MrMil/led-over-rj245/docs/field_docs/README.md

# Field docs

Path: [docs](../README.md) › **field_docs**
Parent: [../README.md](../README.md)

**Covers:** the human documentation — `README.md` and `guide/` — and the wiring diagrams in
`guide/img/`, generated by `tools/wiring_diagrams.py`.
**Code:** `README.md`, `guide/*.md`, `guide/img/*.svg`, `tools/wiring_diagrams.py`

## Design

### Decisions

- **The human guide roots at `README.md` and lives in `guide/`, apart from `docs/`** (owner,
  2026-10-09). The installation is erected and run by a crew the owner is not part of, who are
  not familiar with the design, reading on a phone at Midburn by opening the repo on GitHub.
  `docs/` is for agents and is about *why*; `guide/` is about *what to do*.
- **No backstory in the guide** (owner). It states facts and steps; it does not narrate who it
  is for or why it was written.
- **Build-specific only, written for experienced burners and makers** (owner, 2026-10-09).
  "Connect this to that", pin tables, settings, checks. No generic burn, site or tool advice
  (permission to dig, shade, MOOP, how a phone joins WiFi, what a WLED button does). The
  reader knows those, and including them reads as condescending.
  **Changed 2026-10-09:** the first version explained generic steps at length; the owner
  rejected it.
- **Phone-first formatting** (agent, 2026-10-09). Short sections, tables of at most four
  columns, no wide code blocks; GitHub renders Markdown and SVG in mobile browsers.
- **Troubleshooting is symptom → check, using swap tests** (agent, 2026-10-09). The
  installation is made of twins (statue boxes, cables, channels), so swapping isolates most
  faults with no instruments.
- **The crew never opens a box** (owner, 2026-10-28, told to the crew directly: there is
  exposed 230 V inside). So the guide carries nothing about the mains side of a box, including
  the C14 inlet wiring ([../strips_and_power/power_distribution.md](../strips_and_power/power_distribution.md),
  Gotchas). The troubleshooting steps that need a box open (swapping a 74AHCT125, a receiver
  or the ESP32, re-seating pigtails on screw terminals) stay, behind a warning at the top of
  `guide/troubleshooting.md`: call the owner before opening any box, and if he does not pick
  up, do not open it (owner, 2026-10-28). They are the only field fix for those faults, and
  the call puts the owner in the loop on the mains hazard before anyone reaches in.
- **The guide never mentions the inlet fuses** (owner, 2026-10-29). Every C14 inlet carries
  a spare fuse in its drawer, and the owner does not want the crew in there: a box that stays
  dead after cooling is a call to the owner. `guide/troubleshooting.md` says so; the spares
  bag carries no fuses. **Changed 2026-10-29:** previously the troubleshooting step was to
  check and replace the fuse, and the bag held spares.
- **Nothing is repaired on site, so the field spares are only what plugs in** (owner,
  2026-10-29: "the crew can't solder in the field"; "I have to make new ones and send it to
  them - they don't repair anything"). The bag holds the ESP32, MAX485 modules, 74AHCT125s
  and CAT5e; no strips, bespoke cables, XT60 or JST-SM pairs, solder or ferrules. A dead
  strip or damaged cable is reported to the owner, who makes a new one.
- **The crew pages use crew words, not part names; the owner's pages use part names** (owner,
  2026-10-29: "use it in places that concern the crew in the field ... the wiring guide is for
  me, I know what those things are"). Crew pages: `README.md`, `guide/setup.md`,
  `guide/operating.md`, `guide/troubleshooting.md`, `guide/inventory.md`. Owner's pages:
  `guide/wiring.md`, `guide/parts.md`, `guide/build.md` and the diagrams. On the crew pages:
  "3-pin LED connector" for JST-SM ("they don't know what JST-SM is"), "kettle lead" for a
  C13 cord (the Hebrew "כבל קומקום"; the English colloquial name, strictly for the C15 but
  used for C13 too) and "inlet" for the C14, "CAT5" for CAT5e, no cable specifications ("they don't need to know
  the specifications"), no enclosure names or wattages, no reels ("they don't know about
  reels"). Chip and module names (74AHCT125, MAX485, ESP32) stay, because the
  troubleshooting swap steps name the physical part the crew must pick out of the bag.
- **Secrets are not in the guide** — see [../firmware/README.md](../firmware/README.md).
- **The guide must stay consistent with these docs.** When a decision here changes something
  a builder or operator does, update the matching guide page in the same change.

## Contents

### Pages

- [`wiring_diagrams.md`](wiring_diagrams.md) — why the diagrams are generated SVG and how they are drawn.

### Not yet documented

- **Guide pages** — `guide/setup.md`, `guide/operating.md`, `guide/troubleshooting.md`, `guide/wiring.md`, `guide/parts.md`, `guide/inventory.md`, `guide/build.md` — content follows the design pages in this tree; page-specific decisions are recorded above. `guide/inventory.md` (owner asked, 2026-10-29) counts what exists, box by box and cable by cable with lengths, where `guide/parts.md` is the shopping list by part; the cable-length margins are in [../strips_and_power/trenches.md](../strips_and_power/trenches.md).

## Related

- [../README.md](../README.md) — the design the guide describes.
- [../strips_and_power/README.md](../strips_and_power/README.md) — exit numbering used throughout the guide.
