MrMil/led-over-rj245/docs/firmware/controller_files.md

# Controller files

Path: [docs](../README.md) › [firmware](README.md) › **controller_files**
Parent: [README.md](README.md)
**Code:** `wled/cfg.json`, `wled/ledmap.json` (generated by `tools/wled_image.py`), `wled/presets.json` (the owner's
playlist, [README.md](README.md) *The show*); the flash procedure below
**Covers:** what is on the controller's filesystem besides the firmware, where each file comes from, and how the whole
thing gets onto an ESP32 over USB. Not the firmware build itself ([parallel_i2s_bus.md](parallel_i2s_bus.md)).

## The files

| File | What | Source |
|---|---|---|
| `cfg.json` | The 14 outputs (pin, LED count, GRB, 118 mA per LED, limiter off), the access point, the show as boot preset, no auto-segments | `tools/wled_image.py` from the GPIO table and tower heights in `tools/wiring_diagrams.py` |
| `ledmap.json` | The rolled 2D map: 14 columns × 111 rows, one column per tower, LED 0 at the bottom, short towers bottom-aligned, `-1` above them | `tools/wled_image.py` |
| `presets.json` | The show | the owner, exported from the Animations tab |

`python3 tools/wled_image.py` rewrites the first two; `wled/presets.json` is never generated.

## Decisions

- **The access point is "Layers-WLED", channel 6, always on** (owner, 2026-10-26, the name and password; channel
  and behaviour from [README.md](README.md)). **Changed 2026-10-26:** the SSID was to avoid the word "WLED"
  (agent, 2026-10-09, so the WLED app and passers-by would not spot it); the owner chose a name with it in.
- **The password goes only into the flashed image, from the `WLED_AP_PASS` environment variable** (agent,
  2026-10-26, carrying out the owner's rule that it is never committed, [README.md](README.md)). `wled/cfg.json`
  in the repository has no `psk` key, so a restore from it keeps whatever password the controller has; the image
  built with `--image` has the key. WLED's own backup does not write the password either (`pskl`, its length,
  only), so a backup from the controller can be committed as it is.
- **The config goes in as a LittleFS image over USB, not through the web UI** (agent, 2026-10-24, from the bench
  in [output_driver.md](output_driver.md)): WLED takes only state JSON over serial, not config, and joining the
  controller's AP from the development machine would cut its internet. The image holds all three files, so one
  flash gives a complete controller; *Restore* in the UI stays the field route ([../field_docs/README.md](../field_docs/README.md),
  `guide/build.md`).
- **The current limiter is off (`maxpwr` 0) and the per-LED current is 118 mA** (limiter off: owner, 2026-10-26;
  118 mA: agent, 2026-10-26). No supply
  reaches its ceiling even at full white ([../strips_and_power/led_power_budget.md](../strips_and_power/led_power_budget.md)),
  WLED's limiter is per output and cannot see supply groups ([README.md](README.md), *No current limiting*), and the
  bench ran with it off. 118 mA is 4 × the measured 29.4 mA at full white, because WLED sees one face per output
  and the tower has four; with the limiter off it only makes the Info page's estimate right.
- **Boot preset 18, brightness 255, no auto-segments** (owner: the show resumes by itself after a power cut; one
  segment over everything is what the presets apply to, [effects_in_browser.md](effects_in_browser.md)).
- **The map carries `width` and `height`**, which is what makes WLED treat the strip as a matrix, so the show's
  2D-only effects (the particle ones, Soap, Hiphotic, Octopus) run; without it they fall back to a static colour.

## Flashing a controller

From `../WLED`, with PlatformIO (installed in a throwaway venv; nothing is installed on the machine):

```
python3 -m venv <dir>/pioenv && <dir>/pioenv/bin/pip install platformio
<dir>/pioenv/bin/pio run -e esp32dev_rj245 -t upload --upload-port /dev/cu.usbserial-XXXX
```

Then the files, from this repository:

```
WLED_AP_PASS=<password> python3 tools/wled_image.py --image <dir>/wled_fs.bin
<dir>/pioenv/bin/python ~/.platformio/packages/tool-esptoolpy/esptool.py --port /dev/cu.usbserial-XXXX write_flash 0x310000 <dir>/wled_fs.bin
```

`0x310000` is the filesystem partition of WLED's 4 MB layout (`tools/WLED_ESP32_4MB_1MB_FS.csv` in the fork), the
board's flash size ([../controller/README.md](../controller/README.md)). The image is built with the `mklittlefs`
PlatformIO fetched for the bench. Flash the firmware first: the firmware upload does not touch the filesystem
partition, and the file image does not touch the firmware, so either can be redone alone.

## Related

- [README.md](README.md) — the show, the preset numbering, the AP decisions these files carry out.
- [parallel_i2s_bus.md](parallel_i2s_bus.md) — the firmware the files sit beside.
- [output_driver.md](output_driver.md) — the bench, where the image route came from.
- [custom_effects.md](custom_effects.md) — the effects the presets can name.
