MrMil/led-over-rj245/art/back1-design.png

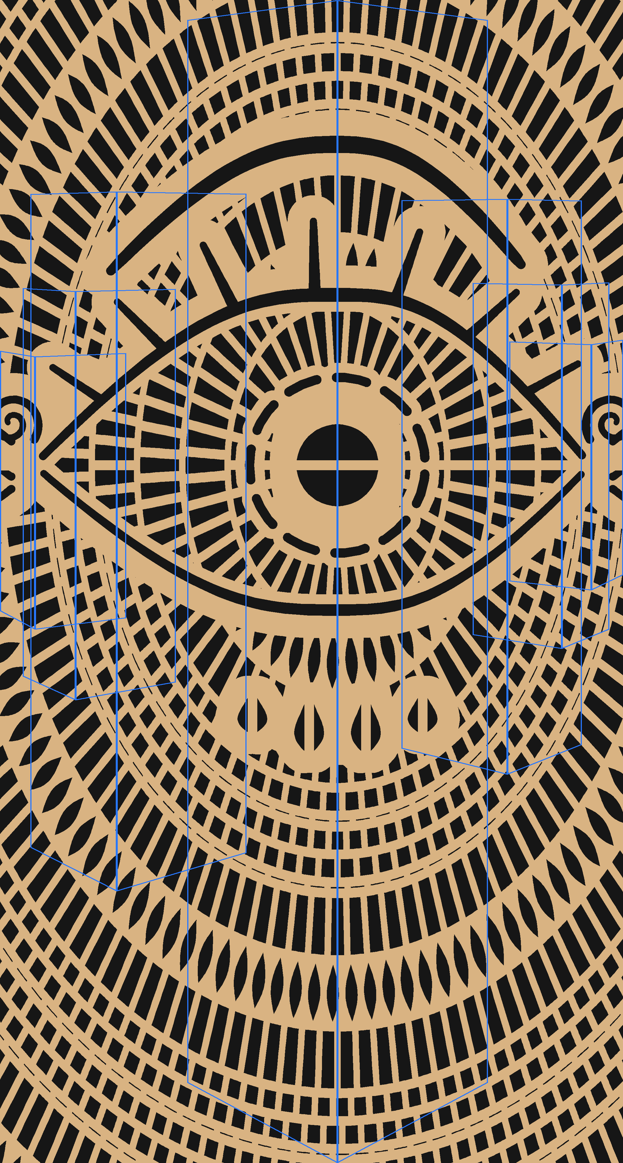
art/back1-design.png
