MrMil/led-over-rj245/art/back1-preview.png

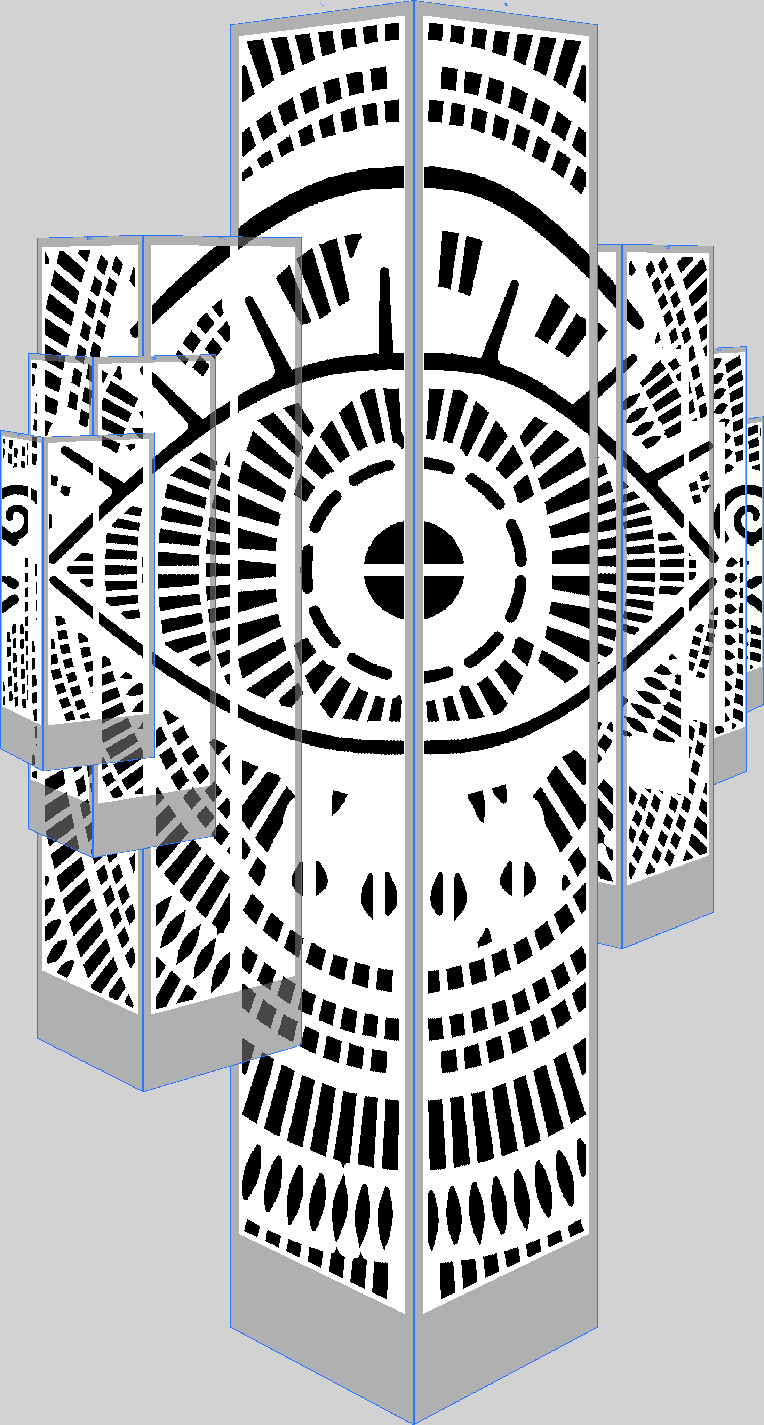
art/back1-preview.png
