MrMil/led-over-rj245/art/back1-towers.png

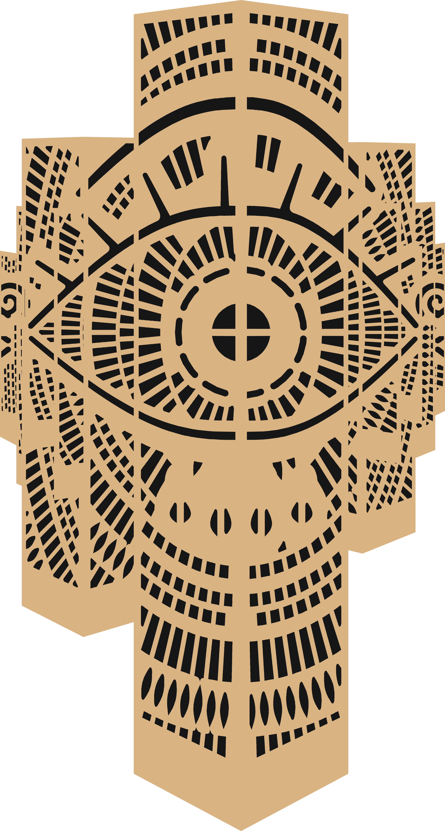
art/back1-towers.png
