MrMil/led-over-rj245/art/back1.png

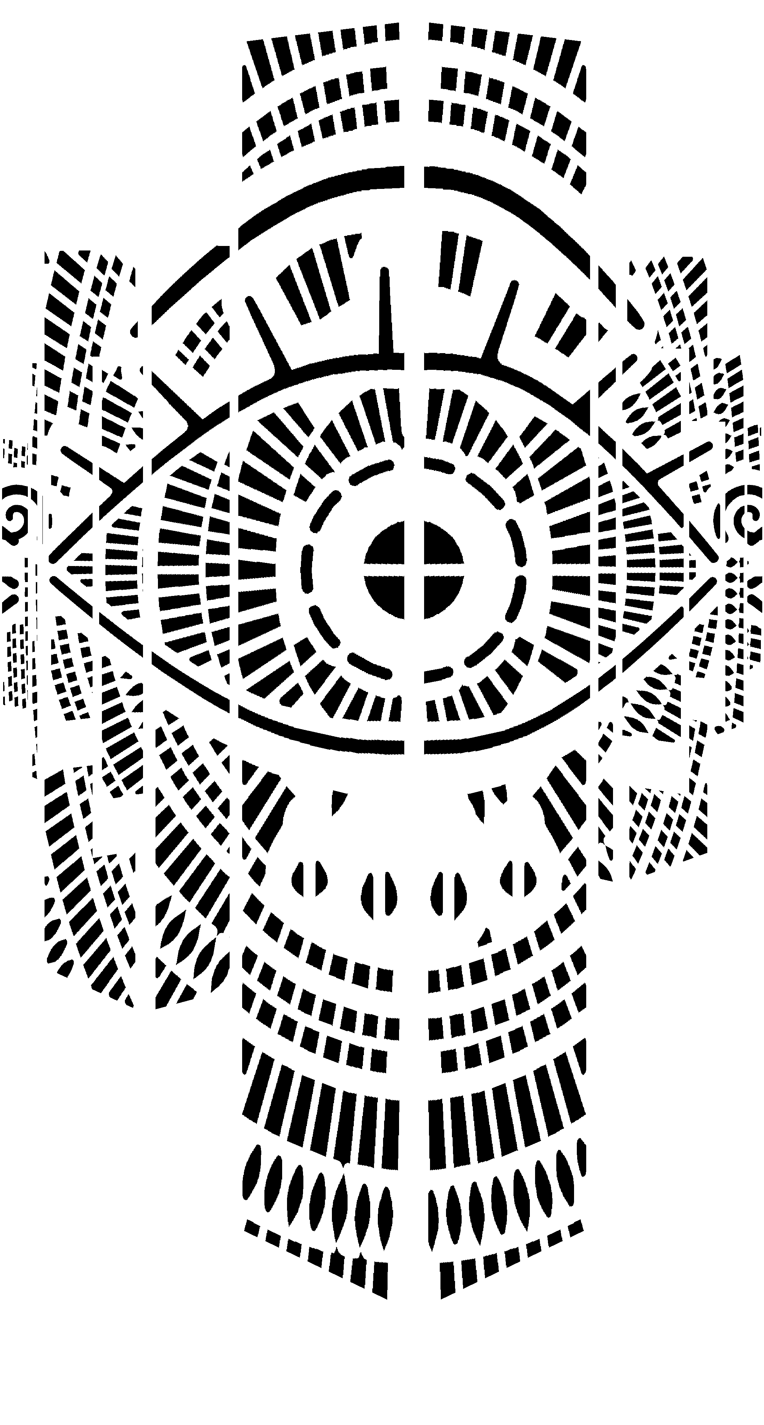
art/back1.png
