MrMil/led-over-rj245/art/back2-design.png

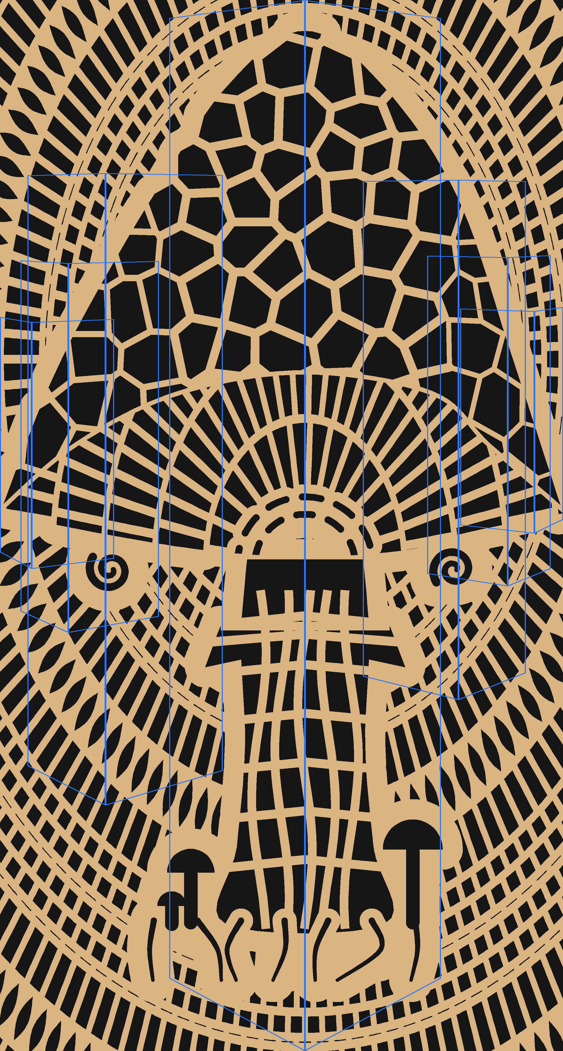
art/back2-design.png
