MrMil/led-over-rj245/art/back2-preview.png

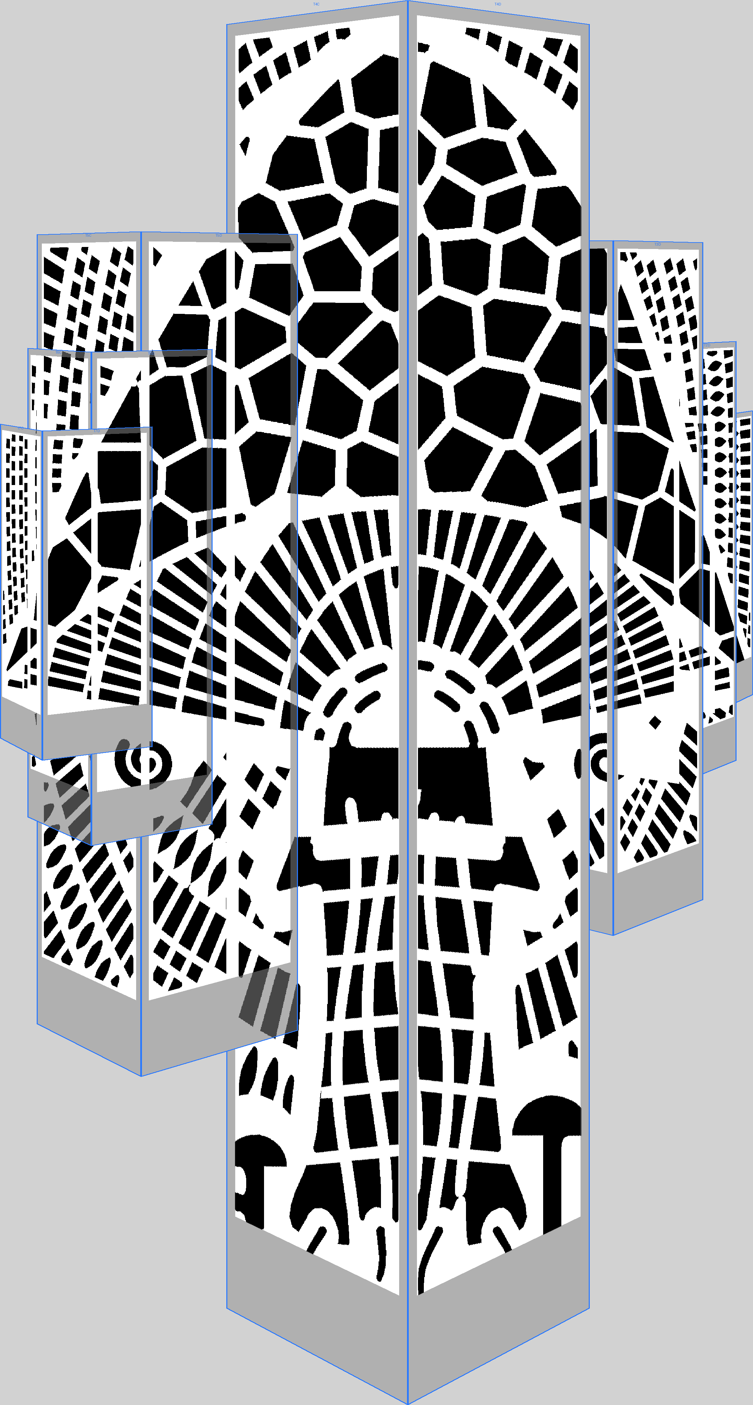
art/back2-preview.png
