MrMil/led-over-rj245/art/back2-towers.png

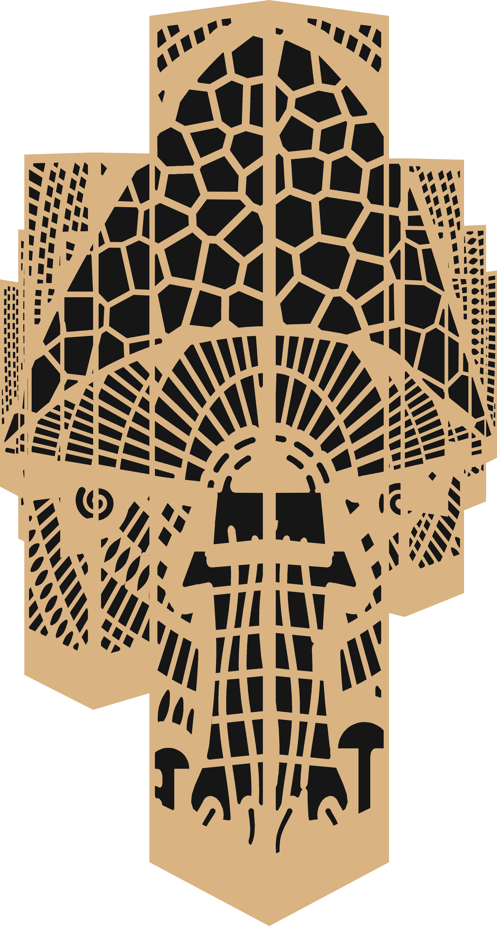
art/back2-towers.png
