MrMil/led-over-rj245/art/back2.png

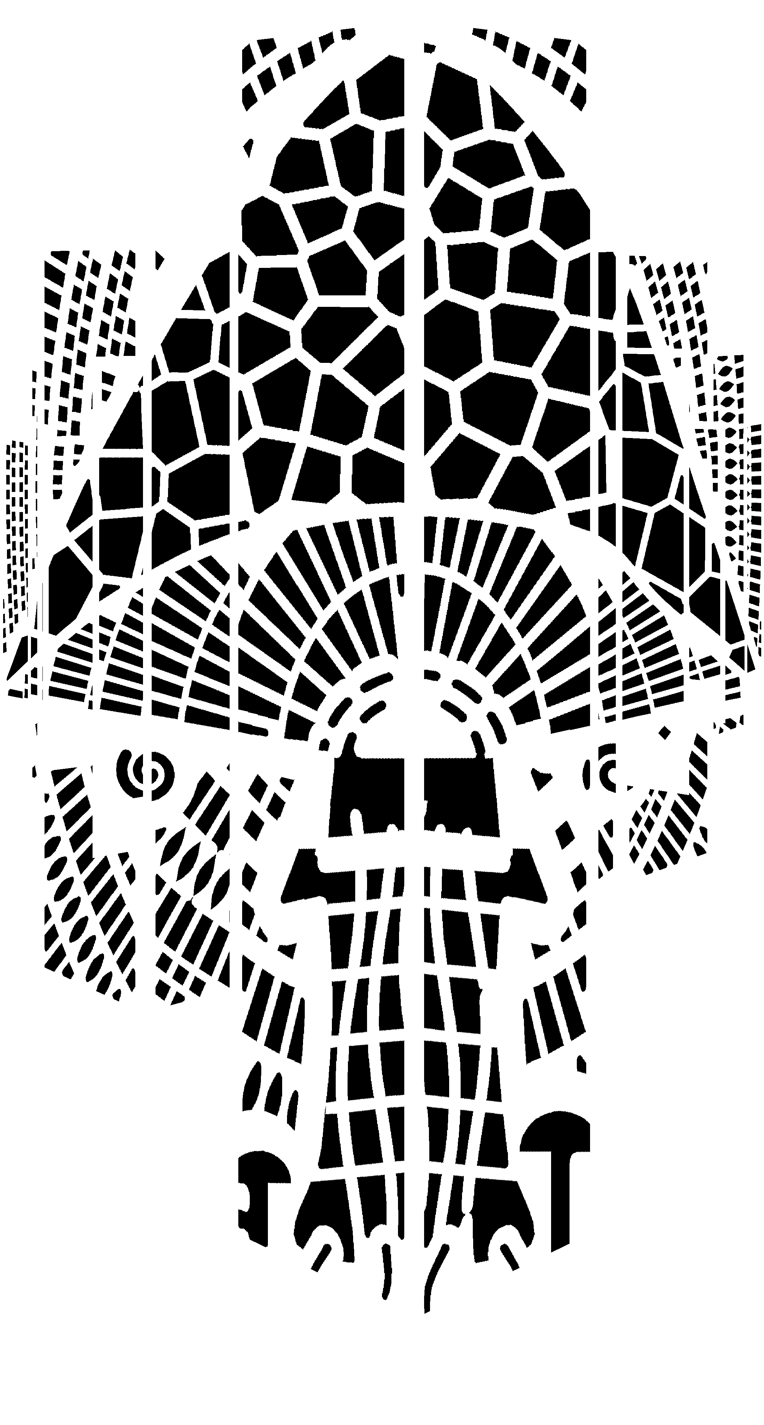
art/back2.png
