MrMil/led-over-rj245/art/bench1-design.png

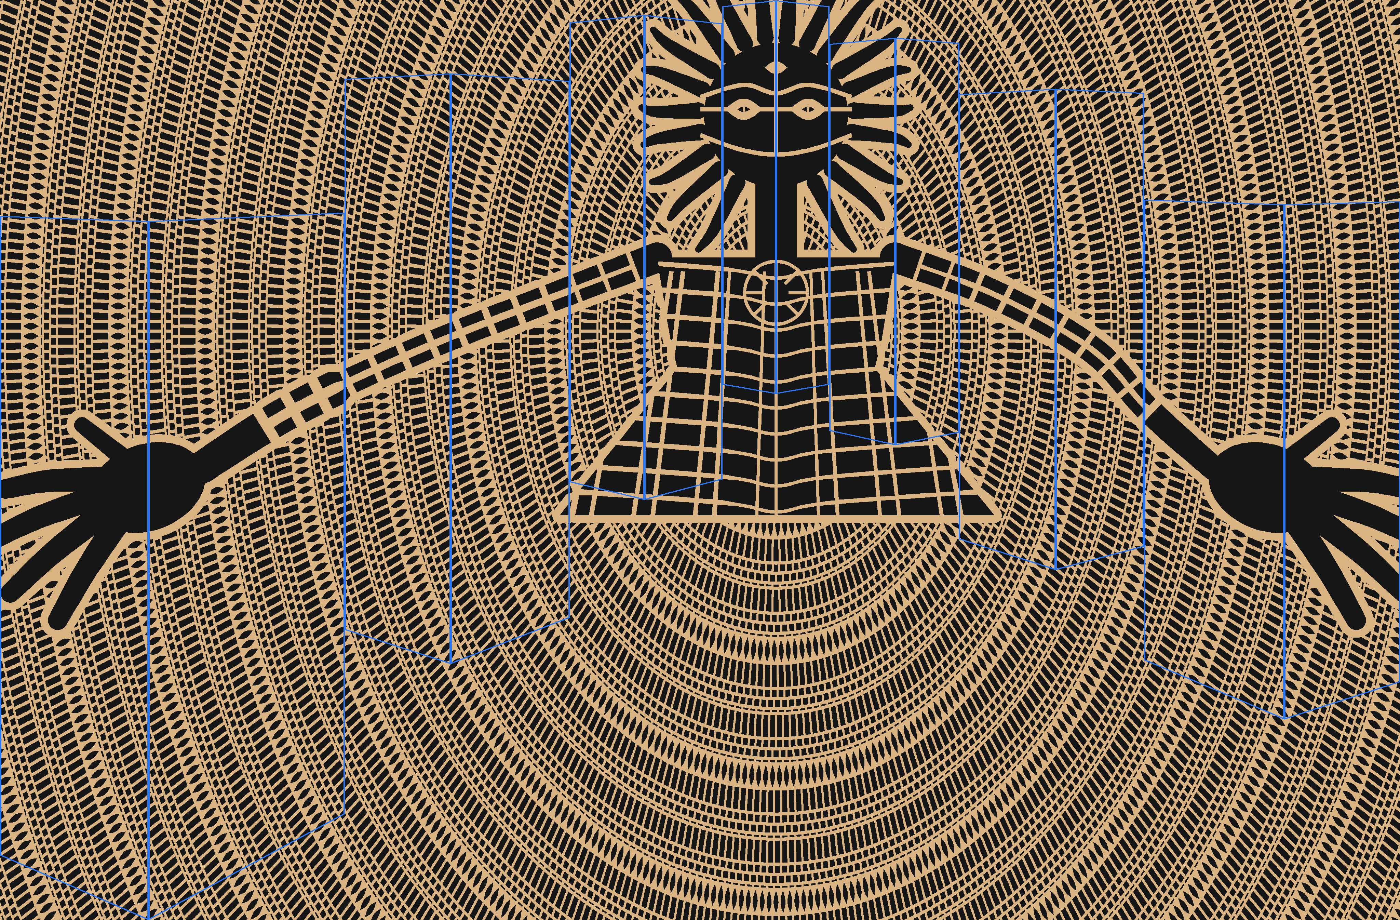
art/bench1-design.png
