MrMil/led-over-rj245/art/bench1-preview.png

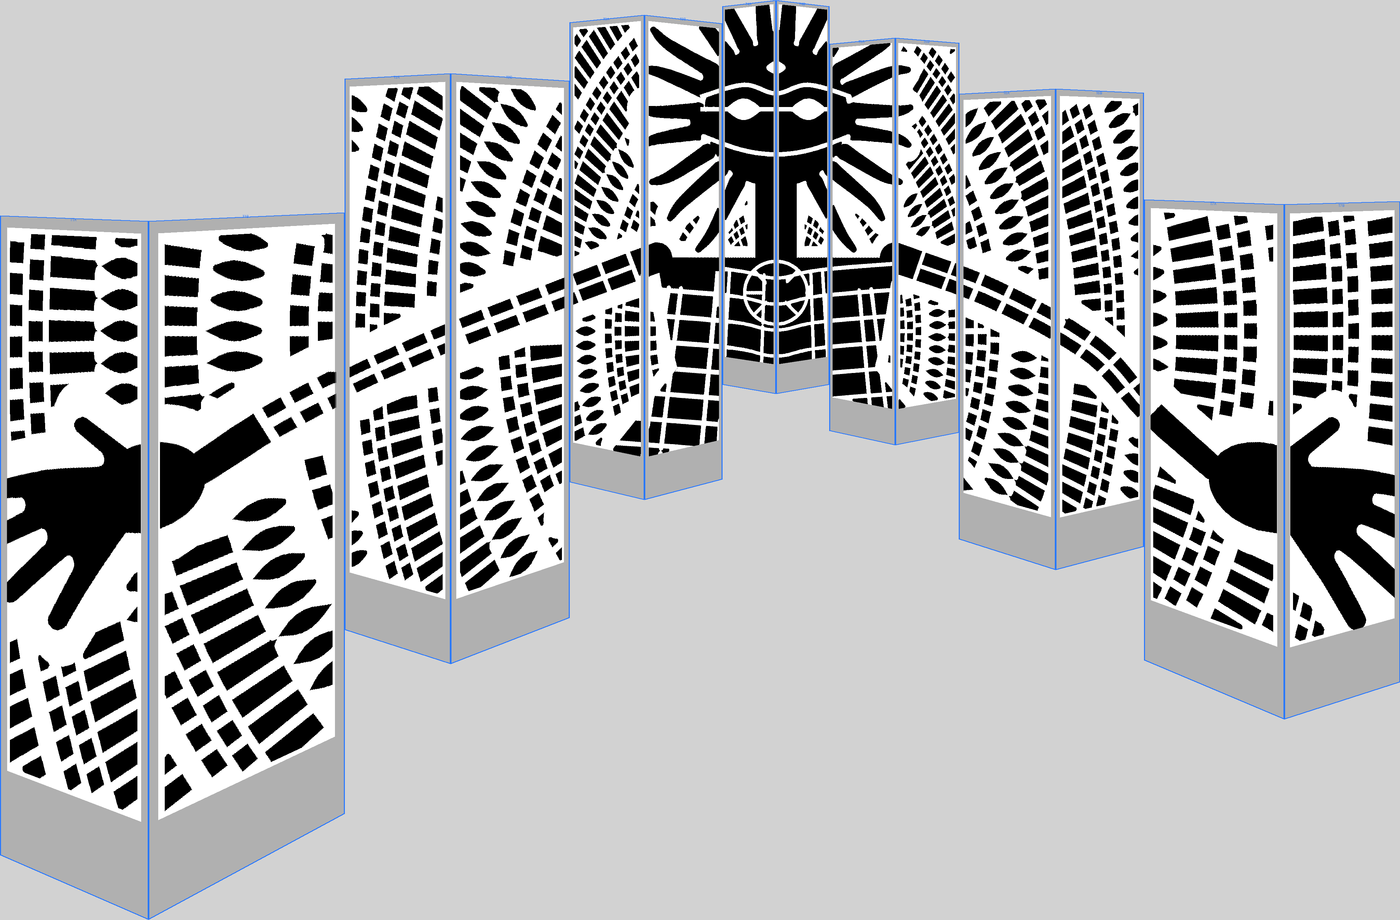
art/bench1-preview.png
