MrMil/led-over-rj245/art/bench1-towers.png

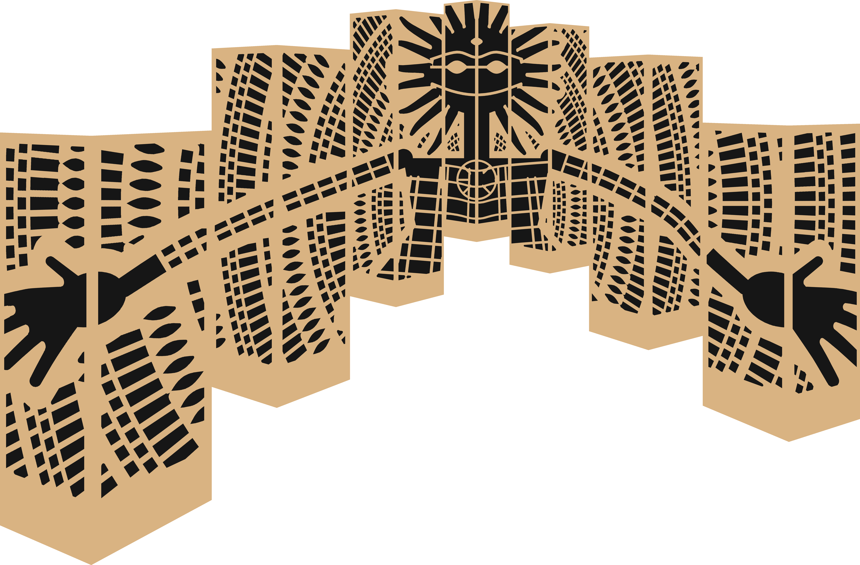
art/bench1-towers.png
