MrMil/led-over-rj245/art/bench1.png

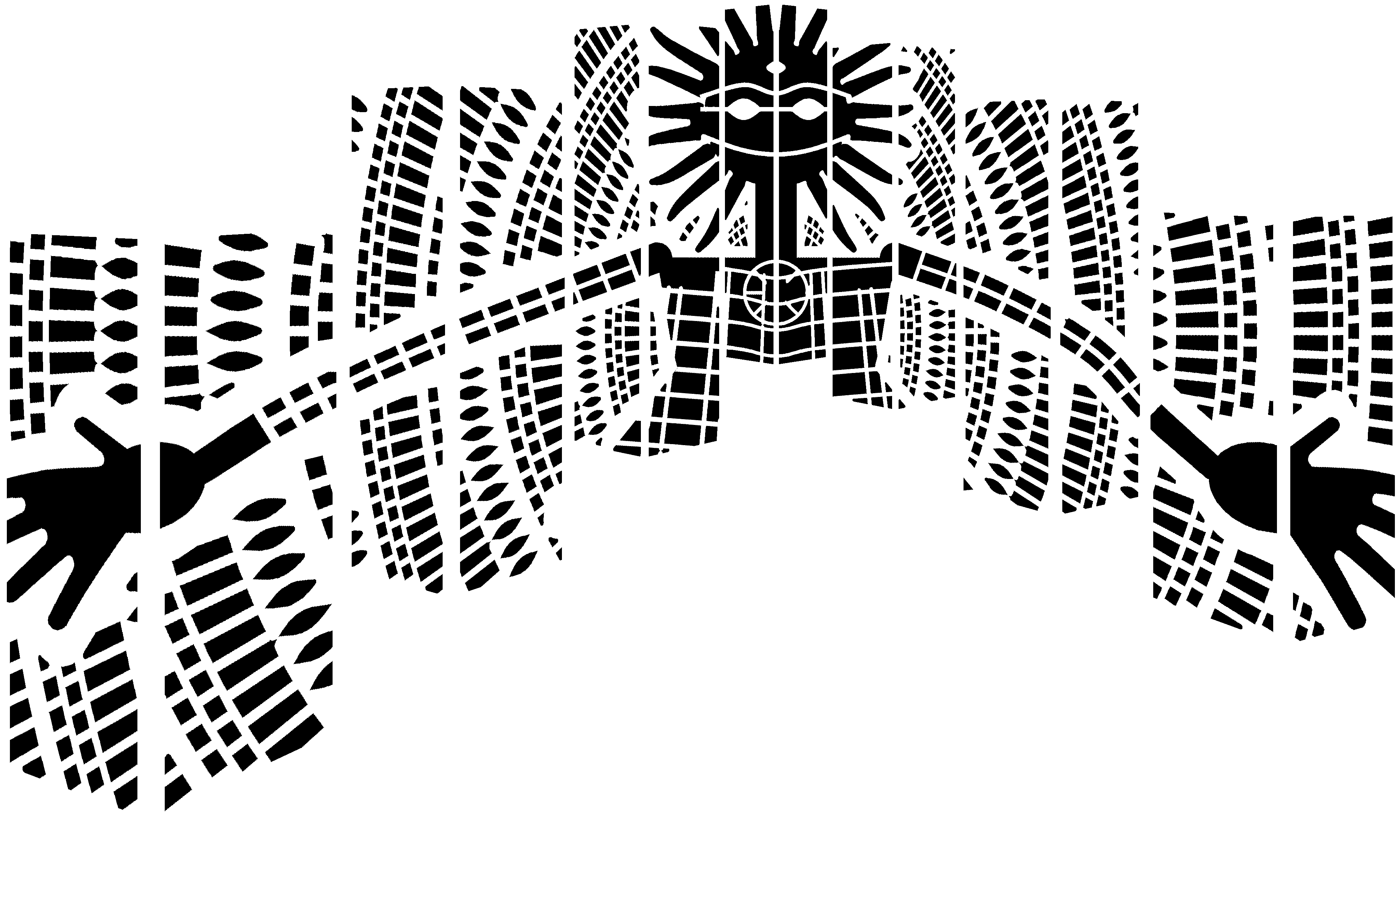
art/bench1.png
