MrMil/led-over-rj245/art/bench2-design.png

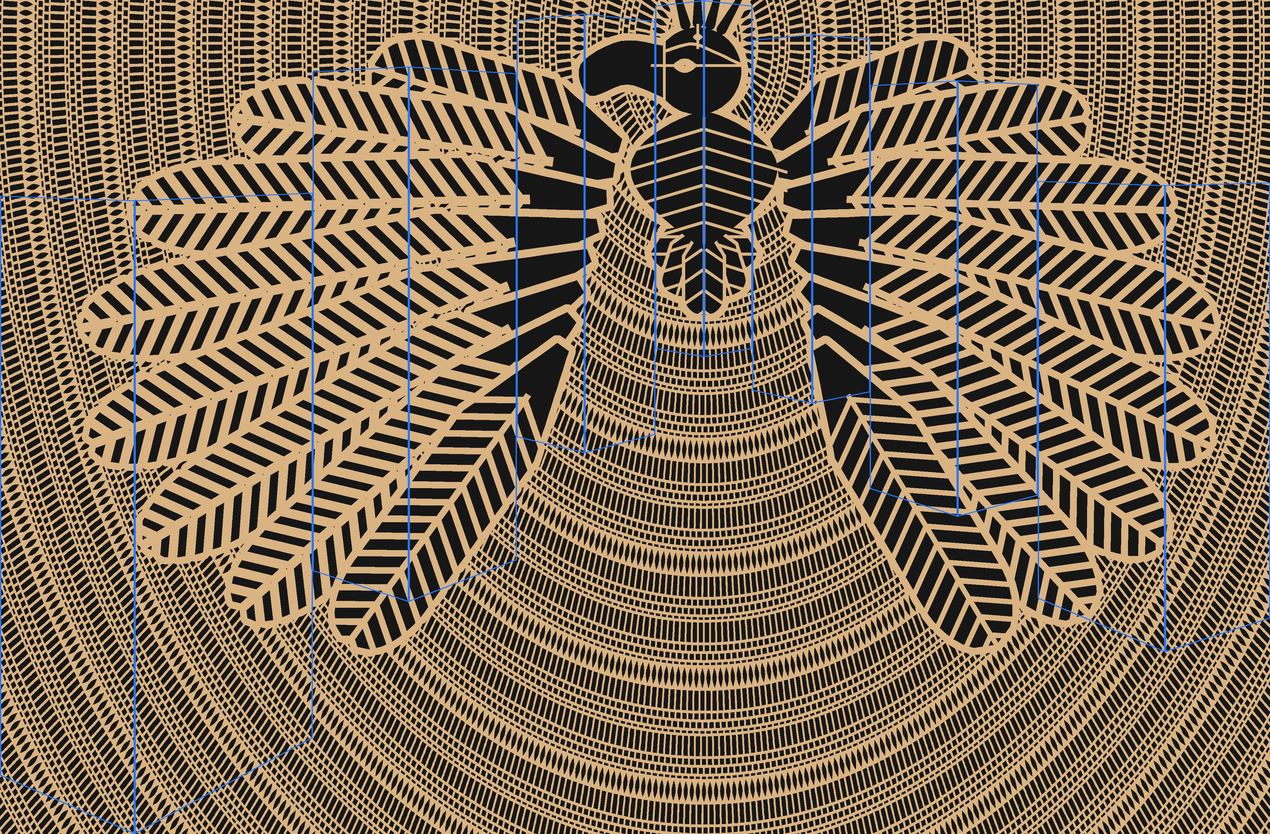
art/bench2-design.png
