MrMil/led-over-rj245/art/bench2-preview.png

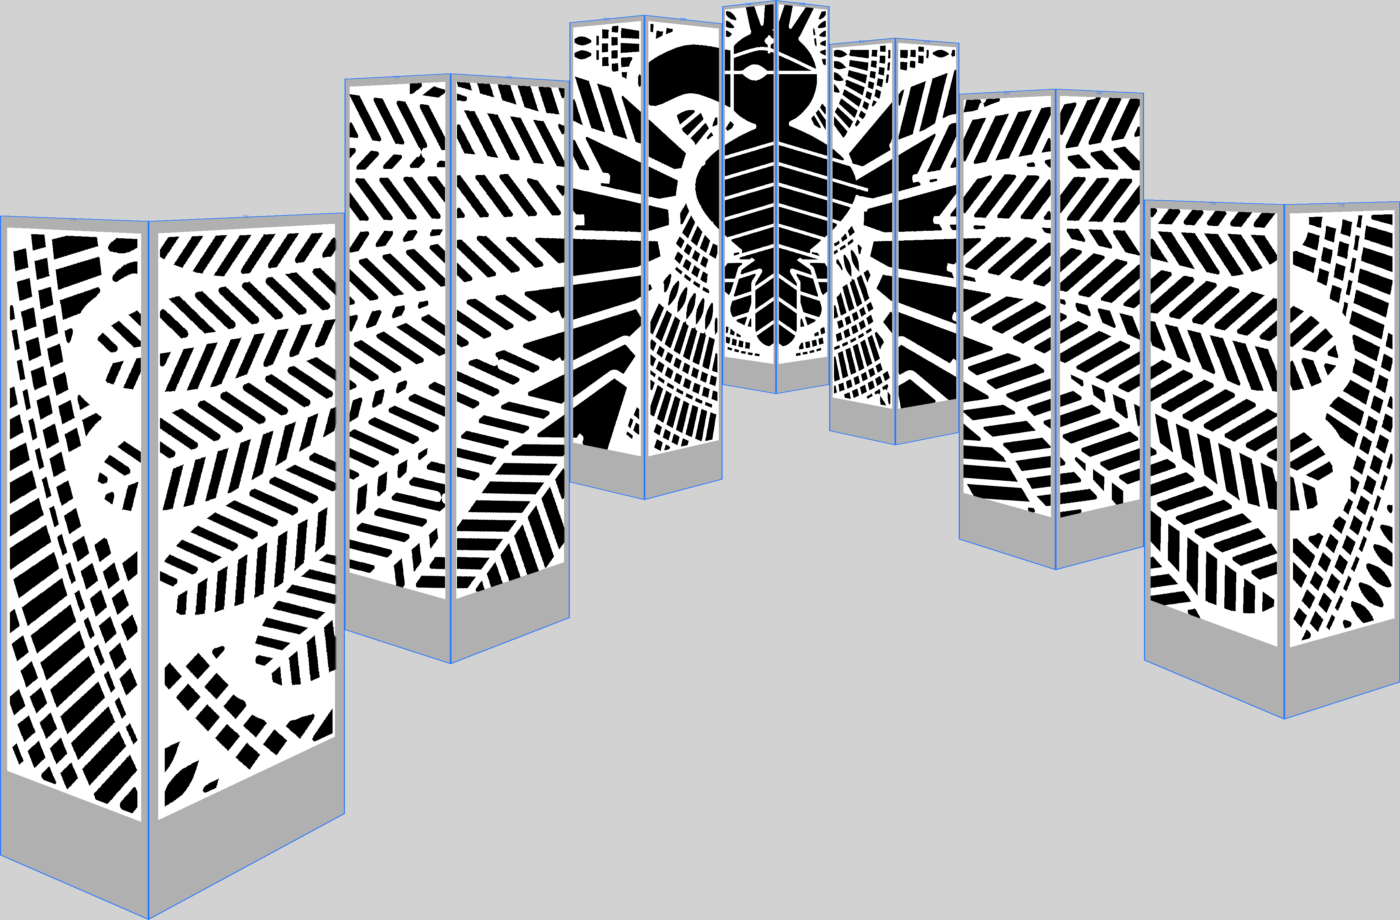
art/bench2-preview.png
