MrMil/led-over-rj245/art/bench2-towers.png

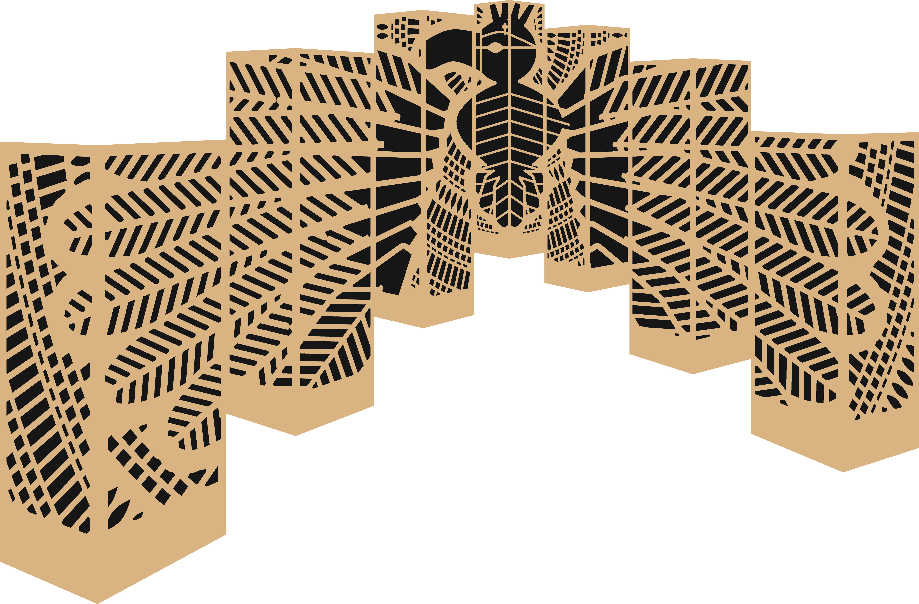
art/bench2-towers.png
