MrMil/led-over-rj245/art/bench2.png

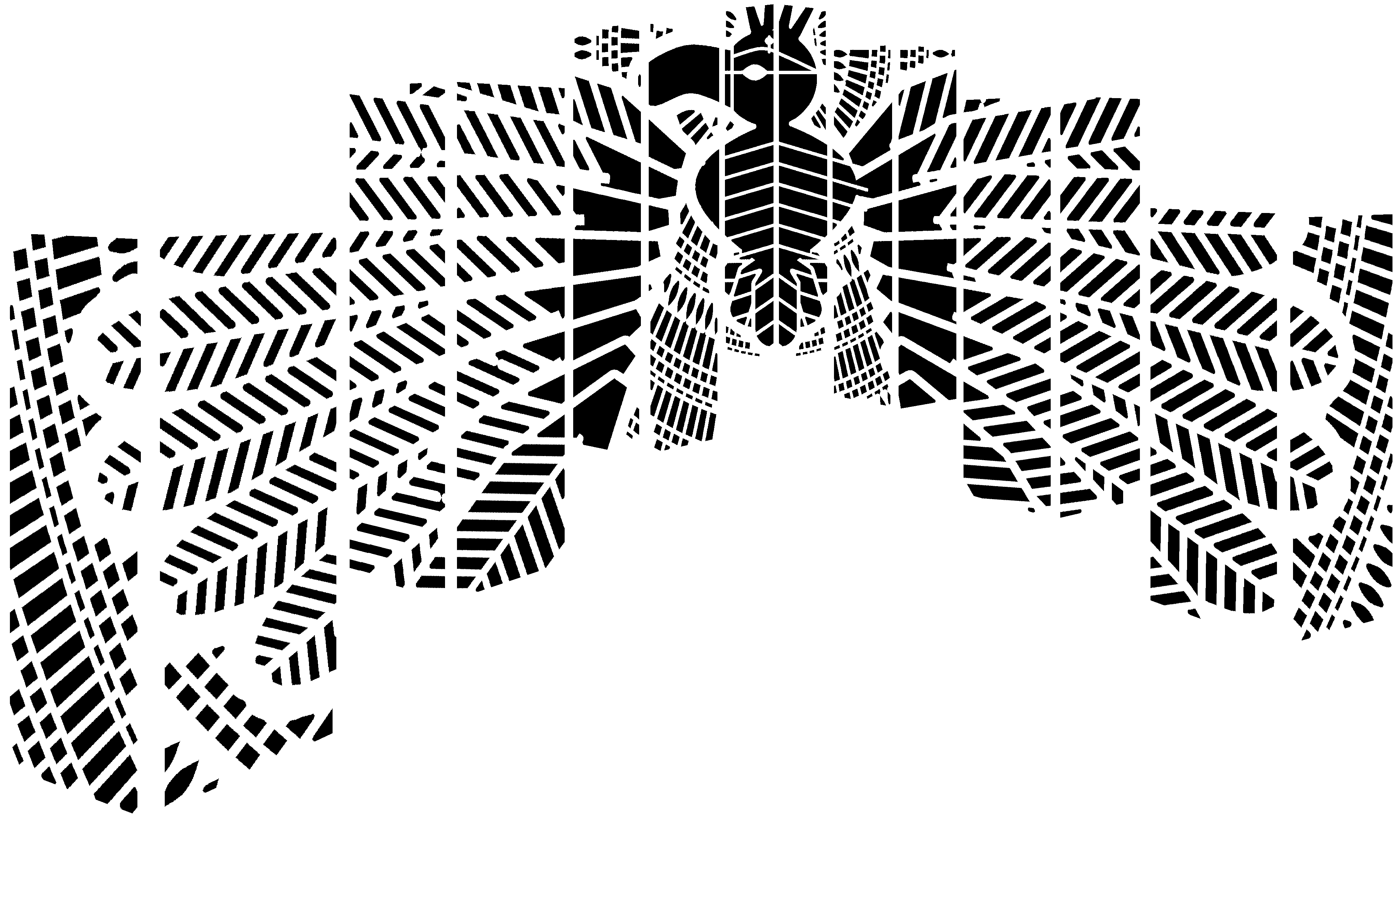
art/bench2.png
