MrMil/led-over-rj245/art/dancing/cut/plates.png

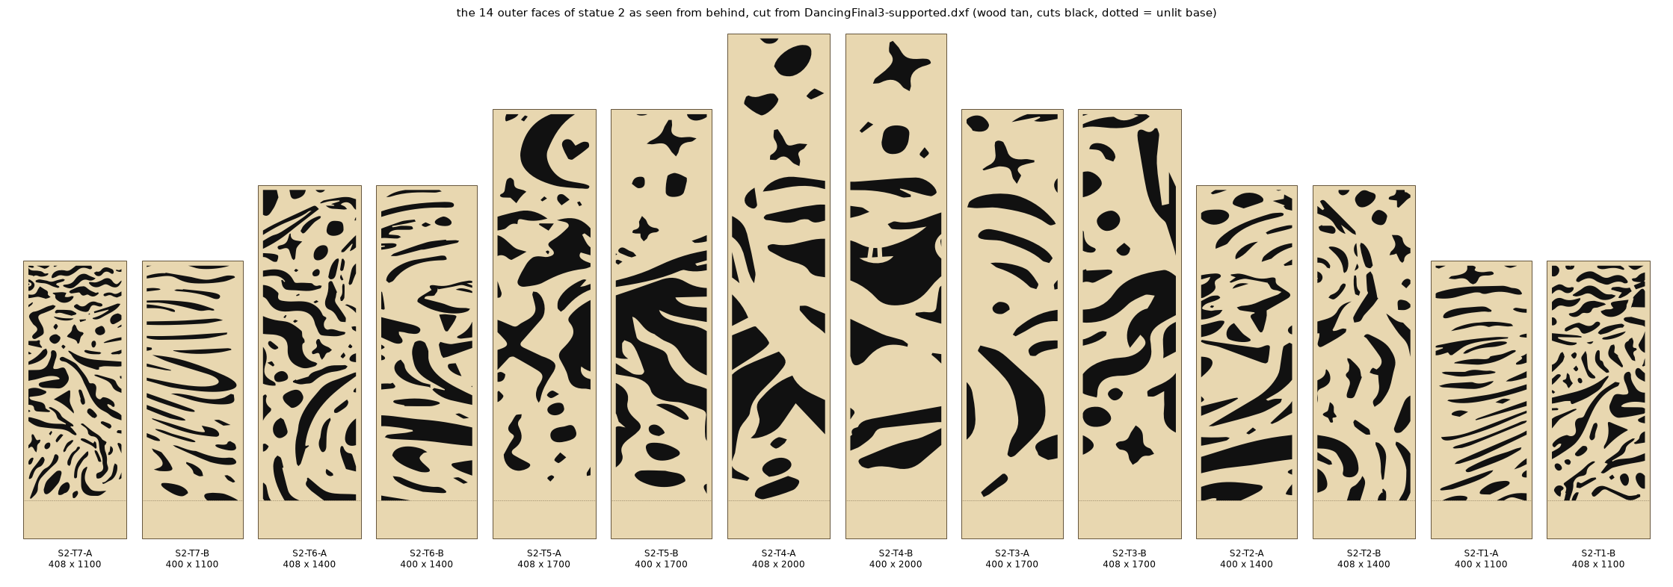
art/dancing/cut/plates.png
