MrMil/led-over-rj245/art/dancing/DancingFinal3-check.png

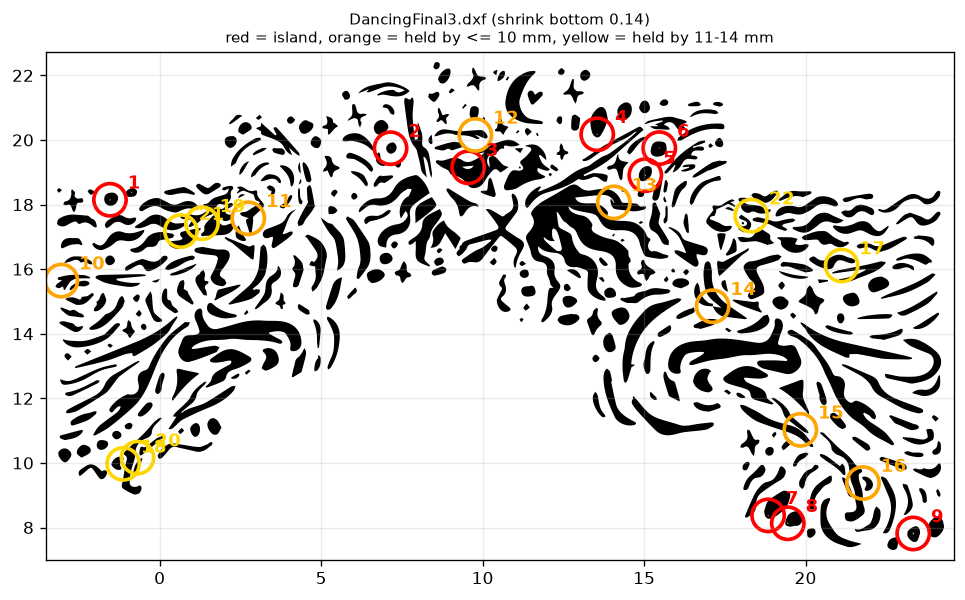
art/dancing/DancingFinal3-check.png
