MrMil/led-over-rj245/art/dancing/DancingFinal3-plates.png

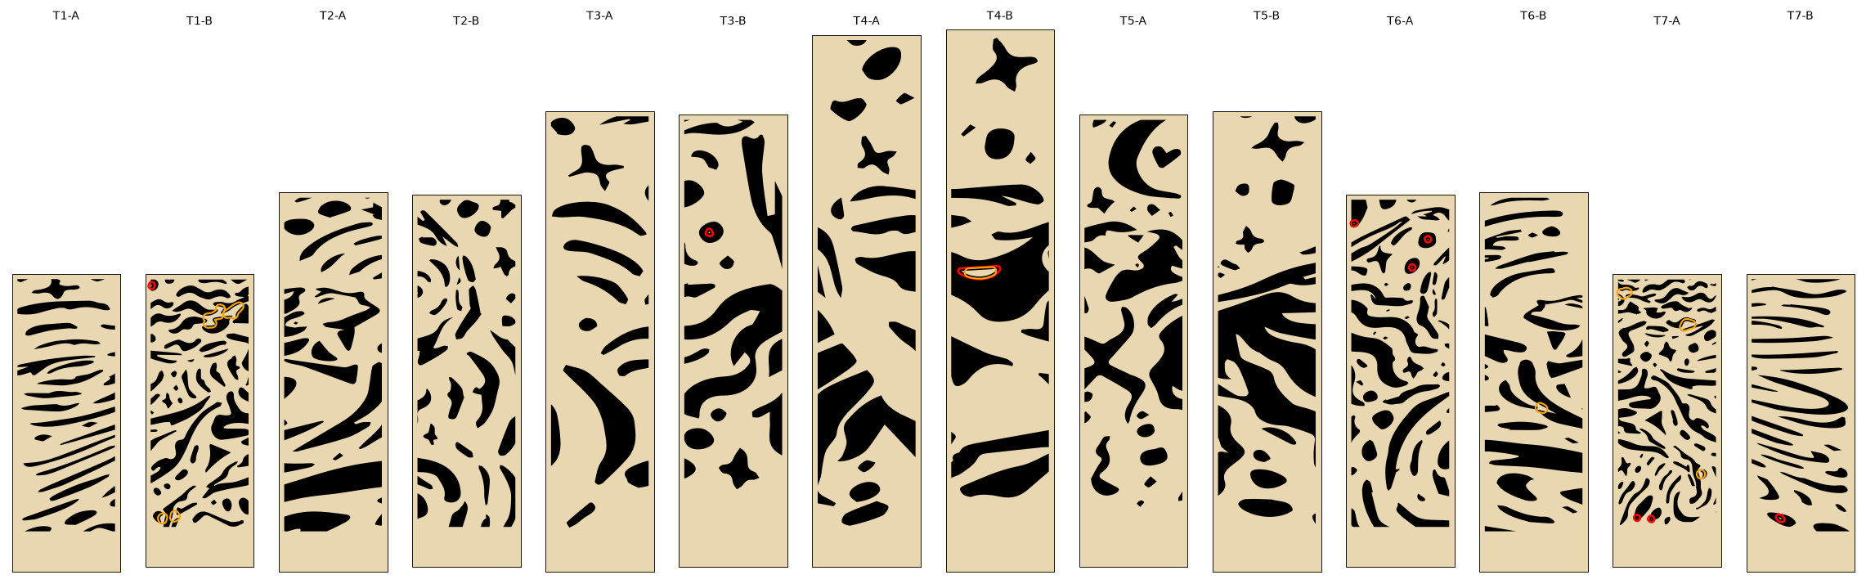
art/dancing/DancingFinal3-plates.png
