MrMil/led-over-rj245/art/dancing/DancingFinal3-supported-check.png

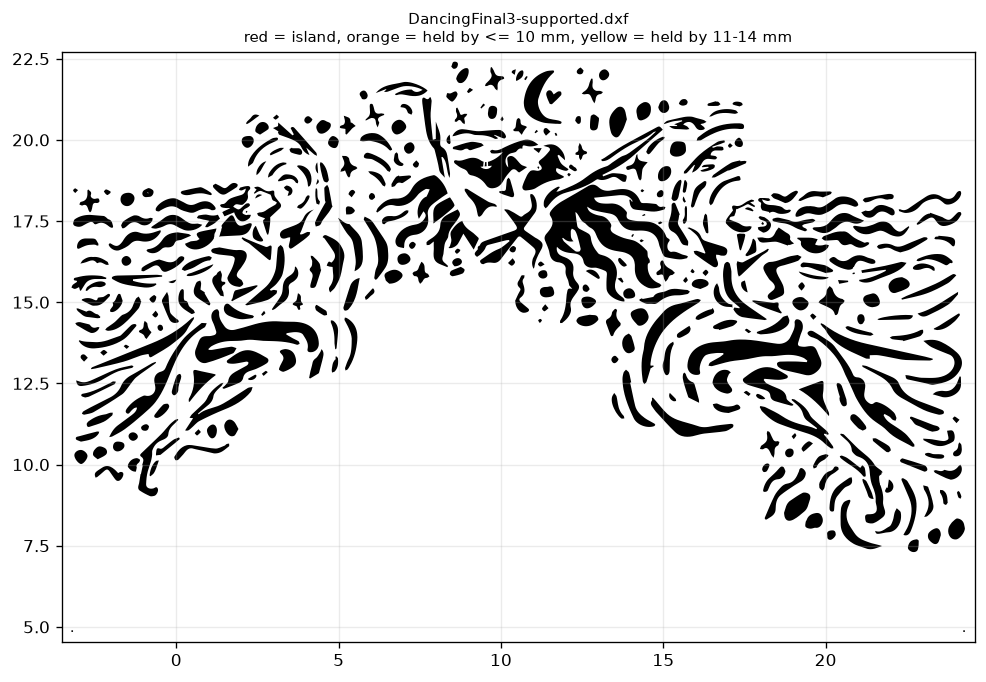
art/dancing/DancingFinal3-supported-check.png
