MrMil/led-over-rj245/art/dancing/DancingFinal3-supported.png

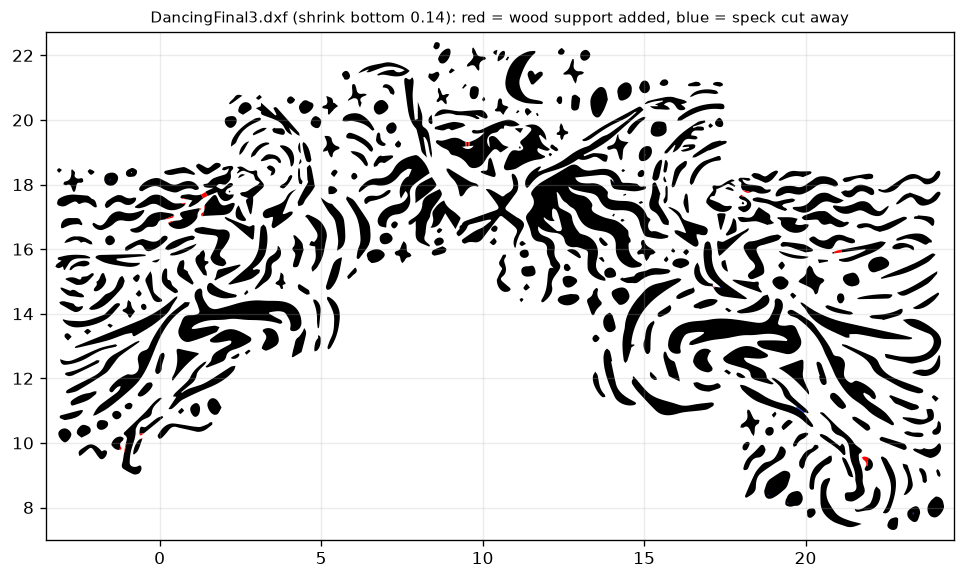
art/dancing/DancingFinal3-supported.png
