MrMil/led-over-rj245/art/dancing/DancingFinal3-supports-sheet.png

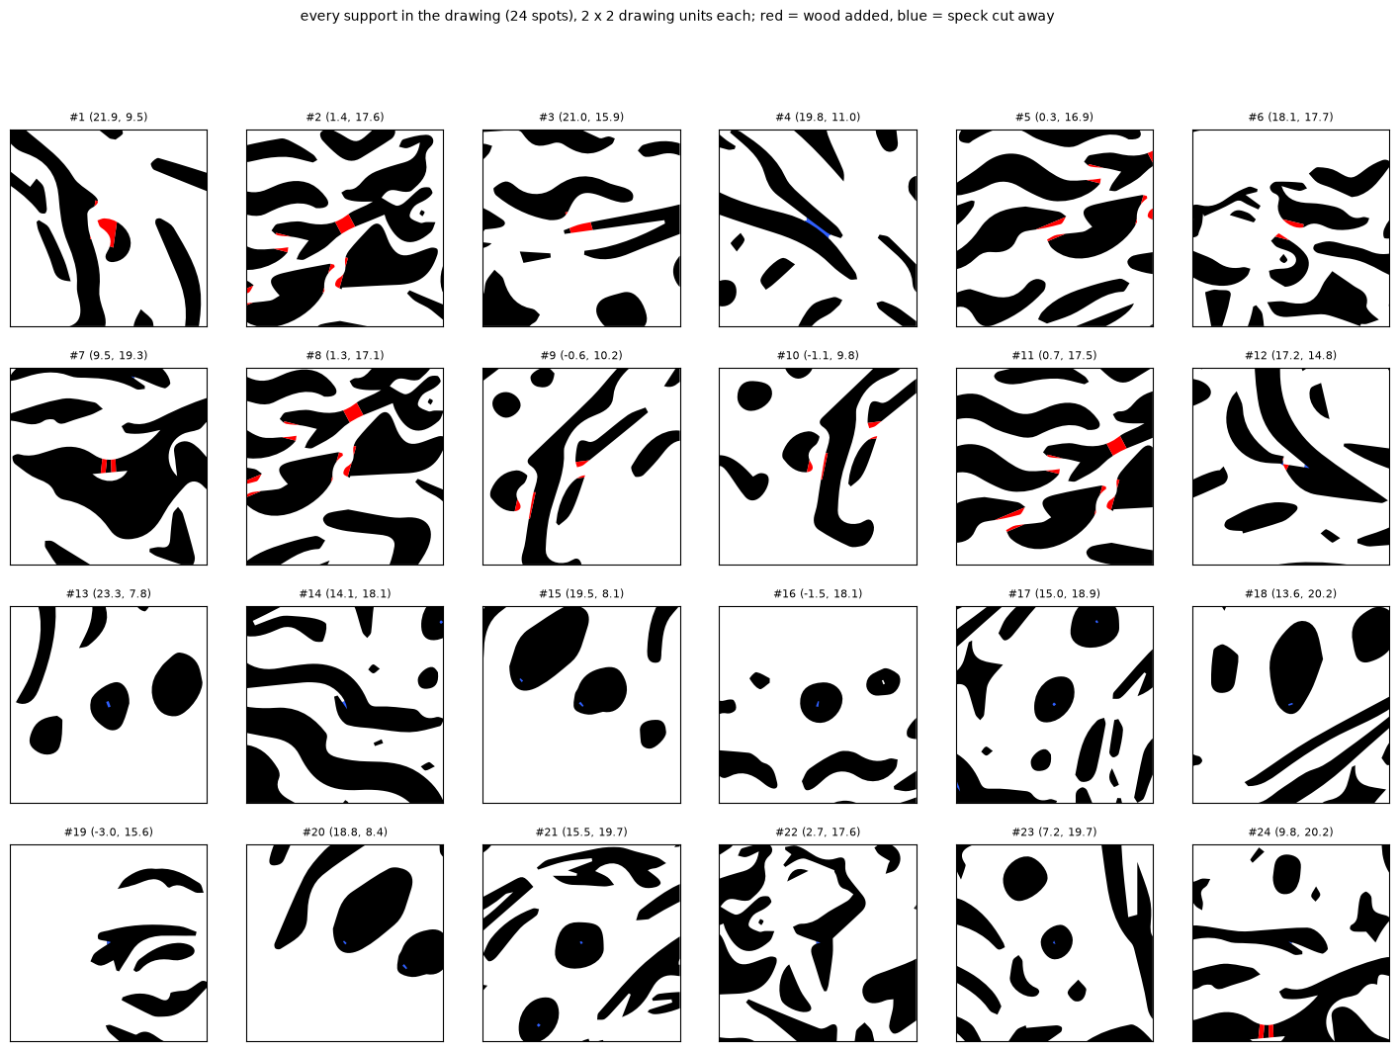
art/dancing/DancingFinal3-supports-sheet.png
