MrMil/led-over-rj245/art/eye/cut/plates.png

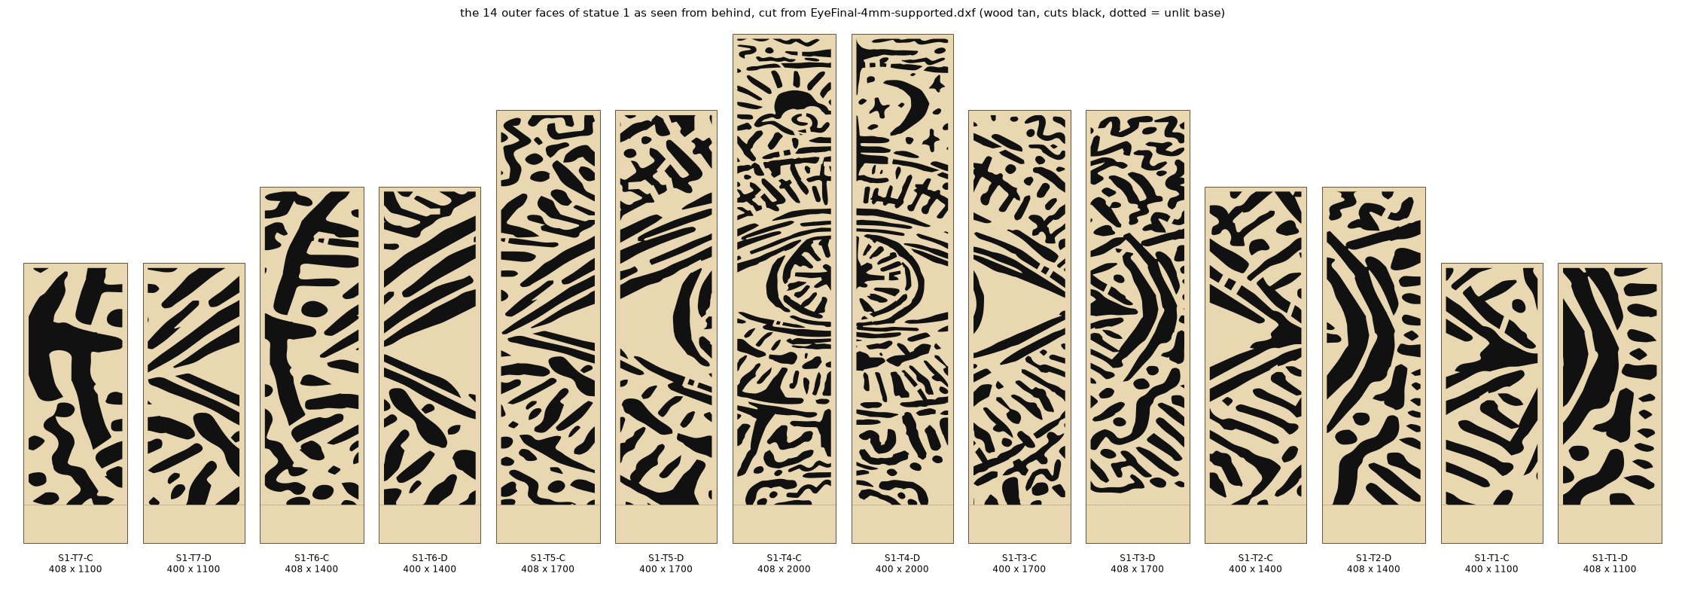
art/eye/cut/plates.png
