MrMil/led-over-rj245/art/eye/EyeFinal-4mm-check.png

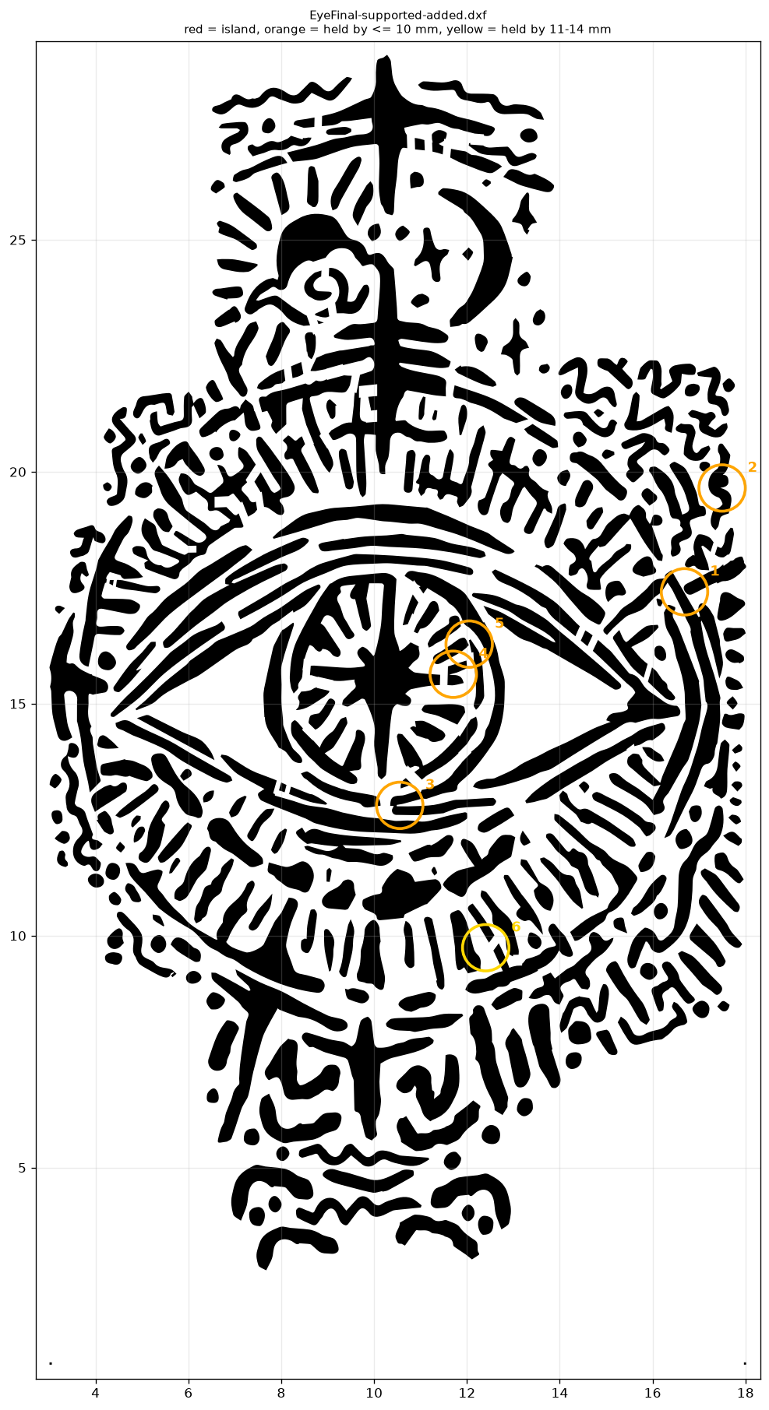
art/eye/EyeFinal-4mm-check.png
