MrMil/led-over-rj245/art/eye/EyeFinal-4mm-plates.png

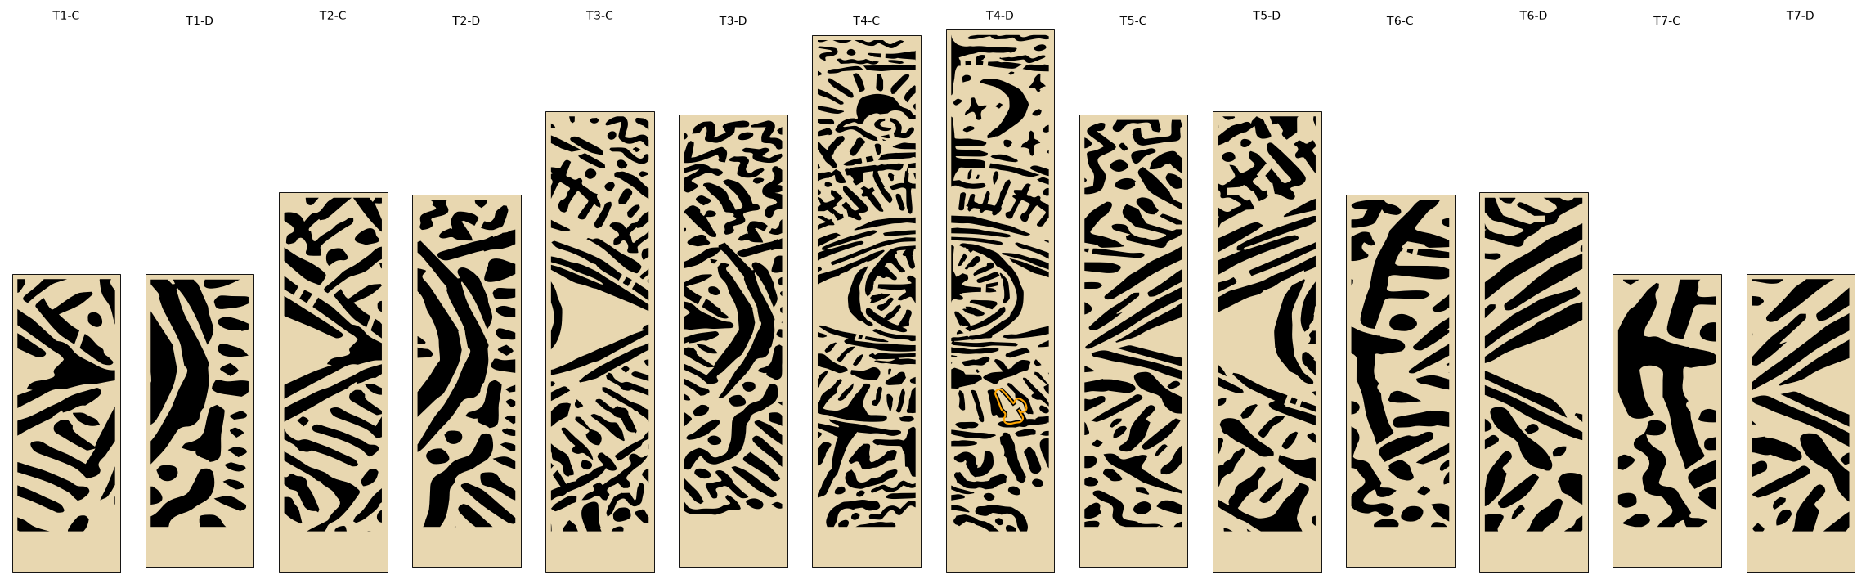
art/eye/EyeFinal-4mm-plates.png
