MrMil/led-over-rj245/art/eye/EyeFinal-4mm-supported.png

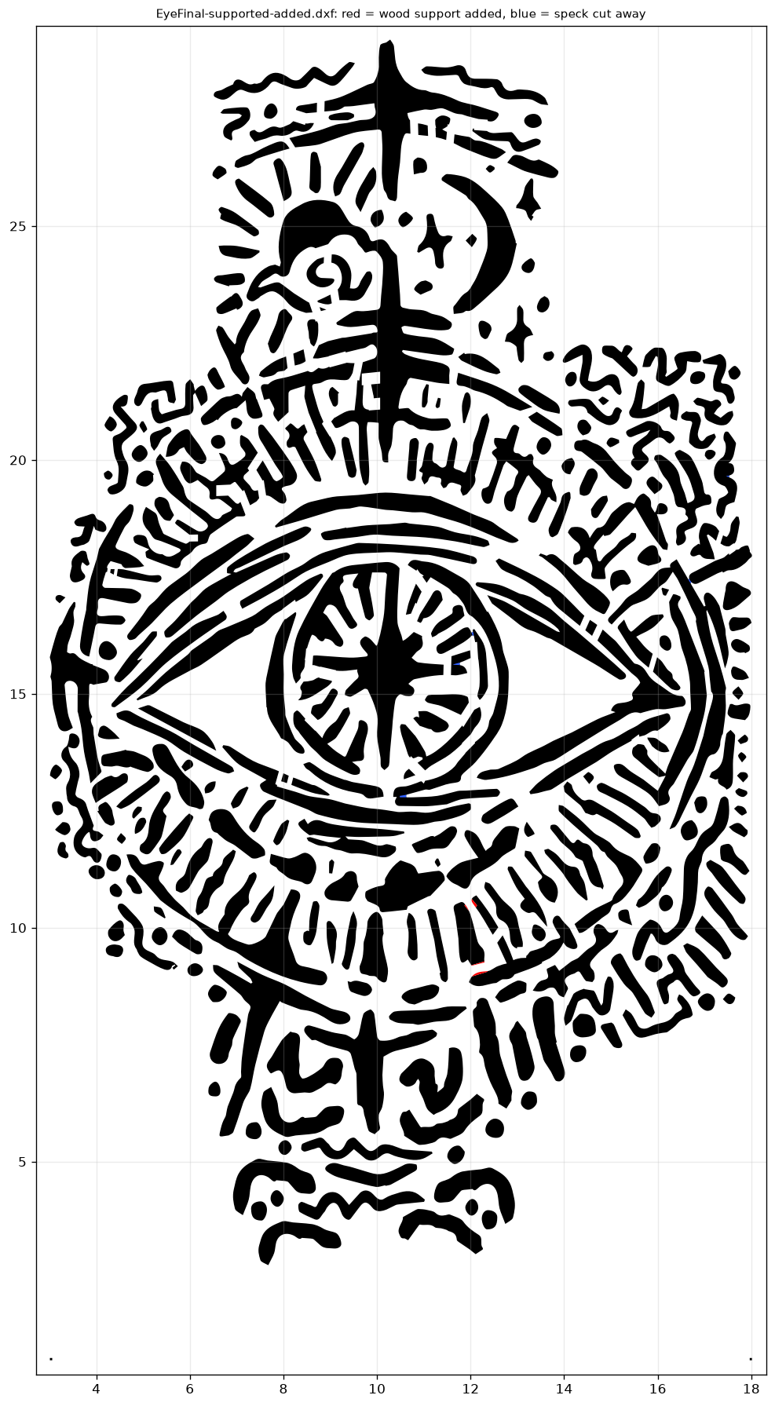
art/eye/EyeFinal-4mm-supported.png
