MrMil/led-over-rj245/art/eye/EyeFinal-4mm-supports-sheet.png

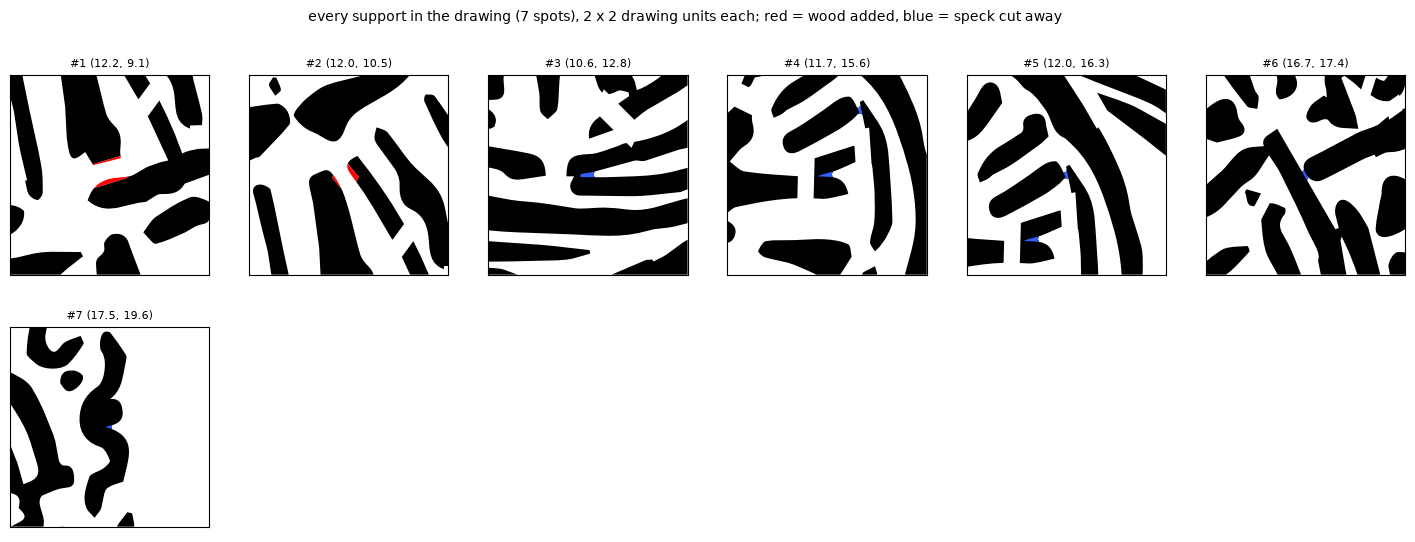
art/eye/EyeFinal-4mm-supports-sheet.png
