MrMil/led-over-rj245/art/eye/EyeFinal-check.png

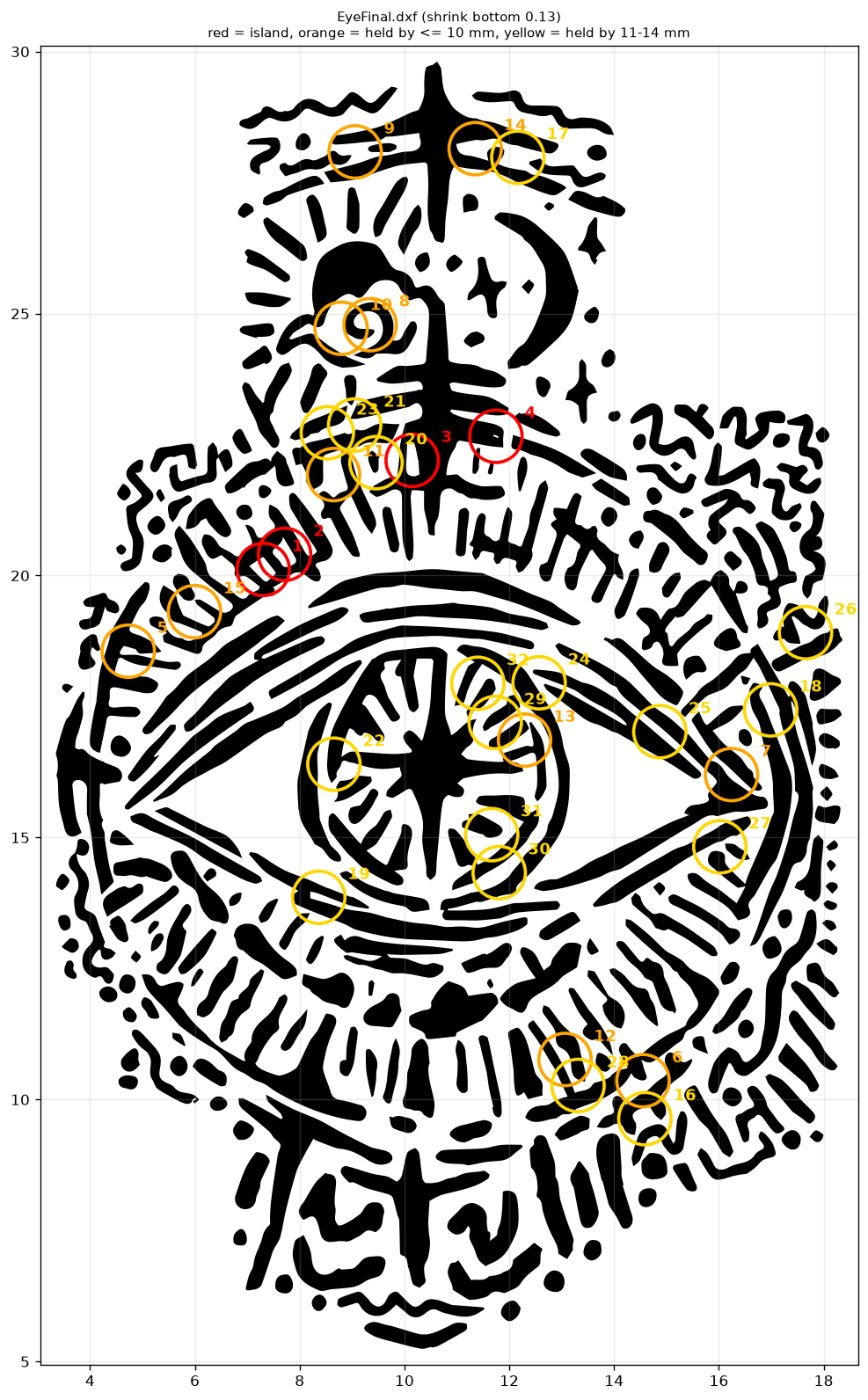
art/eye/EyeFinal-check.png
