MrMil/led-over-rj245/art/eye/EyeFinal-supports-sheet.png

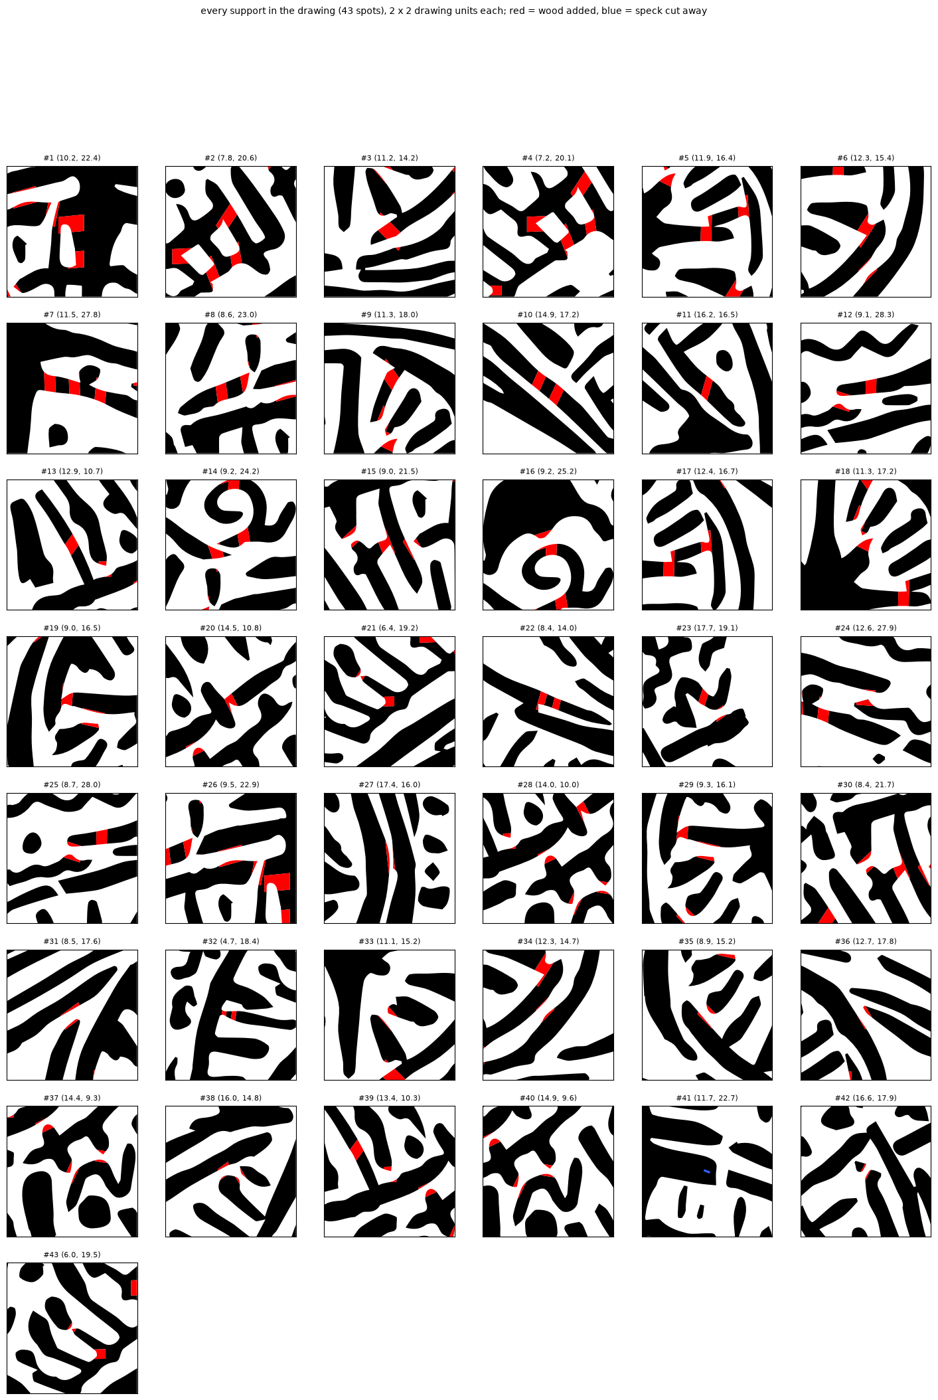
art/eye/EyeFinal-supports-sheet.png
