MrMil/led-over-rj245/art/praying/cut/plates.png

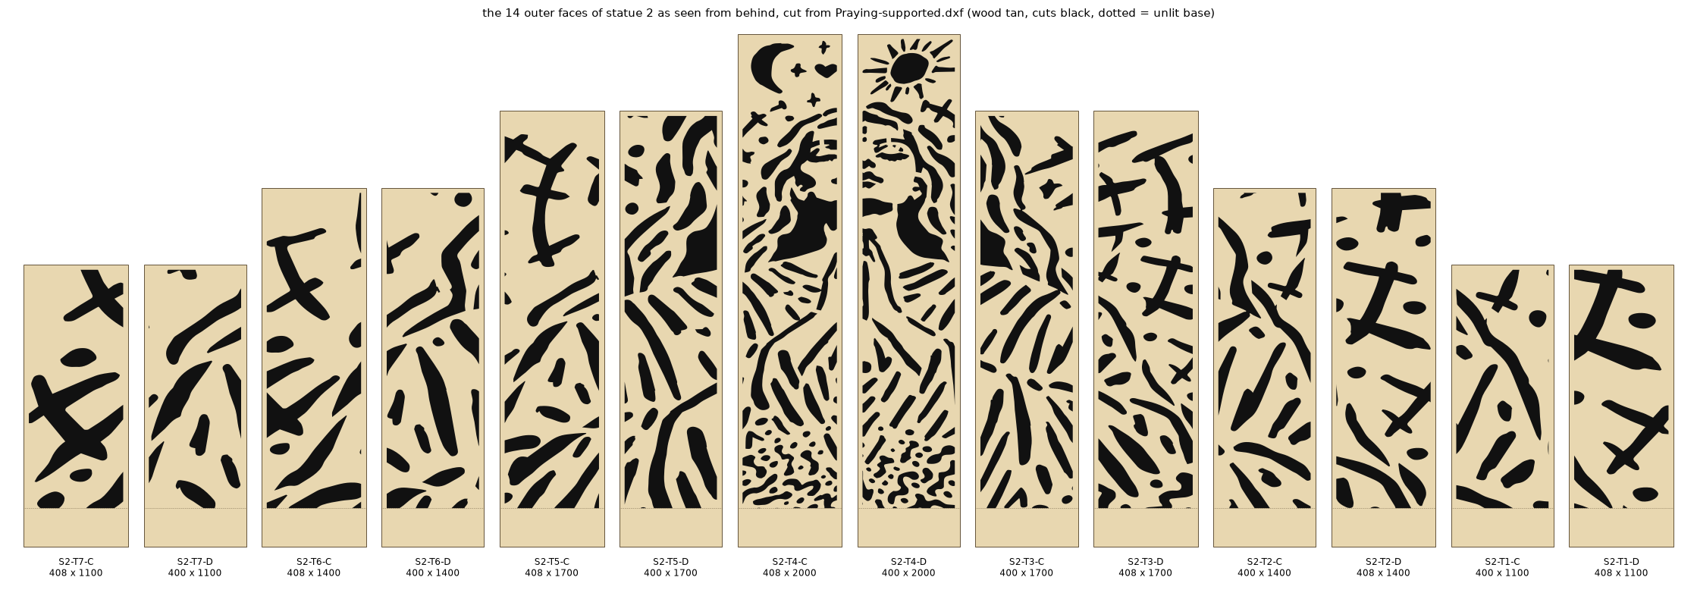
art/praying/cut/plates.png
