MrMil/led-over-rj245/art/praying/Praying-check.png

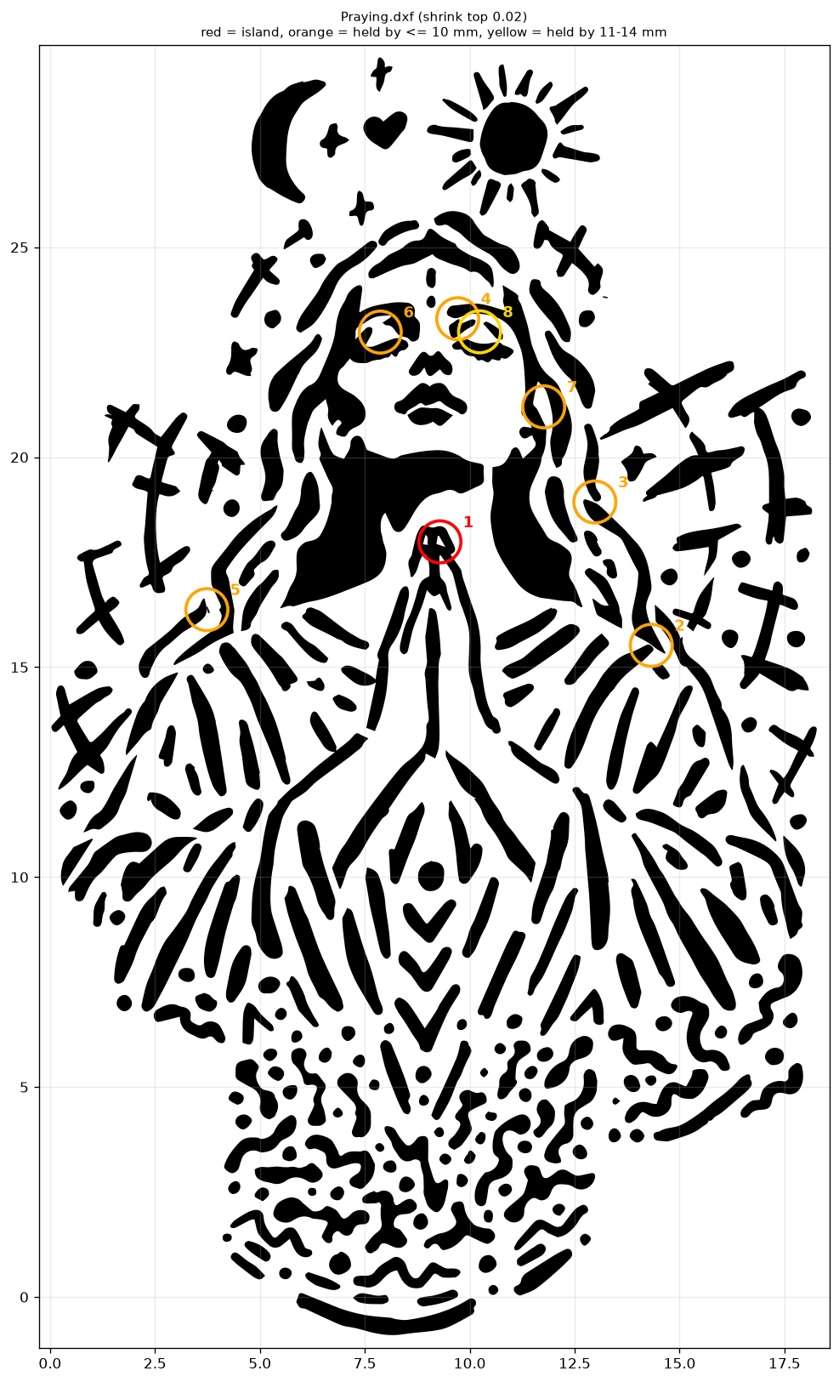
art/praying/Praying-check.png
