MrMil/led-over-rj245/art/praying/Praying-plates.png

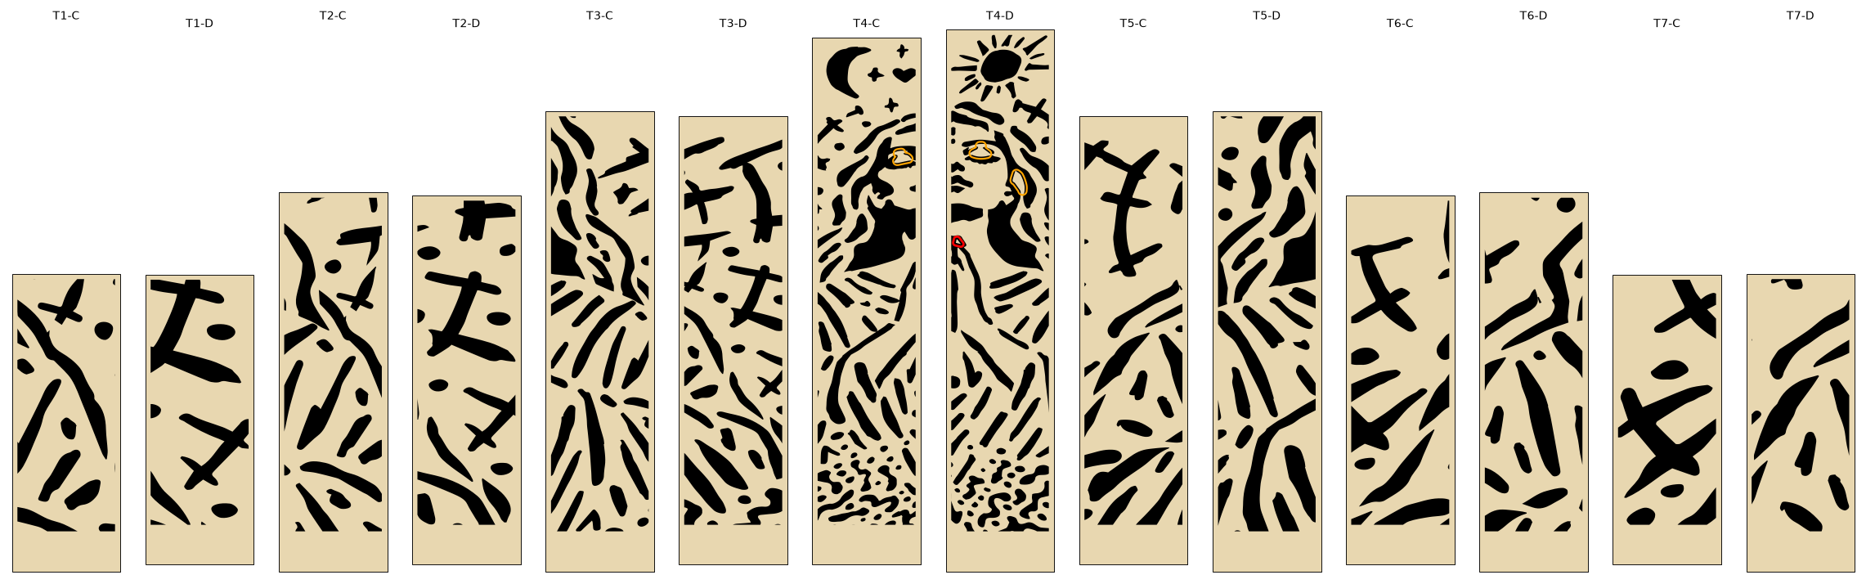
art/praying/Praying-plates.png
