MrMil/led-over-rj245/art/praying/Praying-supports-sheet.png

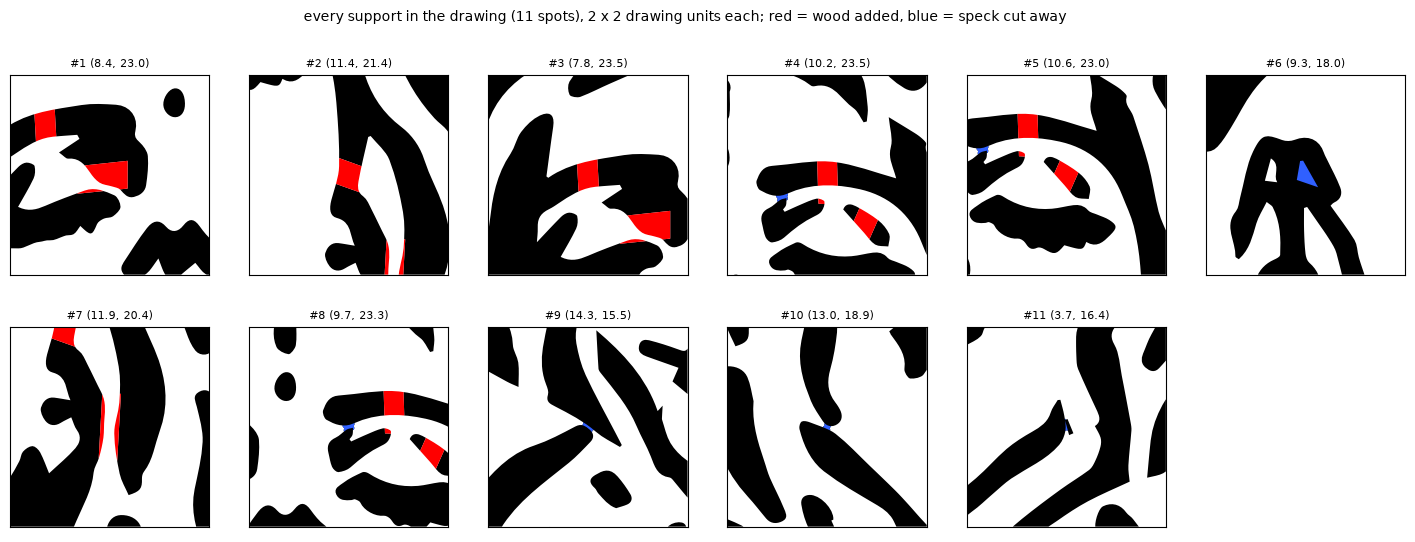
art/praying/Praying-supports-sheet.png
