MrMil/led-over-rj245/art/sea/cut/plates.png

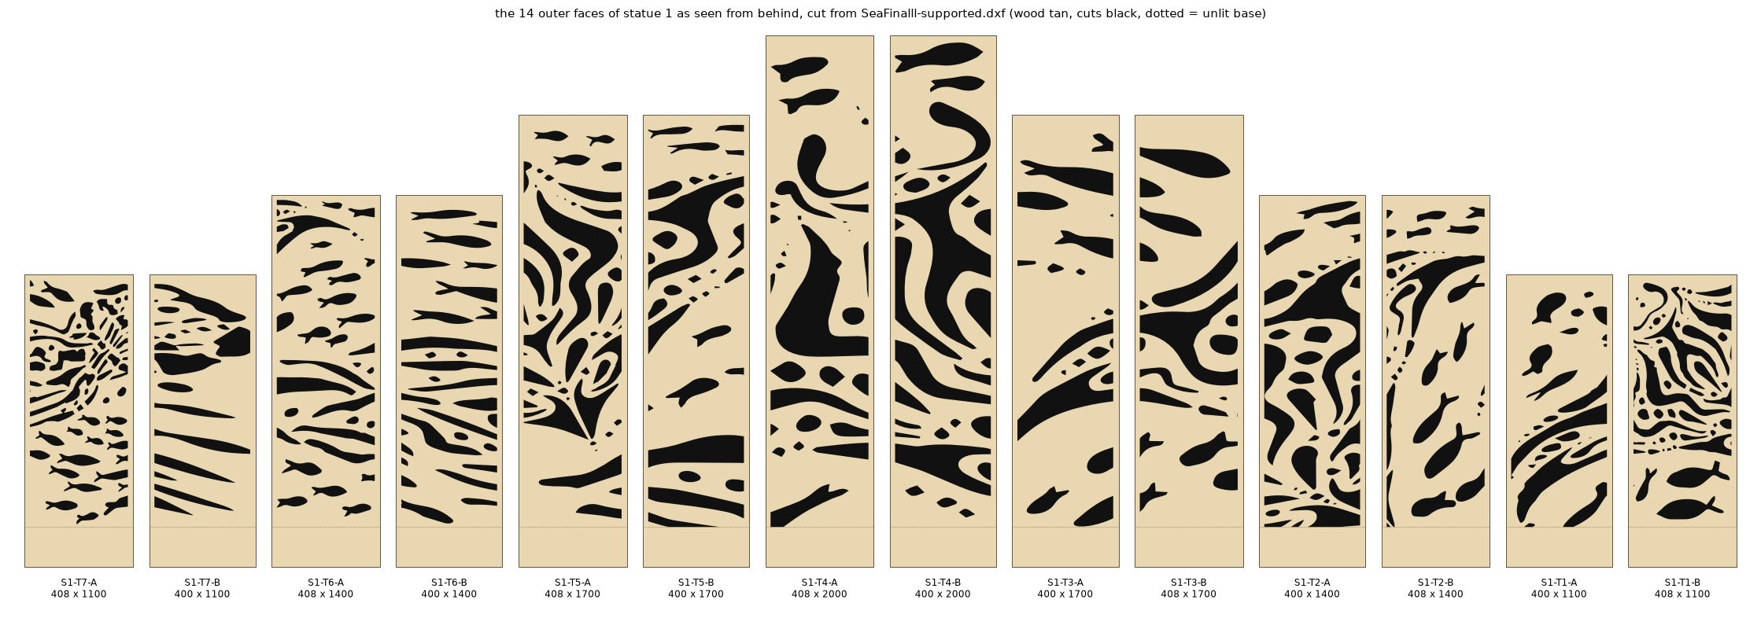
art/sea/cut/plates.png
