MrMil/led-over-rj245/art/sea/SeaFinalll-check.png

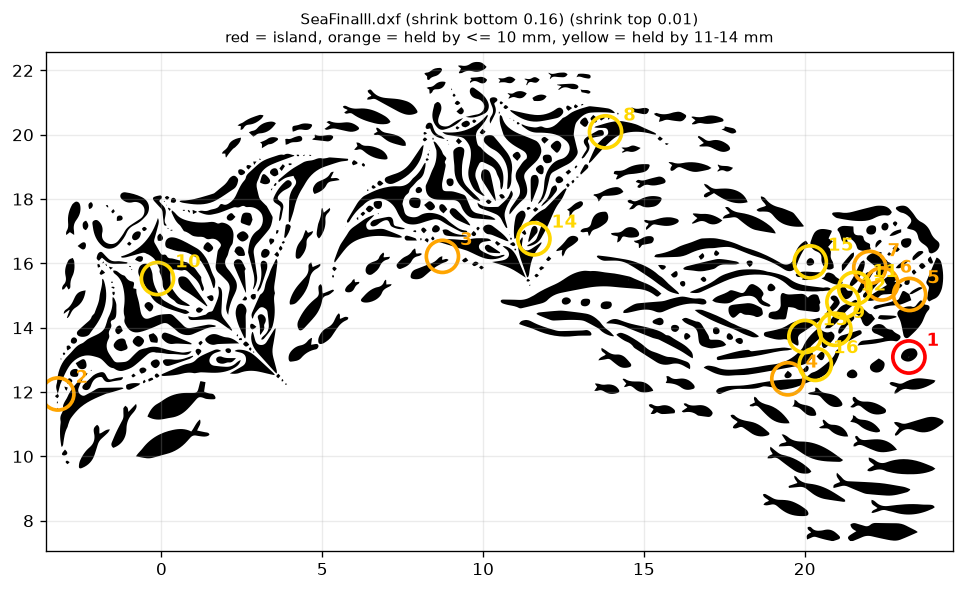
art/sea/SeaFinalll-check.png
