MrMil/led-over-rj245/art/sea/SeaFinalll-plates.png

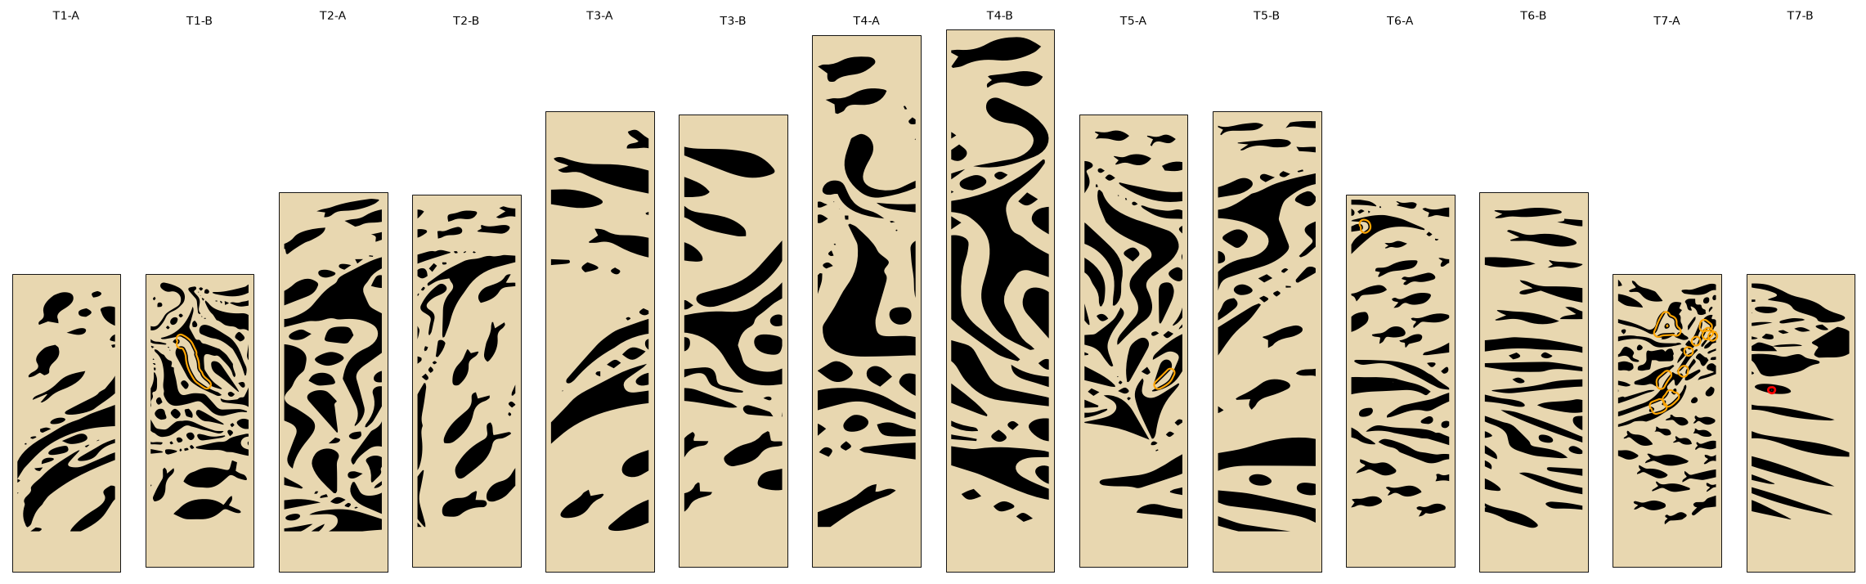
art/sea/SeaFinalll-plates.png
