MrMil/led-over-rj245/art/sea/SeaFinalll-supported-check.png

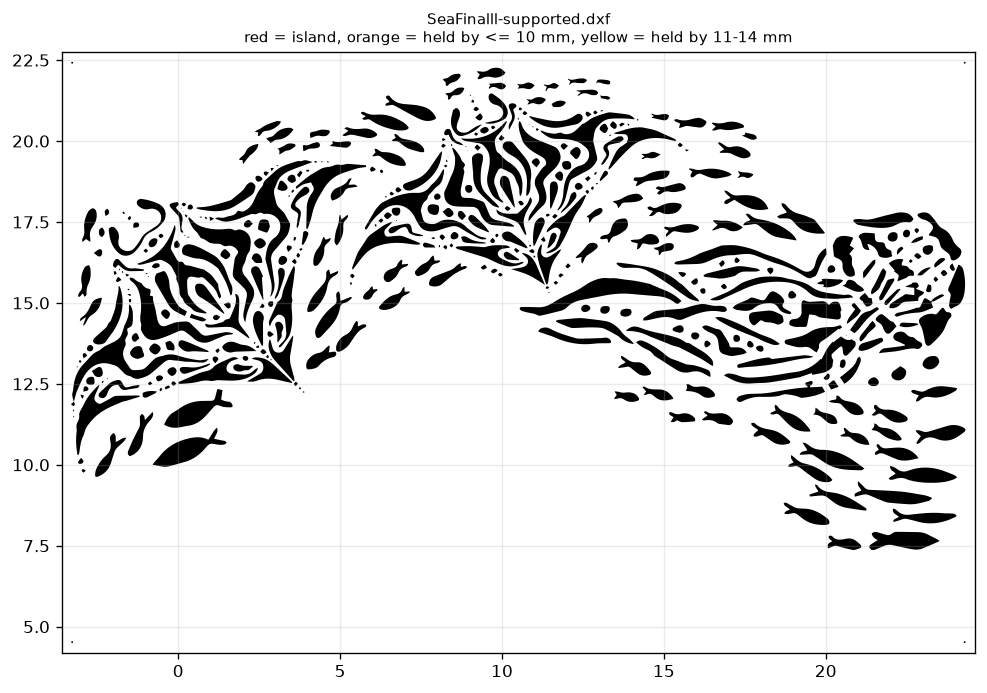
art/sea/SeaFinalll-supported-check.png
