MrMil/led-over-rj245/art/sea/SeaFinalll-supports-sheet.png

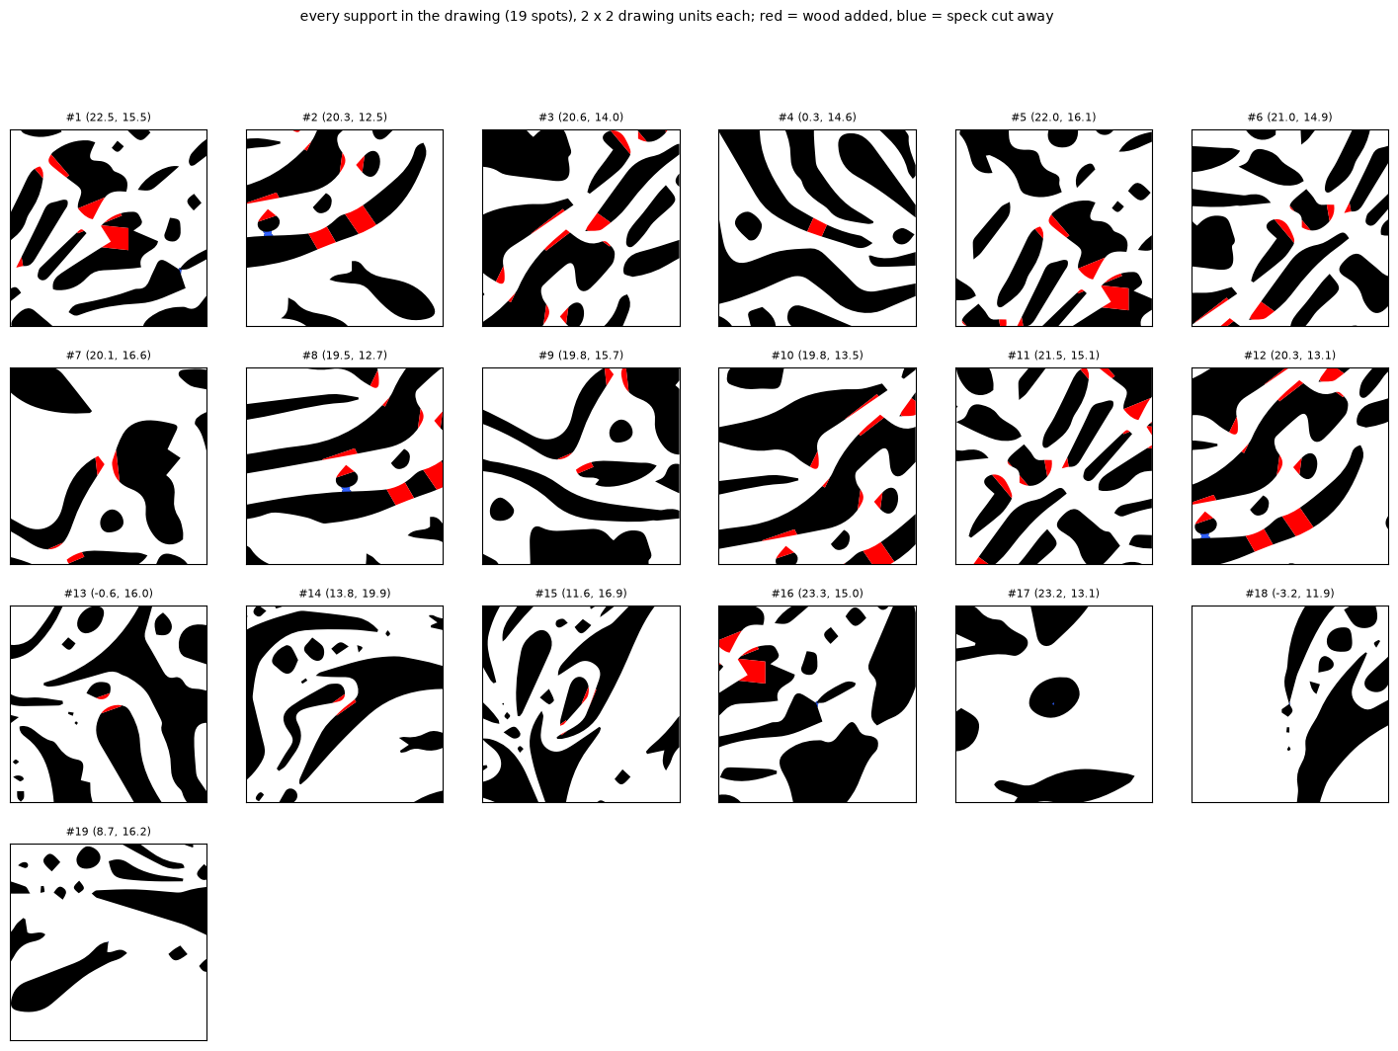
art/sea/SeaFinalll-supports-sheet.png
