MrMil/led-over-rj245/art/sheets/sheet-packing.png

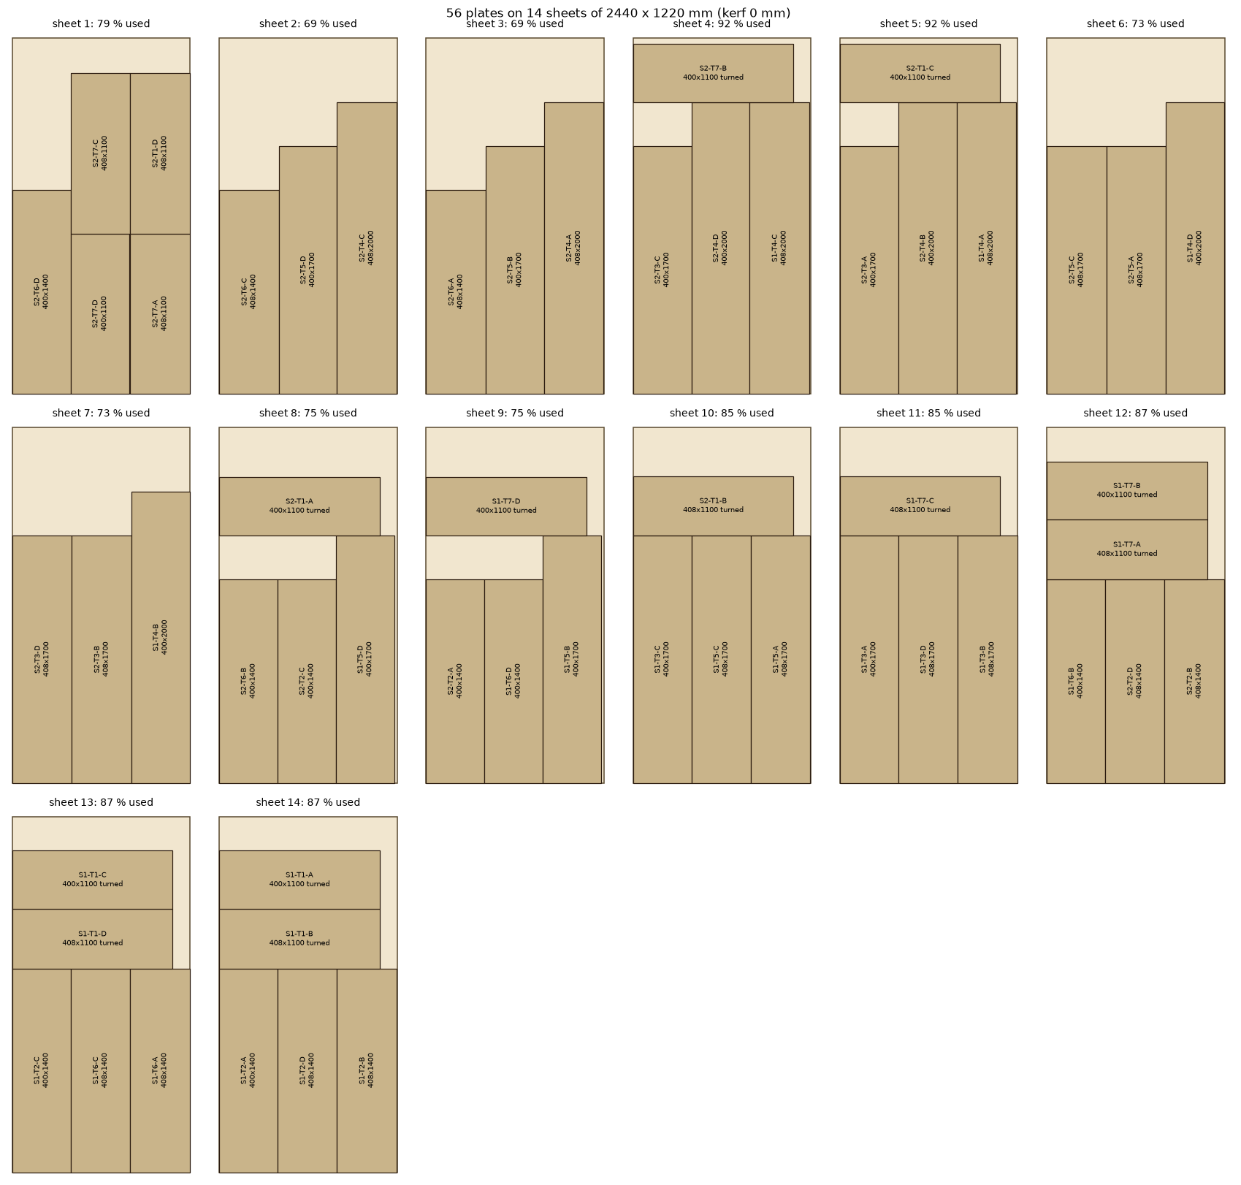
art/sheets/sheet-packing.png
