MrMil/led-over-rj245/renders/back1.png

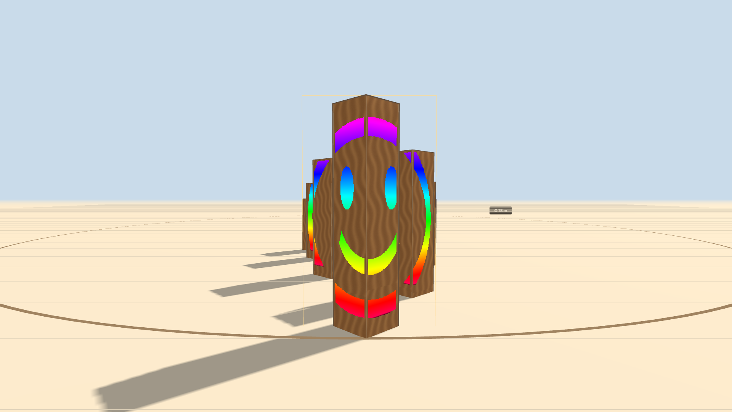
renders/back1.png
