MrMil/led-over-rj245/renders/bench1-night.png

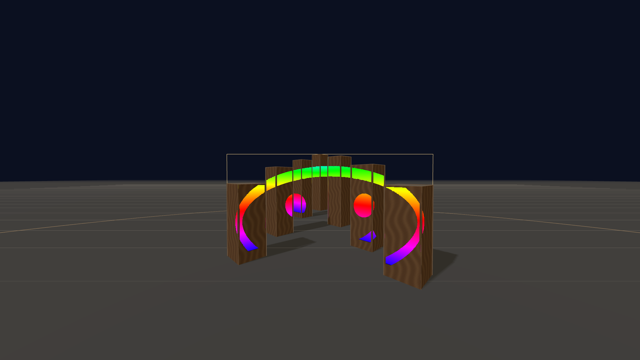
renders/bench1-night.png
