MrMil/led-over-rj245/renders/bench1.png

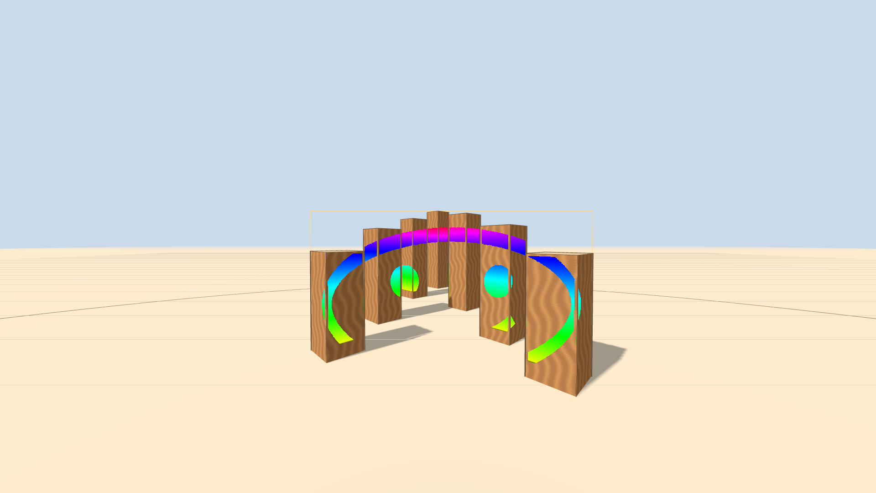
renders/bench1.png
