MrMil/led-over-rj245/renders/bench2.png

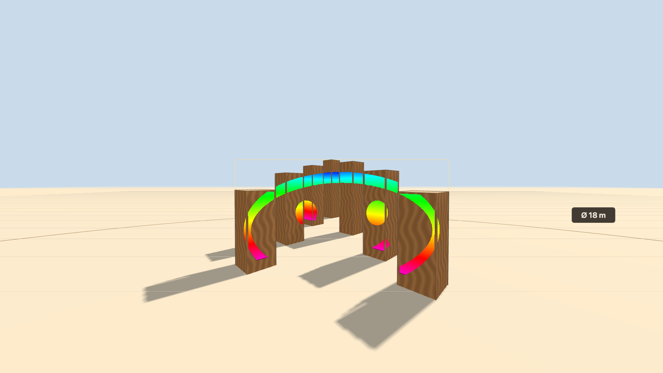
renders/bench2.png
