MrMil/led-over-rj245/renders/drone-view.png

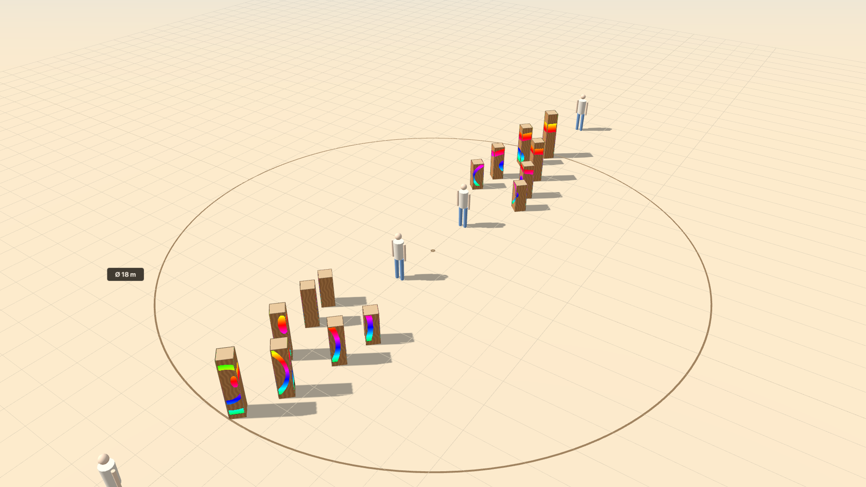
renders/drone-view.png
