MrMil/led-over-rj245/renders/top-view.png

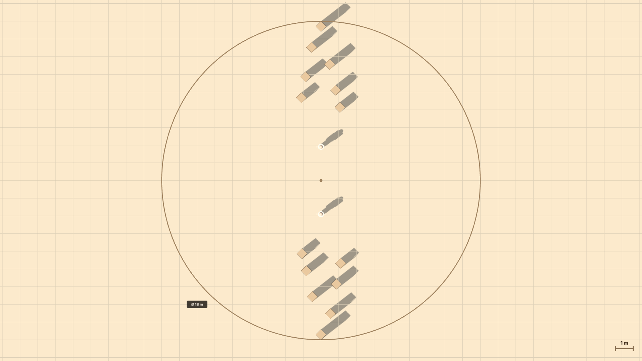
renders/top-view.png
