MrMil/led-over-rj245/guide/parts.md

# Parts, tools and spares

[← README](../README.md) · [Build](build.md) · [Inventory](inventory.md)

## Electronics

| Item | Qty | Notes |
|---|---|---|
| ESP32 dev board, 30-pin, ESP32-WROOM-32, USB-C, CH340C (HW-394), **no PSRAM** | 1 + 1 spare | All 14 GPIOs in [wiring.md](wiring.md) must be broken out. Both arrive with the installation's WLED on them; do not reflash. Laptop needs the CH340 driver |
| Female header 1 × 15, 2.54 mm (Assmann A-BL254-EG-Z15D) | 2 + 2 spare | The ESP32 plugs into a socket so it can be swapped in the field |
| 74AHCT125 (DIP-14) + socket | 2 (controller, optional) + 10 (one per power box, T4's included) + 2 spare | SN74AHCT125N + Assmann A 14-LC-TT sockets. Replacements must be **AHCT** and DIP (N suffix; NSR is surface-mount) |
| MAX485 module, 5 V (blue board) | 7 + 7 + 2 spare | 7 transmitters (controller), 7 receivers (slave box). **Chip must read MAX485** |
| Resistor 560 Ω | 14 + 20 + spares | 14: idle bias, 2 per receiver. 20: from both data inputs of every power box to GND (pins 2 and 5), the same board in all 10; in a 1 tower power box and T4 the second one just holds the idle gate at 0 V. **Not 10 kΩ:** with 10 kΩ the tower flashes at random; a board already built with 10 kΩ gets a 560 Ω across it |
| Resistor 100 Ω | 7 + 7 + 20 + spares | Controller outputs (optional), slave box outputs, power-box gate outputs (optional): 2 per power box (pins 3 and 6), the same board in all 10 |
| Perfboard, DIKAVS half-size (81 × 55) | 2 per master/slave box + 1 per power box + 1 spare | ESP32 board + transmitter board (slave box: receivers); power boxes: the tower's splitter |
| S-100-5 PSU (5 V 20 A) | 10 | 5 per statue |
| C14 inlet with fuse and switch | 10 | One per power box; 1 A fuse, + spares |
| Power strip | 10 | One at the end of every extension cord: both apexes and T2, T3, T5, T6 of each statue. ≥ 3 sockets |
| Extension cord, outdoor, buried | 11 | 2 × outlet → apex (≥ 25 m) and 1 × apex 1 → apex 2 (≥ 20 m), so the crew can feed the statues either way; per statue apex → T3 (≥ 2.5 m), T3 → T2 (≥ 3 m), apex → T5 (≥ 3.5 m), T5 → T6 (≥ 2.5 m) |
| C13 cord, one type, the shortest sold | 10 | One per box, into the strip in its own tower. The artist buys them |
| 3-core cable 3 × 2.5 (flexible PVC, "פנדל") | 9 m (25 m on hand) | 2 tip-tower cables per statue: power box in T2 → T1, power box in T6 → T7 |
| 3-core cable 3 × 1.5 | 20 m | 5 top-feed cables per statue: tower height + 30 cm |
| NYAF 2.5 mm², red + blue | ~20 m each | Inside boxes; 8 short tails per top feed |
| XT60 pairs | 54 + 6 spare | 4: the 2 tip-tower cables per statue, box end only. 50: top-feed cables, 1 at the bottom + 4 at the top, T2–T6 (25 per statue) |
| JST-SM 3-pin pairs | 68 + spares | 28 strands + 6 data inputs per statue |
| 22 AWG 2-core | per layout | Tip-tower data, taped to the 3 × 2.5: power box in T2 → T1, power box in T6 → T7 |
| Wire 0.5 mm², red + black | ~2 m each | PSU → perfboard |

## Cables and connectors

| Item | Qty | Notes |
|---|---|---|
| CAT5e (or better) patch lead, moulded plugs, 20 m | 3 + 2 spare | Between the boxes. One distinctive colour |
| RJ45 round threaded bulkhead coupler (24 mm hole) | 6 | 3 per box |
| Short patch cable | 2–3 | Cut up for the pigtails inside the boxes |
| Data cable (DATA + GND) | 12 lines | Master/slave box → power boxes, per statue: 2 each to T2 and T6, 1 each to T3 and T5 |

## Enclosures

Printed from [MrMil/electronics-enclosure](https://github.com/MrMil/electronics-enclosure)
in PETG or ASA (not PLA):

| Enclosure | Qty | For |
|---|---|---|
| `100W-masterbox` | 2 | Master/slave box per statue: the power box in T4, T4's splitter and its 4 JST-SM, + ESP32 (statue 1) or receivers (statue 2); needs data outputs to the power boxes in T2, T3, T5, T6 and a top-feed XT60 out (change pending) |
| `100W` | 8 | 4 1 tower power boxes (T3, T5 per statue): 4 JST-SM out; needs a data input and a top-feed XT60 out. 4 2 tower power boxes (T2, T6 per statue): the same plus an XT60 + tip-tower data output (change pending) |

## LED strips

WS2812B, 5 V, 60/m (bought). Supplied and mounted by the statue artist: 4 strips per tower,
one per face, 150 mm dark base. 74.8 m in all: 15 reels of 5 m cut, every face whole from one
reel ([cut list](build.md#cutting-the-led-strips)), + 1 reel spare.

## Consumables

Ferrule kit (0.25–1.5 mm²), zip ties, labels, solder, heat shrink: wide enough for a 2.5 mm²
core joined to 4 tails (tip-tower cable ends, top-feed tops), narrow for single wires.

## Tools

- Multimeter
- Screwdrivers for the screw terminals and PSU terminals
- Ferrule crimper, strippers, side cutters
- Soldering iron
- Pickaxe and shovel

## Spares bag (goes to the field)

- 2 CAT5e cables
- 1 MAX485 module
- 1 ESP32, flashed with the show
- 2 × 74AHCT125
- Zip ties, labels
