MrMil/led-over-rj245/art/dancing/cut/S2-T3-A.dxf

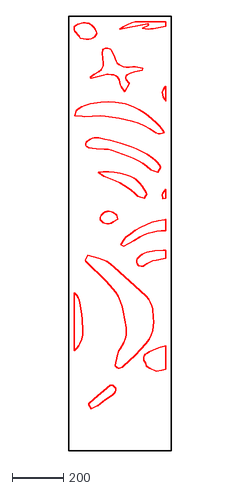
[picture p46: CAD file, 2026-10-30]
art/dancing/cut/S2-T3-A.dxf
400.0 x 1700.0
