MrMil/led-over-rj245/art/dancing/DancingFinal3.dxf

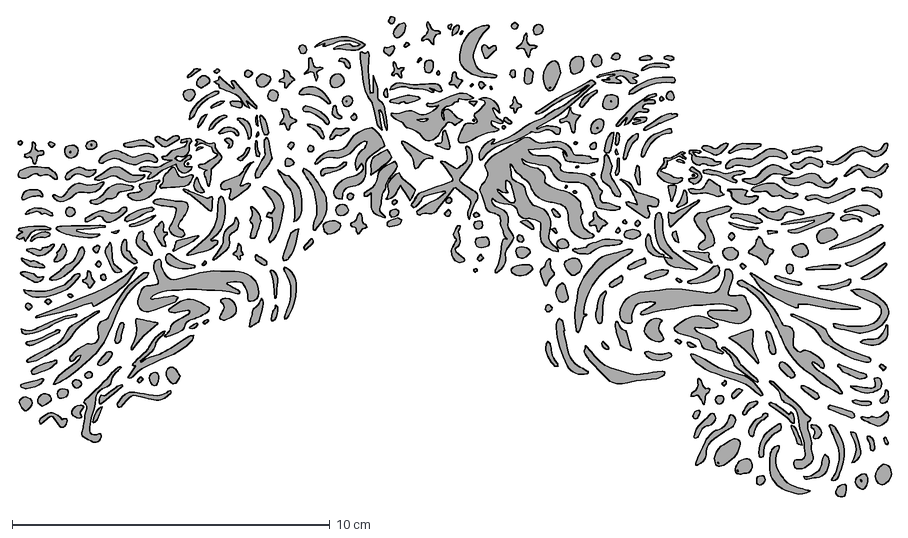
[picture p47: CAD file, 2026-10-30]
art/dancing/DancingFinal3.dxf
27.5 x 15.1 cm
