MrMil/led-over-rj245/art/dxf/S2-T2-D.dxf

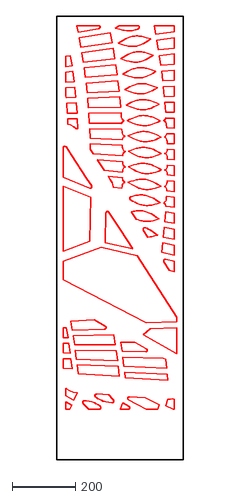
[picture p48: CAD file, 2026-10-22]
art/dxf/S2-T2-D.dxf
400.0 x 1400.0
