MrMil/led-over-rj245/art/eye/cut/S1-T7-C.dxf

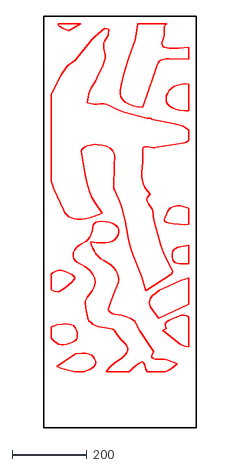
[picture p49: CAD file, 2026-10-28]
art/eye/cut/S1-T7-C.dxf
408.0 x 1100.0
