MrMil/led-over-rj245/art/eye/EyeFinal-4mm-supported.dxf

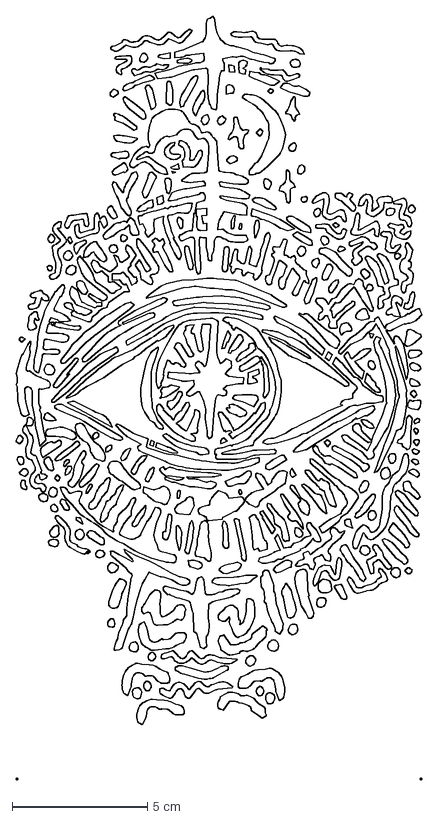
[picture p50: CAD file, 2026-10-28]
art/eye/EyeFinal-4mm-supported.dxf
15.0 x 28.2 cm
