MrMil/led-over-rj245/art/praying/cut/S2-T4-D.dxf

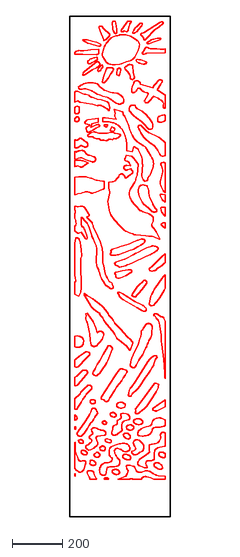
[picture p51: CAD file, 2026-10-28]
art/praying/cut/S2-T4-D.dxf
400.0 x 2000.0
