MrMil/led-over-rj245/art/praying/Praying.dxf

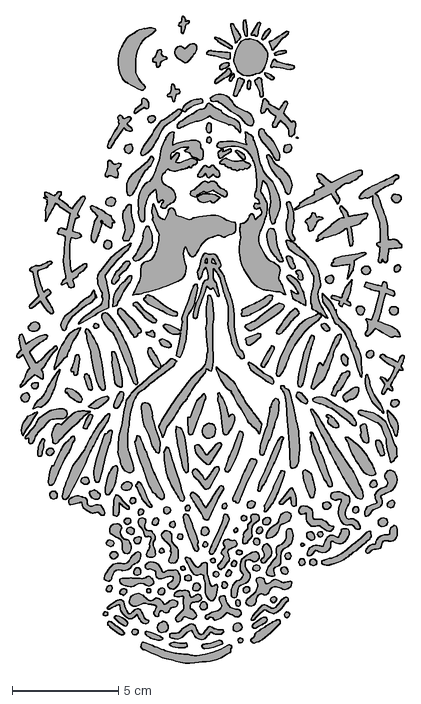
[picture p52: CAD file, 2026-10-28]
art/praying/Praying.dxf
18.3 x 30.5 cm
