MrMil/led-over-rj245/art/sea/cut/S1-T5-B.dxf

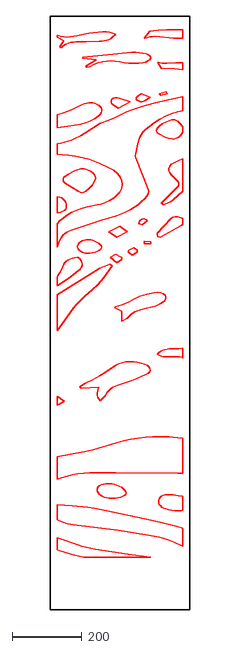
[picture p53: CAD file, 2026-10-28]
art/sea/cut/S1-T5-B.dxf
400.0 x 1700.0
