MrMil/led-over-rj245/art/sea/SeaFinalll-supported.dxf

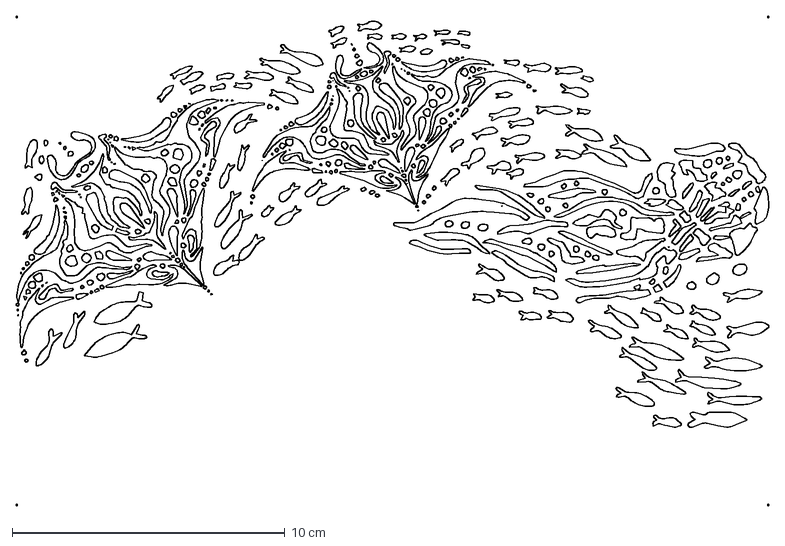
[picture p54: CAD file, 2026-10-28]
art/sea/SeaFinalll-supported.dxf
27.6 x 17.9 cm
