MrMil/led-over-rj245/art/dancing/cut/S2-T1-A.dxf

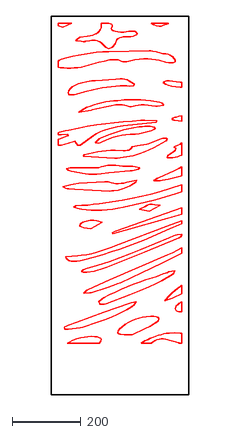
[picture p55: CAD file, 2026-10-30]
art/dancing/cut/S2-T1-A.dxf
400.0 x 1100.0
