MrMil/led-over-rj245/art/dancing/DancingFinal3-supported.dxf

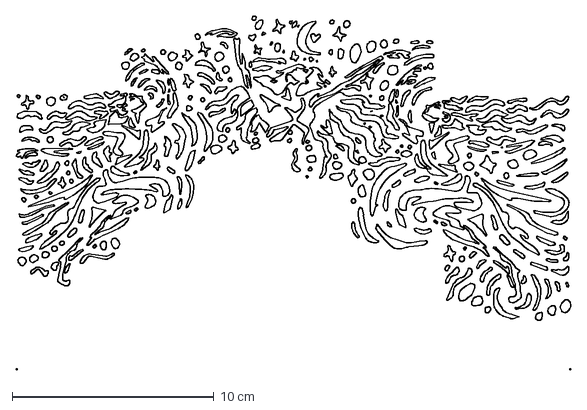
[picture p56: CAD file, 2026-10-30]
art/dancing/DancingFinal3-supported.dxf
27.5 x 17.6 cm
