MrMil/led-over-rj245/art/dxf/S2-T4-A.dxf

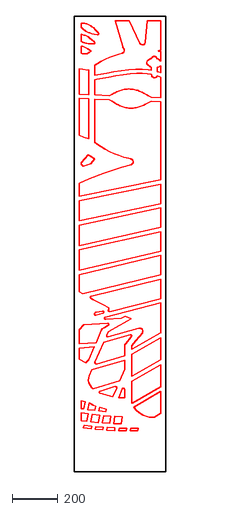
[picture p57: CAD file, 2026-10-22]
art/dxf/S2-T4-A.dxf
400.0 x 2000.0
