MrMil/led-over-rj245/art/eye/cut/S1-T7-D.dxf

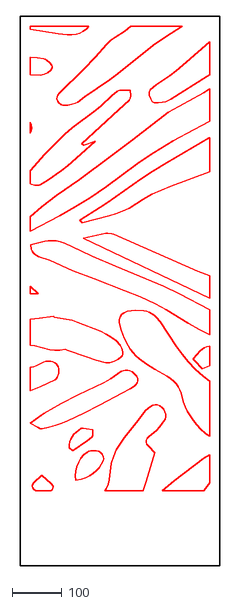
[picture p58: CAD file, 2026-10-28]
art/eye/cut/S1-T7-D.dxf
400.0 x 1100.0
