MrMil/led-over-rj245/art/eye/EyeFinal-supported-added.dxf

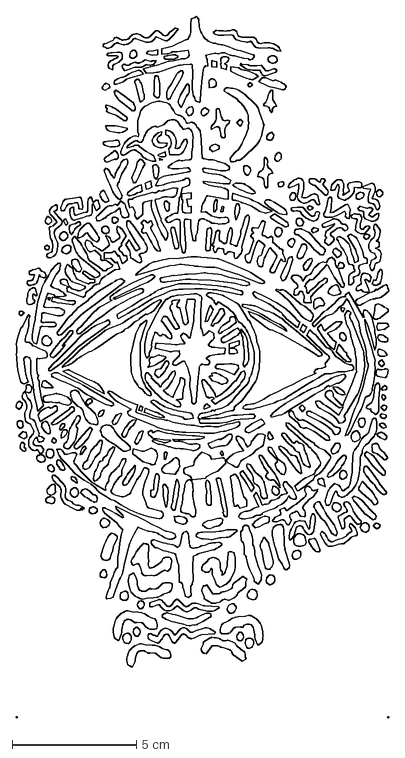
[picture p59: CAD file, 2026-10-28]
art/eye/EyeFinal-supported-added.dxf
15.0 x 28.2 cm
