MrMil/led-over-rj245/art/praying/cut/S2-T7-C.dxf

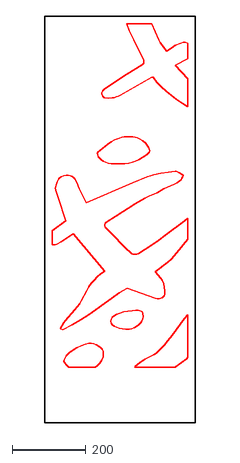
[picture p60: CAD file, 2026-10-28]
art/praying/cut/S2-T7-C.dxf
408.0 x 1100.0
