MrMil/led-over-rj245/art/praying/Praying-supported.dxf

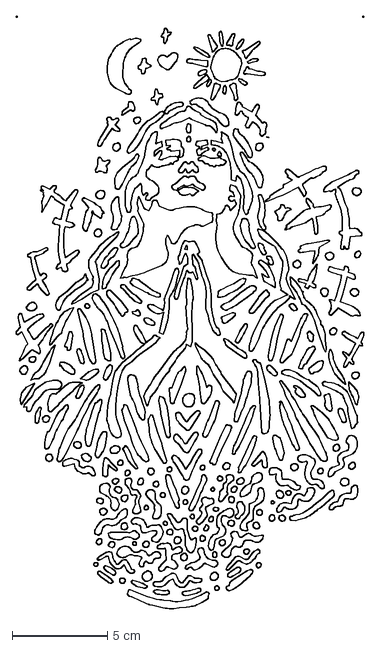
[picture p61: CAD file, 2026-10-28]
art/praying/Praying-supported.dxf
18.2 x 31.0 cm
