MrMil/led-over-rj245/art/sea/cut/S1-T5-A.dxf

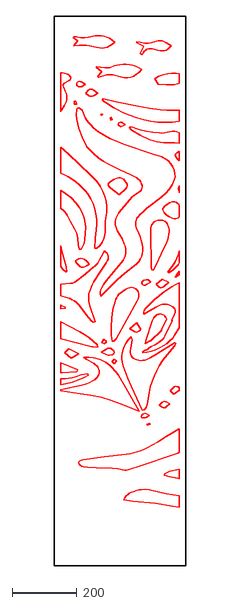
[picture p62: CAD file, 2026-10-28]
art/sea/cut/S1-T5-A.dxf
408.0 x 1700.0
