MrMil/led-over-rj245/art/sea/SeaFinalll.dxf

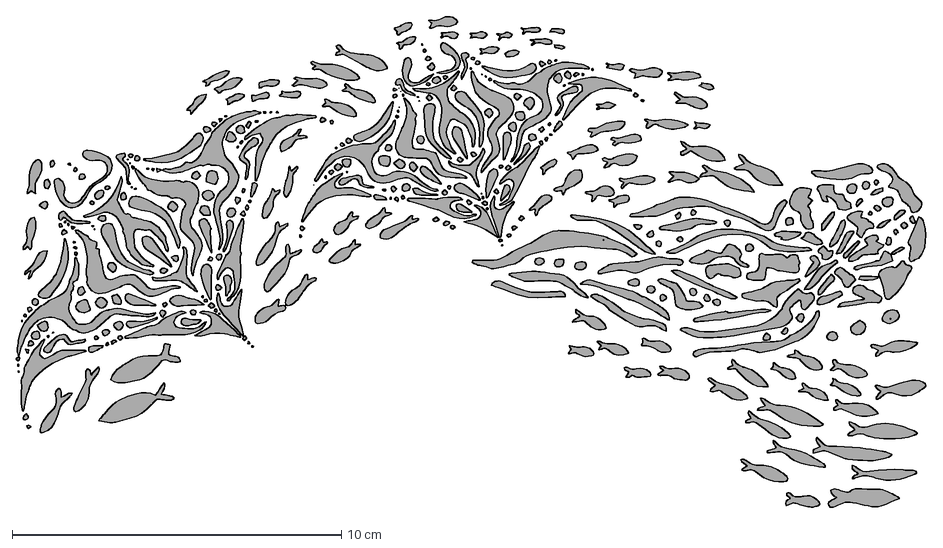
[picture p63: CAD file, 2026-10-28]
art/sea/SeaFinalll.dxf
27.6 x 14.9 cm
