MrMil/led-over-rj245/art/dancing/cut/S2-T1-B.dxf

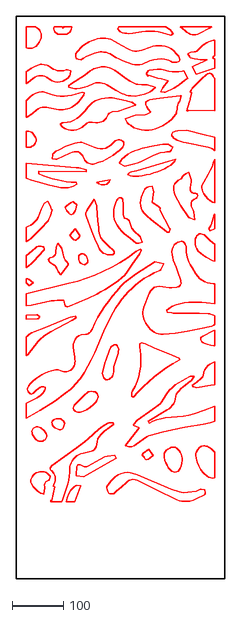
[picture p64: CAD file, 2026-10-30]
art/dancing/cut/S2-T1-B.dxf
408.0 x 1100.0
