MrMil/led-over-rj245/art/eye/cut/S1-T6-C.dxf

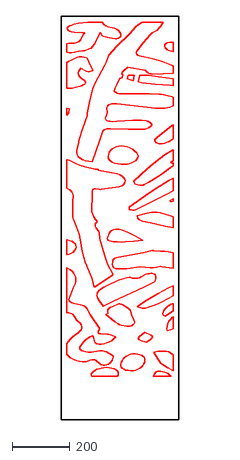
[picture p66: CAD file, 2026-10-28]
art/eye/cut/S1-T6-C.dxf
408.0 x 1400.0
