MrMil/led-over-rj245/art/eye/EyeFinal-supported.dxf

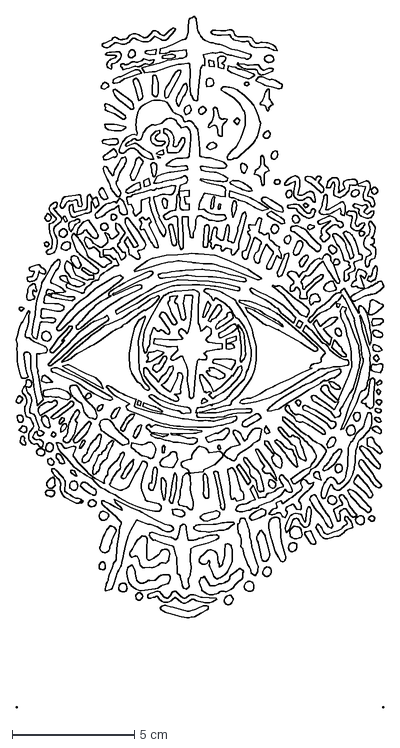
[picture p67: CAD file, 2026-10-28]
art/eye/EyeFinal-supported.dxf
15.0 x 28.2 cm
