MrMil/led-over-rj245/art/praying/cut/S2-T5-D.dxf

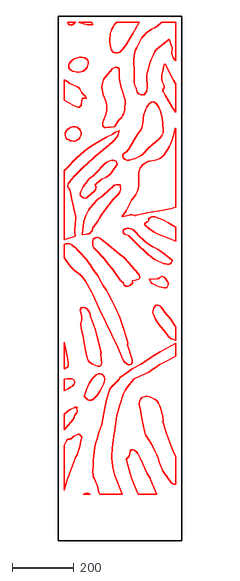
[picture p68: CAD file, 2026-10-28]
art/praying/cut/S2-T5-D.dxf
400.0 x 1700.0
