MrMil/led-over-rj245/art/sea/cut/S1-T6-B.dxf

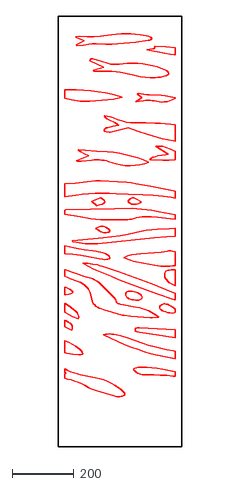
[picture p69: CAD file, 2026-10-28]
art/sea/cut/S1-T6-B.dxf
400.0 x 1400.0
