MrMil/led-over-rj245/art/dancing/cut/S2-T4-B.dxf

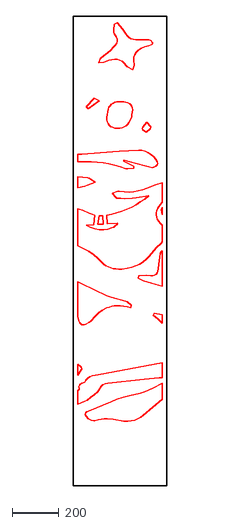
[picture p70: CAD file, 2026-10-30]
art/dancing/cut/S2-T4-B.dxf
400.0 x 2000.0
