MrMil/led-over-rj245/art/dxf/S2-T5-A.dxf

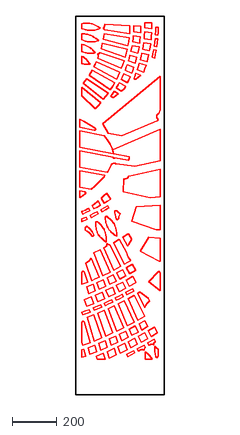
[picture p71: CAD file, 2026-10-22]
art/dxf/S2-T5-A.dxf
400.0 x 1700.0
