MrMil/led-over-rj245/art/eye/cut/S1-T1-D.dxf

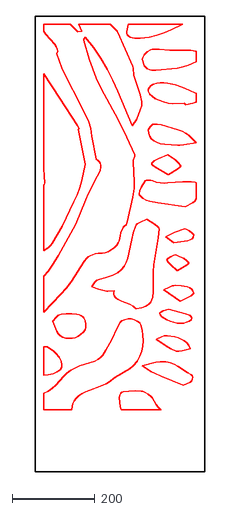
[picture p72: CAD file, 2026-10-28]
art/eye/cut/S1-T1-D.dxf
408.0 x 1100.0
