MrMil/led-over-rj245/art/eye/EyeFinal.dxf

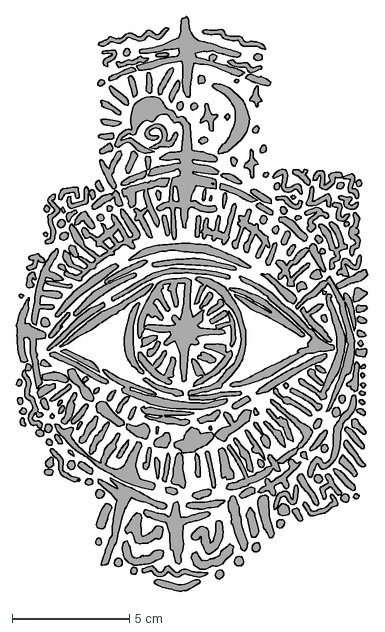
[picture p73: CAD file, 2026-10-28]
art/eye/EyeFinal.dxf
15.1 x 24.6 cm
