MrMil/led-over-rj245/art/praying/cut/S2-T4-C.dxf

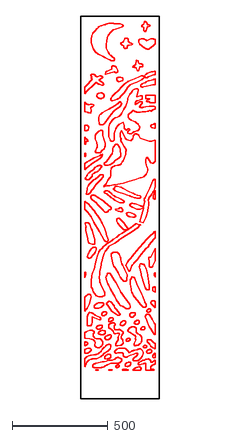
[picture p74: CAD file, 2026-10-28]
art/praying/cut/S2-T4-C.dxf
408.0 x 2000.0
