MrMil/led-over-rj245/art/sea/cut/S1-T3-A.dxf

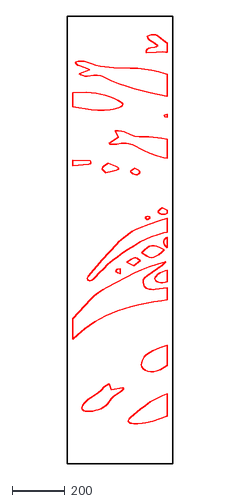
[picture p75: CAD file, 2026-10-28]
art/sea/cut/S1-T3-A.dxf
400.0 x 1700.0
