MrMil/led-over-rj245/art/dancing/cut/S2-T2-A.dxf

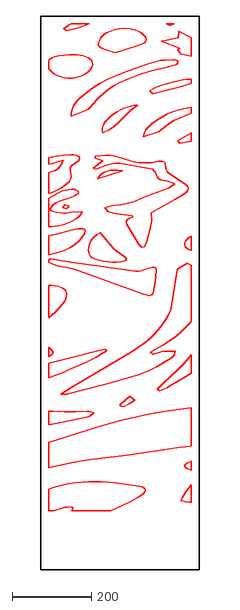
[picture p76: CAD file, 2026-10-30]
art/dancing/cut/S2-T2-A.dxf
400.0 x 1400.0
