MrMil/led-over-rj245/art/eye/cut/S1-T2-D.dxf

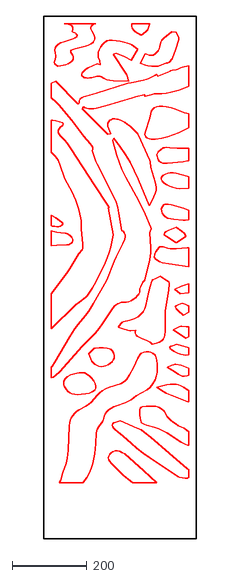
[picture p78: CAD file, 2026-10-28]
art/eye/cut/S1-T2-D.dxf
408.0 x 1400.0
