MrMil/led-over-rj245/art/praying/cut/S2-T1-D.dxf

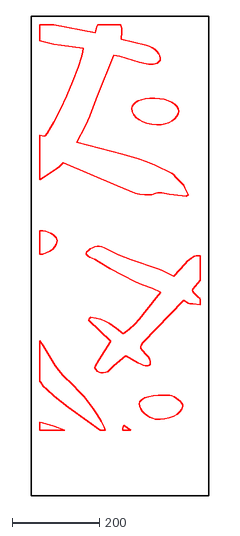
[picture p79: CAD file, 2026-10-28]
art/praying/cut/S2-T1-D.dxf
408.0 x 1100.0
