MrMil/led-over-rj245/art/sea/cut/S1-T3-B.dxf

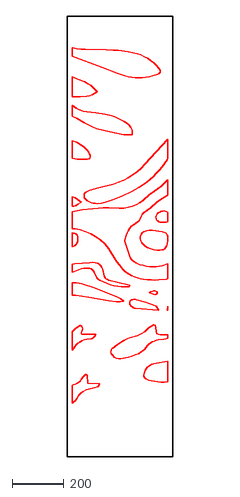
[picture p80: CAD file, 2026-10-28]
art/sea/cut/S1-T3-B.dxf
408.0 x 1700.0
