MrMil/led-over-rj245/art/dancing/cut/S2-T4-A.dxf

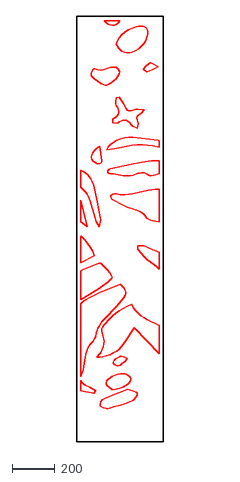
[picture p81: CAD file, 2026-10-30]
art/dancing/cut/S2-T4-A.dxf
408.0 x 2000.0
