MrMil/led-over-rj245/art/eye/cut/S1-T5-C.dxf

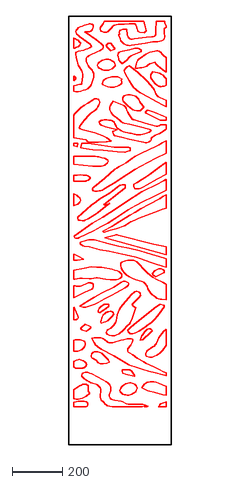
[picture p83: CAD file, 2026-10-28]
art/eye/cut/S1-T5-C.dxf
408.0 x 1700.0
