MrMil/led-over-rj245/art/praying/cut/S2-T3-C.dxf

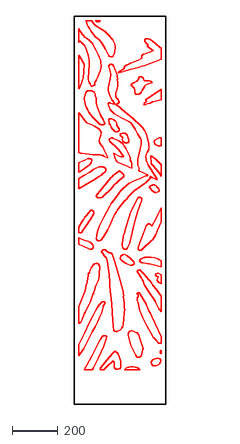
[picture p84: CAD file, 2026-10-28]
art/praying/cut/S2-T3-C.dxf
400.0 x 1700.0
