MrMil/led-over-rj245/art/sea/cut/S1-T7-A.dxf

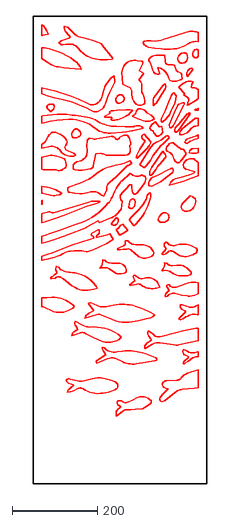
[picture p85: CAD file, 2026-10-28]
art/sea/cut/S1-T7-A.dxf
408.0 x 1100.0
