MrMil/led-over-rj245/art/dancing/cut/S2-T6-B.dxf

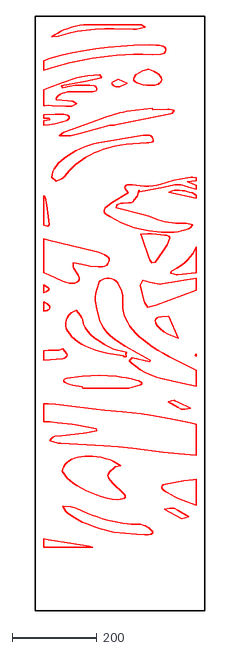
[picture p86: CAD file, 2026-10-30]
art/dancing/cut/S2-T6-B.dxf
400.0 x 1400.0
