MrMil/led-over-rj245/art/dxf/S2-T2-A.dxf

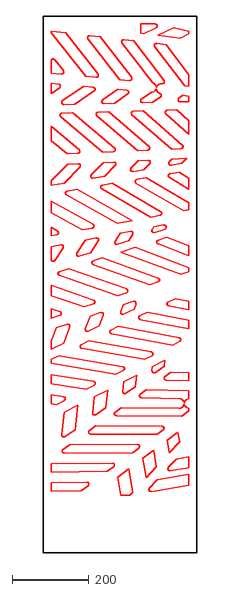
[picture p87: CAD file, 2026-10-22]
art/dxf/S2-T2-A.dxf
400.0 x 1400.0
