MrMil/led-over-rj245/art/eye/cut/S1-T3-C.dxf

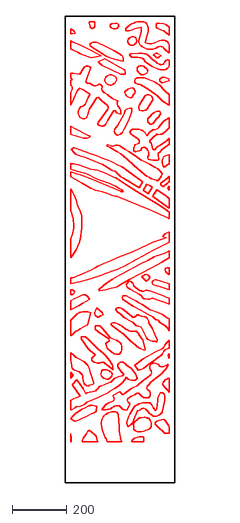
[picture p88: CAD file, 2026-10-28]
art/eye/cut/S1-T3-C.dxf
400.0 x 1700.0
