MrMil/led-over-rj245/art/praying/cut/S2-T6-C.dxf

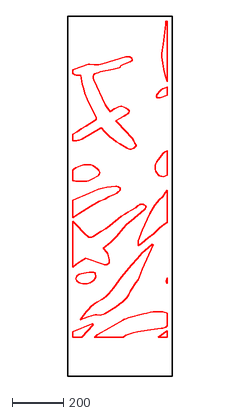
[picture p89: CAD file, 2026-10-28]
art/praying/cut/S2-T6-C.dxf
408.0 x 1400.0
