MrMil/led-over-rj245/art/sea/cut/S1-T1-B.dxf

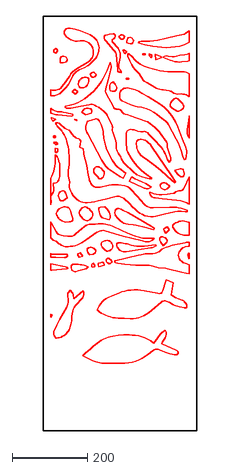
[picture p90: CAD file, 2026-10-28]
art/sea/cut/S1-T1-B.dxf
408.0 x 1100.0
