MrMil/led-over-rj245/art/dancing/cut/S2-T6-A.dxf

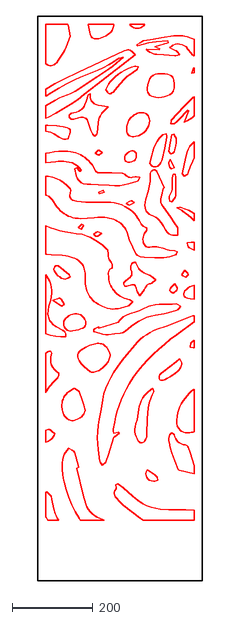
[picture p91: CAD file, 2026-10-30]
art/dancing/cut/S2-T6-A.dxf
408.0 x 1400.0
