MrMil/led-over-rj245/art/eye/cut/S1-T4-D.dxf

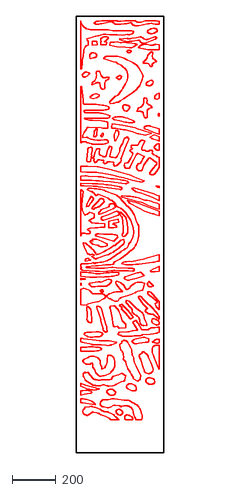
[picture p93: CAD file, 2026-10-28]
art/eye/cut/S1-T4-D.dxf
400.0 x 2000.0
