MrMil/led-over-rj245/art/praying/cut/S2-T7-D.dxf

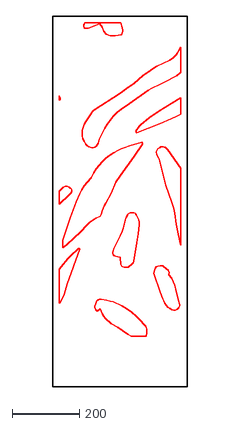
[picture p94: CAD file, 2026-10-28]
art/praying/cut/S2-T7-D.dxf
400.0 x 1100.0
