MrMil/led-over-rj245/art/sea/cut/S1-T6-A.dxf

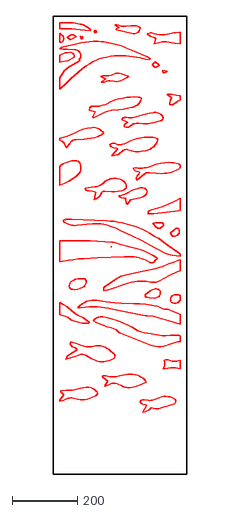
[picture p95: CAD file, 2026-10-28]
art/sea/cut/S1-T6-A.dxf
408.0 x 1400.0
