MrMil/led-over-rj245/art/dancing/cut/S2-T5-B.dxf

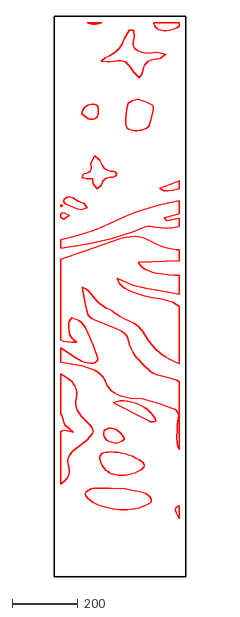
[picture p96: CAD file, 2026-10-30]
art/dancing/cut/S2-T5-B.dxf
400.0 x 1700.0
