MrMil/led-over-rj245/art/eye/cut/S1-T4-C.dxf

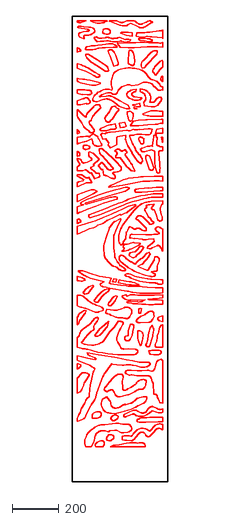
[picture p98: CAD file, 2026-10-28]
art/eye/cut/S1-T4-C.dxf
408.0 x 2000.0
