MrMil/led-over-rj245/art/praying/cut/S2-T6-D.dxf

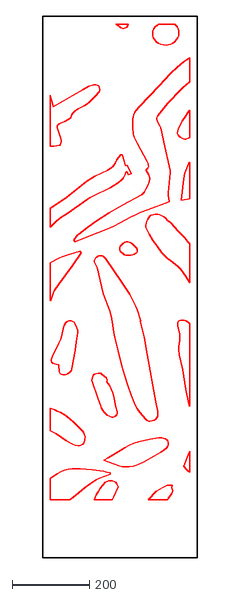
[picture p99: CAD file, 2026-10-28]
art/praying/cut/S2-T6-D.dxf
400.0 x 1400.0
