MrMil/led-over-rj245/art/sea/cut/S1-T2-B.dxf

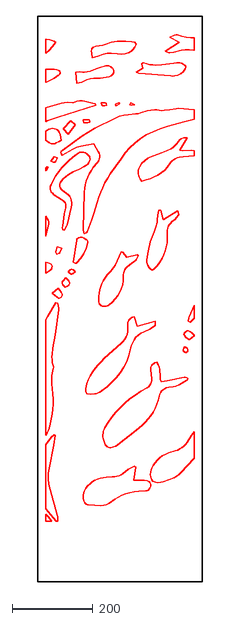
[picture p100: CAD file, 2026-10-28]
art/sea/cut/S1-T2-B.dxf
408.0 x 1400.0
