MrMil/led-over-rj245/art/dancing/cut/S2-T3-B.dxf

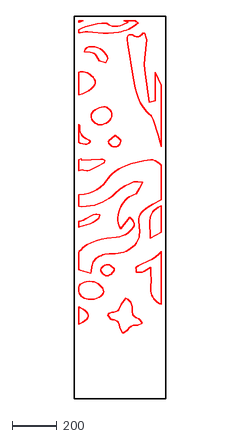
[picture p101: CAD file, 2026-10-30]
art/dancing/cut/S2-T3-B.dxf
408.0 x 1700.0
