MrMil/led-over-rj245/art/eye/cut/S1-T3-D.dxf

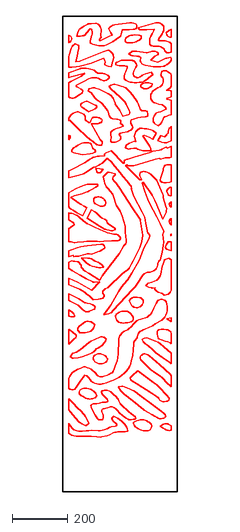
[picture p103: CAD file, 2026-10-28]
art/eye/cut/S1-T3-D.dxf
408.0 x 1700.0
