MrMil/led-over-rj245/art/praying/cut/S2-T5-C.dxf

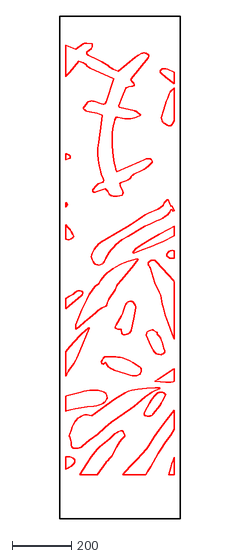
[picture p104: CAD file, 2026-10-28]
art/praying/cut/S2-T5-C.dxf
408.0 x 1700.0
