MrMil/led-over-rj245/art/sea/cut/S1-T1-A.dxf

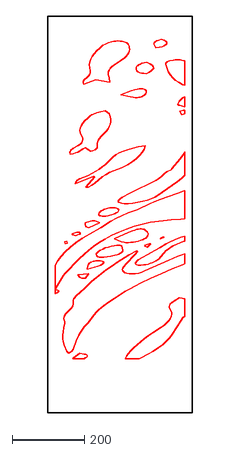
[picture p105: CAD file, 2026-10-28]
art/sea/cut/S1-T1-A.dxf
400.0 x 1100.0
