MrMil/led-over-rj245/art/dancing/cut/S2-T7-A.dxf

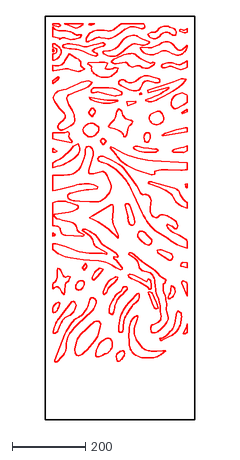
[picture p106: CAD file, 2026-10-30]
art/dancing/cut/S2-T7-A.dxf
408.0 x 1100.0
