MrMil/led-over-rj245/art/eye/cut/S1-T2-C.dxf

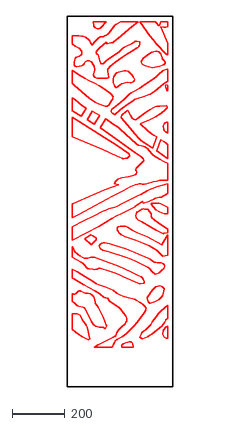
[picture p108: CAD file, 2026-10-28]
art/eye/cut/S1-T2-C.dxf
400.0 x 1400.0
