MrMil/led-over-rj245/art/praying/cut/S2-T1-C.dxf

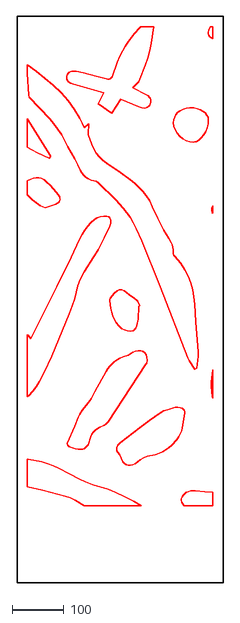
[picture p109: CAD file, 2026-10-28]
art/praying/cut/S2-T1-C.dxf
400.0 x 1100.0
