MrMil/led-over-rj245/art/sea/cut/S1-T7-B.dxf

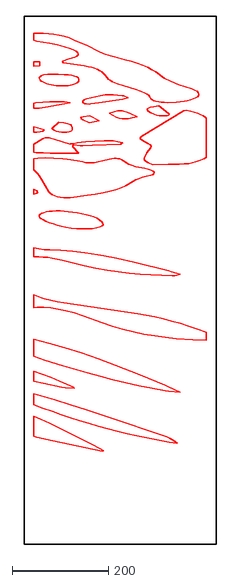
[picture p110: CAD file, 2026-10-28]
art/sea/cut/S1-T7-B.dxf
400.0 x 1100.0
