MrMil/led-over-rj245/art/dancing/cut/S2-T7-B.dxf

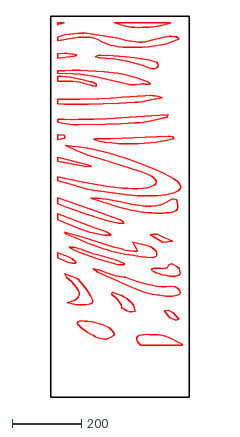
[picture p111: CAD file, 2026-10-30]
art/dancing/cut/S2-T7-B.dxf
400.0 x 1100.0
