MrMil/led-over-rj245/art/dxf/S1-T5-A.dxf

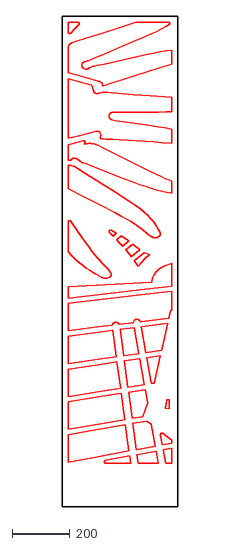
[picture p112: CAD file, 2026-10-22]
art/dxf/S1-T5-A.dxf
400.0 x 1700.0
