MrMil/led-over-rj245/art/eye/cut/S1-T5-D.dxf

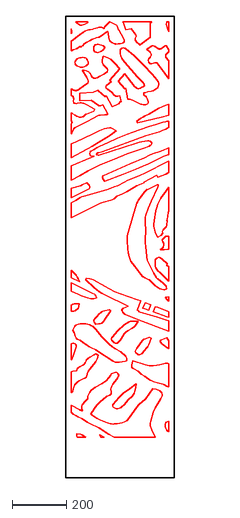
[picture p113: CAD file, 2026-10-28]
art/eye/cut/S1-T5-D.dxf
400.0 x 1700.0
