MrMil/led-over-rj245/art/praying/cut/S2-T3-D.dxf

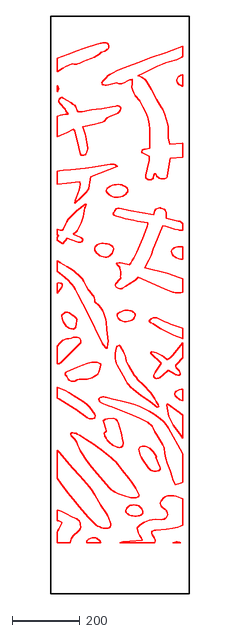
[picture p114: CAD file, 2026-10-28]
art/praying/cut/S2-T3-D.dxf
408.0 x 1700.0
