MrMil/led-over-rj245/art/sea/cut/S1-T4-A.dxf

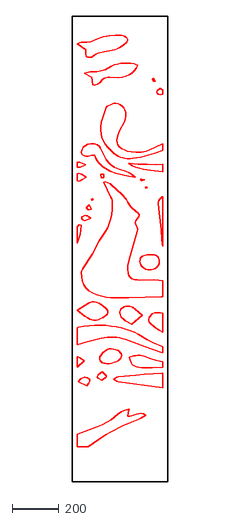
[picture p115: CAD file, 2026-10-28]
art/sea/cut/S1-T4-A.dxf
408.0 x 2000.0
