MrMil/led-over-rj245/art/dancing/cut/S2-T2-B.dxf

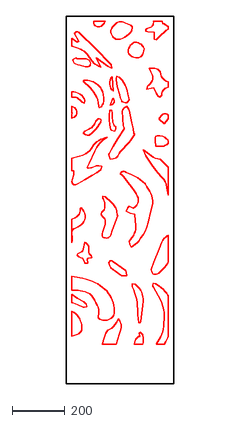
[picture p116: CAD file, 2026-10-30]
art/dancing/cut/S2-T2-B.dxf
408.0 x 1400.0
