MrMil/led-over-rj245/art/eye/cut/S1-T1-C.dxf

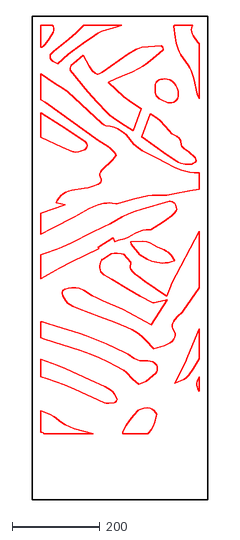
[picture p118: CAD file, 2026-10-28]
art/eye/cut/S1-T1-C.dxf
400.0 x 1100.0
