MrMil/led-over-rj245/art/praying/cut/S2-T2-D.dxf

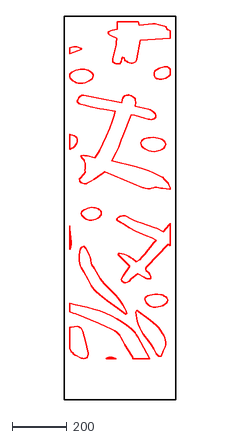
[picture p119: CAD file, 2026-10-28]
art/praying/cut/S2-T2-D.dxf
408.0 x 1400.0
