MrMil/led-over-rj245/art/sea/cut/S1-T2-A.dxf

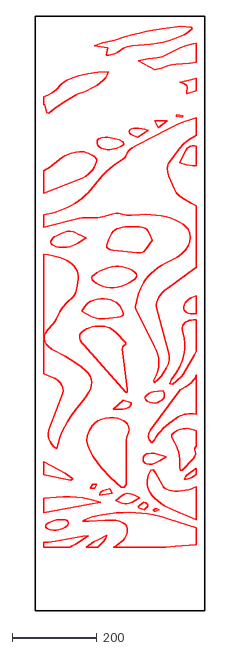
[picture p120: CAD file, 2026-10-28]
art/sea/cut/S1-T2-A.dxf
400.0 x 1400.0
