MrMil/led-over-rj245/art/dancing/cut/S2-T5-A.dxf

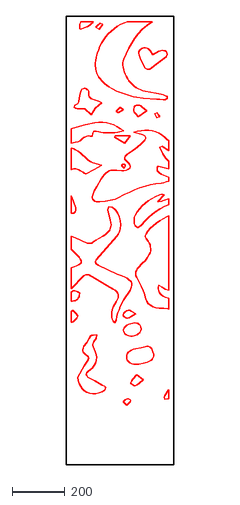
[picture p121: CAD file, 2026-10-30]
art/dancing/cut/S2-T5-A.dxf
408.0 x 1700.0
