MrMil/led-over-rj245/art/dxf/S2-T3-D.dxf

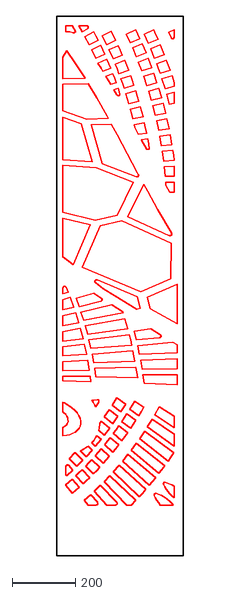
[picture p122: CAD file, 2026-10-22]
art/dxf/S2-T3-D.dxf
400.0 x 1700.0
