MrMil/led-over-rj245/art/eye/cut/S1-T6-D.dxf

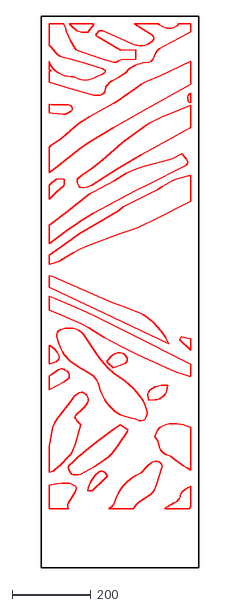
[picture p123: CAD file, 2026-10-28]
art/eye/cut/S1-T6-D.dxf
400.0 x 1400.0
