MrMil/led-over-rj245/art/praying/cut/S2-T2-C.dxf

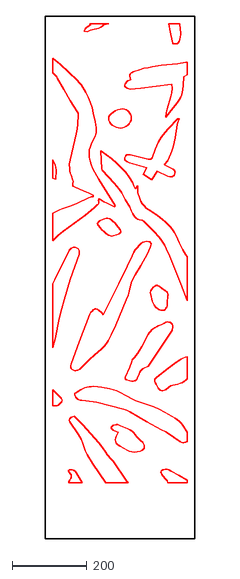
[picture p124: CAD file, 2026-10-28]
art/praying/cut/S2-T2-C.dxf
400.0 x 1400.0
