MrMil/led-over-rj245/art/sea/cut/S1-T4-B.dxf

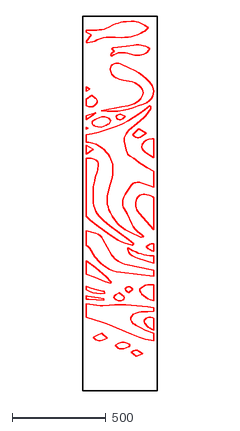
[picture p125: CAD file, 2026-10-28]
art/sea/cut/S1-T4-B.dxf
400.0 x 2000.0
