MrMil/led-over-rj245/art/dxf/S1-T3-B.dxf

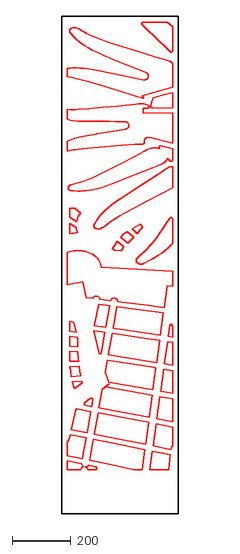
[picture p127: CAD file, 2026-10-22]
art/dxf/S1-T3-B.dxf
400.0 x 1700.0
