MrMil/led-over-rj245/art/dxf/S2-T4-D.dxf

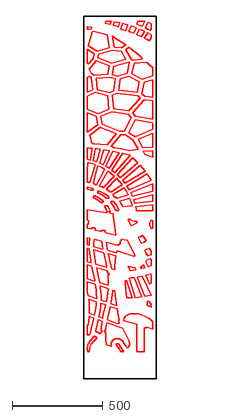
[picture p130: CAD file, 2026-10-22]
art/dxf/S2-T4-D.dxf
400.0 x 2000.0
