MrMil/led-over-rj245/art/dxf/S1-T1-D.dxf

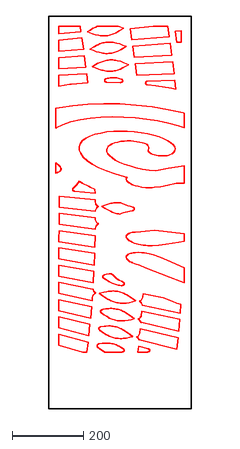
[picture p135: CAD file, 2026-10-22]
art/dxf/S1-T1-D.dxf
400.0 x 1100.0
