MrMil/led-over-rj245/art/dxf/S1-T7-D.dxf

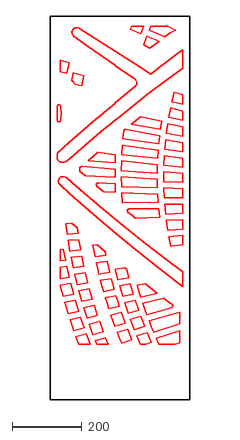
[picture p136: CAD file, 2026-10-22]
art/dxf/S1-T7-D.dxf
400.0 x 1100.0
