MrMil/led-over-rj245/art/dxf/S1-T6-D.dxf

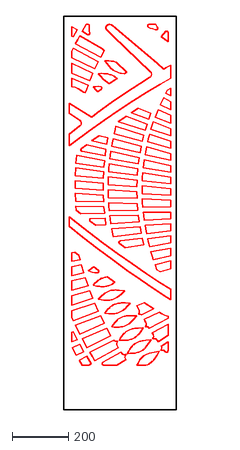
[picture p138: CAD file, 2026-10-22]
art/dxf/S1-T6-D.dxf
400.0 x 1400.0
