MrMil/led-over-rj245/art/dxf/S2-T1-B.dxf

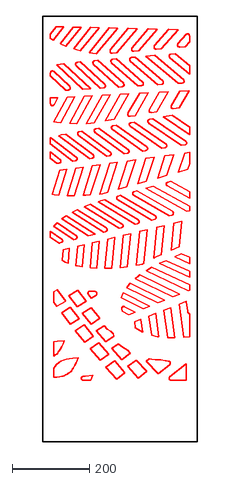
[picture p139: CAD file, 2026-10-22]
art/dxf/S2-T1-B.dxf
400.0 x 1100.0
