MrMil/led-over-rj245/art/dxf/S1-T1-C.dxf

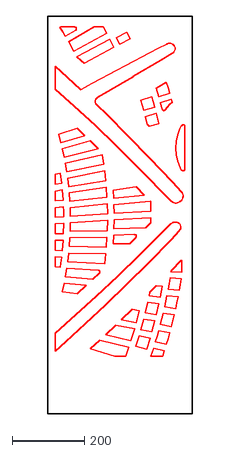
[picture p140: CAD file, 2026-10-22]
art/dxf/S1-T1-C.dxf
400.0 x 1100.0
