MrMil/led-over-rj245/art/dxf/S1-T7-A.dxf

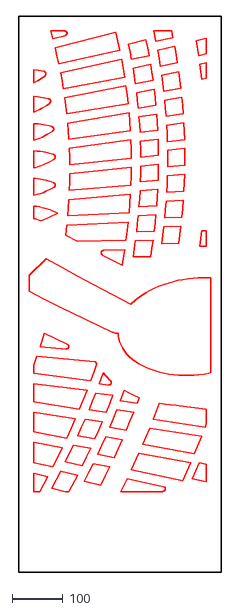
[picture p141: CAD file, 2026-10-22]
art/dxf/S1-T7-A.dxf
400.0 x 1100.0
