MrMil/led-over-rj245/art/dxf/S1-T5-B.dxf

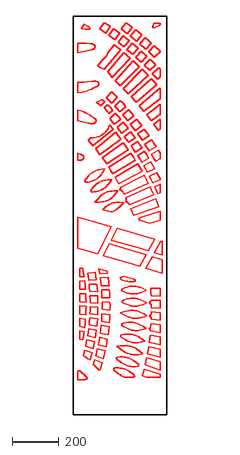
[picture p142: CAD file, 2026-10-22]
art/dxf/S1-T5-B.dxf
400.0 x 1700.0
