MrMil/led-over-rj245/art/dxf/S2-T1-A.dxf

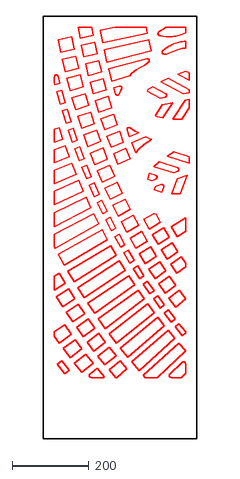
[picture p144: CAD file, 2026-10-22]
art/dxf/S2-T1-A.dxf
400.0 x 1100.0
