MrMil/led-over-rj245/art/dxf/S2-T5-C.dxf

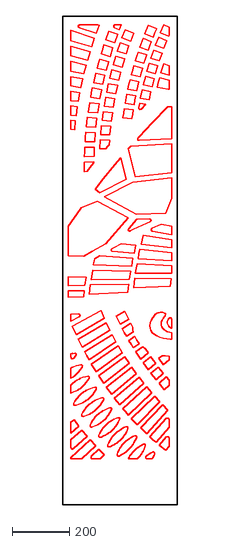
[picture p146: CAD file, 2026-10-22]
art/dxf/S2-T5-C.dxf
400.0 x 1700.0
