MrMil/led-over-rj245/art/dxf/S2-T5-B.dxf

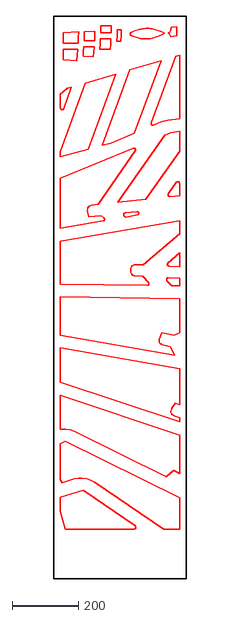
[picture p148: CAD file, 2026-10-22]
art/dxf/S2-T5-B.dxf
400.0 x 1700.0
