MrMil/led-over-rj245/art/dxf/S2-T3-A.dxf

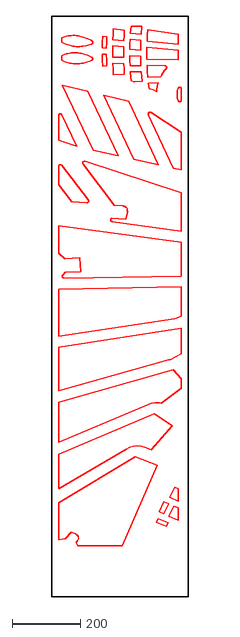
[picture p149: CAD file, 2026-10-22]
art/dxf/S2-T3-A.dxf
400.0 x 1700.0
