MrMil/led-over-rj245/art/dxf/S2-T6-A.dxf

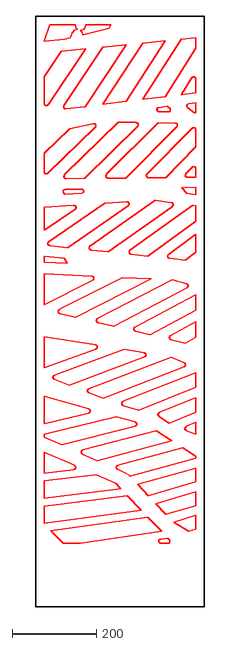
[picture p150: CAD file, 2026-10-22]
art/dxf/S2-T6-A.dxf
400.0 x 1400.0
