MrMil/led-over-rj245/art/dxf/S1-T7-C.dxf

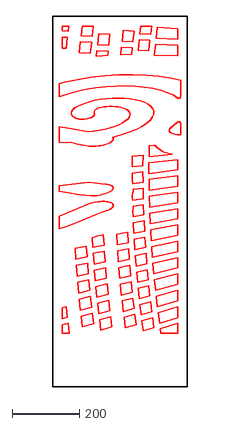
[picture p151: CAD file, 2026-10-22]
art/dxf/S1-T7-C.dxf
400.0 x 1100.0
