MrMil/led-over-rj245/art/dxf/S1-T4-A.dxf

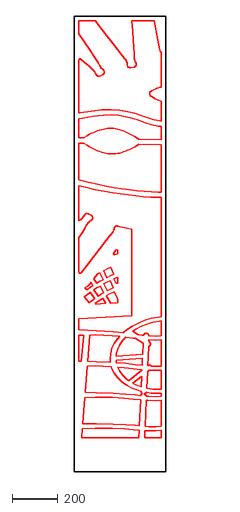
[picture p158: CAD file, 2026-10-22]
art/dxf/S1-T4-A.dxf
400.0 x 2000.0
