MrMil/led-over-rj245/art/dxf/S1-T5-C.dxf

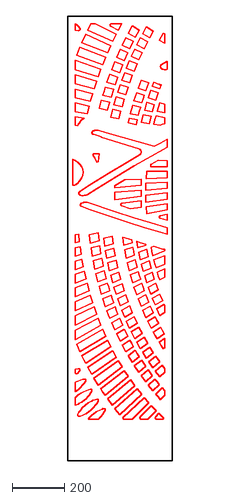
[picture p162: CAD file, 2026-10-22]
art/dxf/S1-T5-C.dxf
400.0 x 1700.0
