MrMil/led-over-rj245/art/dxf/S1-T6-C.dxf

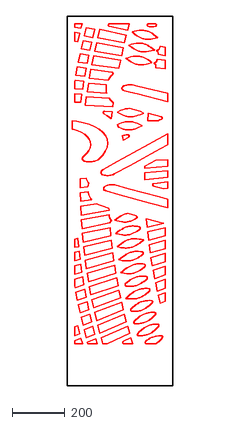
[picture p163: CAD file, 2026-10-22]
art/dxf/S1-T6-C.dxf
400.0 x 1400.0
