MrMil/led-over-rj245/art/dxf/S2-T3-C.dxf

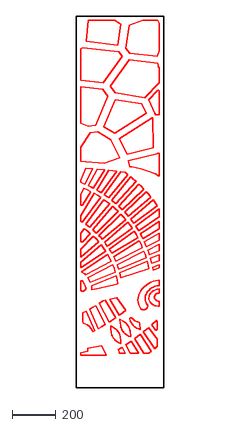
[picture p164: CAD file, 2026-10-22]
art/dxf/S2-T3-C.dxf
400.0 x 1700.0
