MrMil/led-over-rj245/guide/build.md

# Building and configuring the boxes

[← README](../README.md) · [Wiring](wiring.md) · [Parts](parts.md)

Workshop steps. [Restore a backup](#restore-a-backup) and
[prepare a spare ESP32](#prepare-a-spare-esp32) also apply in the field.

## Cutting the LED strips

56 face strips from 16 reels of 300 LEDs (5 m, 60/m). 15 reels are cut; the 16th stays whole
as the spare. Every face is one piece, no joins.

| LEDs | Length | Towers | Pieces |
|---|---|---|---|
| 111 | 1.85 m | T4 (2000) | 8 |
| 93 | 1.55 m | T3, T5 (1700) | 16 |
| 75 | 1.25 m | T2, T6 (1400) | 16 |
| 57 | 0.95 m | T1, T7 (1100) | 16 |

Lengths run from 150 mm above the bottom of the tower to its top.

**Cut list**, pieces in order from the reel's input end (arrows pointing away):

| Reels | Pieces | Cut after LED | Left |
|---|---|---|---|
| 8 | 93 · 93 · 57 · 57 | 93, 186, 243 | 0 |
| 4 | 111 · 111 · 75 | 111, 222, 297 | 3 |
| 3 | 75 · 75 · 75 · 75 | 75, 150, 225 | 0 |
| 1 | spare, uncut | | |

1. **Test each reel whole before cutting:** all 300 LEDs at low-brightness white, then a
   rainbow. Every LED lights, in the right colour.
2. A reel with a dead or wrong LED becomes the spare. Write the LED's number on it; its good
   stretches are still spare pieces.
3. **Count LEDs, don't measure.** The metre lengths are a check. Cut across the middle of the
   copper pads between two LEDs.
4. If a cut falls on a factory solder joint (the 75s reel, after LED 150, on some reels),
   separate the joint with the iron instead of cutting through it.
5. Label each piece at its input end with its LED count, and bundle by count.
6. **75, 93 and 111 pieces:** solder a male XT60 to 5V / GND at the far (output) end, for the
   top feed. 57 pieces get none.
7. Test each piece after cutting: every LED lights.

## 1. Enclosures

Print from [MrMil/electronics-enclosure](https://github.com/MrMil/electronics-enclosure):
two `100W-masterbox` (controller and the slave box). Each needs 3 RJ45 couplers, 7 tower data outputs
and 7 tower power outputs. PETG or ASA, not PLA.

## 2. Boards

Follow [wiring.md](wiring.md) and the diagrams there.

**Master box:**
- ESP32 board (breadboard-style, 30 rows), in this order along the board:
  - ESP32 on 2 × 1×15 female headers, at one end, over a mounting hole.
  - 74AHCT125 #1 in a socket.
  - 74AHCT125 #2 in a socket, at the other end, over the other mounting hole.
  The board is held by **one bolt**, in the hole under the ESP32. The hole under chip #2
  gets no bolt: that end rests on its standoff. To bolt or unbolt the board, pull the ESP32;
  the hex key goes in between its header strips. When pulling chip #2, hold that end of the
  board down.
- 7 × 100 Ω, standing upright: one lead in a free hole of the chip output's row (not on the
  chip leg, which must stay removable), the wire to the tower data output soldered to the
  top lead. Heat shrink over the resistor and that joint. Tie the 7 wires down so they don't
  pull on the resistors.
- Transmitter board: 7 MAX485 modules.

**Slave box:** 7 MAX485 receivers, 7 pairs of 560 Ω bias resistors, 7 × 100 Ω.

**Power boxes (1 tower power boxes in T3, T5; 2 tower power boxes in T2, T6; T4's part sits in the
master/slave box):** **the same board, 10 times.** One 74AHCT125 in a socket; gate 1 (pin 2 in,
pin 3 out) and gate 2 (pin 5 in, pin 6 out) each get a 560 Ω from the input to GND and a 100 Ω
on the output; pins 9 and 12 to GND. **The 560 Ω is not optional and must not be 10 kΩ:** it
ends the data cable, and with 10 kΩ the tower flashes at random. A board already built with
10 kΩ gets a 560 Ω soldered across it (in parallel); the 10 kΩ stays. Gate 1's output is joined to the 4 strand JST-SMs' DATA
leads. In a 2 tower power box gate 2's input gets the tip tower's data in and its output goes
to the tip-tower data out; in a 1 tower power box gate 2 gets no connectors and just sits at
0 V. Any board fits any box. Each diagram ends with the count of what goes into one box.

**Tip towers (T1, T7):** nothing to build. Their 4 JST-SM are the end of the tip-tower cable
(step 3).

Check each module's chip marking reads MAX485 (not 483/487/488/489). The controller's
74AHCT125s and all 100 Ω resistors are optional, depending on space; the power boxes' 560 Ω
are not. Keep a spare receiver
module and spare 74AHCT125s.

**Handling the 74AHCT125s.** Static kills single gates in them, and one dead gate heats the
chip until the others die too.
- Mains cord out before opening the box: one hand on the C13 plug, the other on the far
  side of the box. Never touch the PSU or its terminals for any reason.
- With the cord out, touch the GND pin of a data connector to discharge yourself before
  touching a chip, a socket or a data connector. Keep chips in their foam until they go in.
- Plug and unplug strips and data cables with the cord out.
- On a live board, measure only at a resistor's top lead or at a connector. Never put a probe
  on the chip's pins: an output pin has a grounded pin next to it, and a slip shorts it.
- Before fitting a chip, [test its gates](troubleshooting.md#testing-a-74ahct125).

## 3. Power wiring (10 power boxes)

4 [1 tower power boxes](img/power-box-1-tower.svg) and 4
[2 tower power boxes](img/power-box-2-tower.svg); each drawing lists what goes into one box.
C14 to the PSU, PSU to the 4 strand JST-SMs and the top-feed XT60, in the 2 tower power boxes
also the tip-tower XT60, and in the master/slave box a separate thin pair to the perfboard
([statue-power.svg](img/statue-power.svg) shows which box sits where). Make up the 4 tip-tower cables (power box in T2 → T1, in
T6 → T7, per statue), per [tip-tower-cable.svg](img/tip-tower-cable.svg): a 3 × 2.5 and a 22 AWG
pair taped together; at the box end a male XT60 on the 3 × 2.5, the pair bare for the box's data
out; at the tower end 4 JST-SM, the 5V leads soldered to the +5 V core, the GND leads and the
pair's GND to the GND core, the DATA leads to the pair's DATA. Heat shrink over every joint.
Make up 10 top-feed cables (3 × 1.5, one per tower T2–T6): male XT60 at the bottom;
at the top solder each cable core to 4 NYAF tails to 4 female XT60s, heat shrink over the joint.
Ferrules on every stranded wire that goes into a screw terminal.

## 4. Data cables

- Inside each box, cut a short patch cable for each of the 3 couplers and land its wires on
  the screw terminals using ferrules.
- With a meter, check every pin end to end, through both couplers and the long cable: pin N
  at the controller must reach pin N at the slave box, and no pin may touch another.
- Label both ends of each CAT5e cable (1, 2, 3) and each tower cable (S1-T1 … S2-T7).

## 5. WLED is already on the ESP32s

The controller ESP32 and its spare arrive with the installation's own WLED on them. **Do not
flash them**, not even from install.wled.me: the standard release flickers with 14 outputs.

Join **WLED-AP** (password `wled1234`), open `http://4.3.2.1`.

## 6. Configure WLED

### WiFi Setup

| Setting | Value |
|---|---|
| Network (client) | leave empty |
| AP SSID | the installation's name, nothing that says "WLED" |
| AP password | a new, strong password. Give it to the installation lead. **Never on the hardware, never in this repository.** |
| AP opens | **Always** (the default only opens it when no known network is found) |
| AP channel | a fixed channel: 1, 6 or 11 |

### LED Preferences

Fourteen outputs, **in this order**: statue 1 T1 → T7, then statue 2 T1 → T7, all type
WS281x. The installation's build sends all 14 together; ignore the RMT/I2S label on each
output.

| # | GPIO | Channel | LED count (one face) |
|---|---|---|---|
| 1 | 4 | S1-T1 | 57 |
| 2 | 13 | S1-T2 | 75 |
| 3 | 14 | S1-T3 | 93 |
| 4 | 16 | S1-T4 | 111 |
| 5 | 17 | S1-T5 | 93 |
| 6 | 18 | S1-T6 | 75 |
| 7 | 19 | S1-T7 | 57 |
| 8 | 21 | S2-T1 | 57 |
| 9 | 22 | S2-T2 | 75 |
| 10 | 23 | S2-T3 | 93 |
| 11 | 25 | S2-T4 | 111 |
| 12 | 26 | S2-T5 | 93 |
| 13 | 27 | S2-T6 | 75 |
| 14 | 32 | S2-T7 | 57 |

- LED count = **one face**: lit height (tower − 150 mm) × 60/m. All 4 faces get the same data.
  Correct the counts to the strips as fitted.
- Colour order **GRB** (check: the Rainbow look must not come out with red and green swapped).
- **Current:** WLED sees one face per output, the real draw is 4×. Set **LED current per LED
  (custom) to 118 mA** (4 × the measured 29.4 mA at full white), so WLED's estimate
  matches reality. **Maximum current: 0 on every output and globally** (WLED's own
  limiter stays off).
- **Defaults → apply preset at boot:** **18** (the show playlist in `wled/presets.json`).

### Presets

| Preset | Content |
|---|---|
| 10–99 | Workshop looks |
| 18 · Show | The playlist of looks 10–17, set as the boot preset. The file to restore is `wled/presets.json` in this repository |

## 7. Bench test

Both boxes, the three 20 m cables, a tower-base board with test strips on each tower output
in turn. The show for an hour. With a scope: RO on one receiver at the end of a 20 m cable should
show clean 350/700 ns pulses with no ringing. After the hour, a finger on every 74AHCT125: all
must be cold. A warm one has a dead gate: [replace it](troubleshooting.md#a-74ahct125-is-warm-or-hot).

## 8. Back up

**Config → Security & Updates → Backup presets** and **Backup configuration**. Save them in
this repository under `wled/` as `presets.json` and `cfg.json`.

WLED's backup never contains the AP password, so both files can go in as they are. This
repository may be public: never add the password to them.

## Restore a backup

Restores outputs, show and WiFi onto a mis-configured or replaced controller. Needs
`wled/cfg.json` and `wled/presets.json` already downloaded to the phone.

1. Join the controller's WiFi (or **WLED-AP** / `wled1234` on an ESP32 not set up yet) and
   open `http://4.3.2.1`.
2. **Config → Security & Updates → Restore configuration**: choose `cfg.json`. The
   controller restarts.
3. Re-join its WiFi (its name may have changed to the installation's), and set the AP
   password again under **WiFi Setup** if the backup had it blanked.
4. **Config → Security & Updates → Restore presets**: choose `presets.json`.
5. Start the show (preset 18) to check.

## Keep the spare ESP32 ready

It arrives with WLED on it. Restore both backups onto it, set the AP password, and label it
"SPARE, show loaded, <date>". Re-do it whenever the show changes.
