MrMil/led-over-rj245/(commit log)

2026-10-09 Initial electronics, wiring diagrams and documentation
    One ESP32 running WLED drives four statues: two channels local to
    statue 0 through a 74AHCT125, six over RS-485 (MAX485) on buried CAT5e
    to statues 1-3. Two chained strips per channel, four LED exits per box.
    - guide/: build-specific field guide (setup, operating,
    troubleshooting, wiring, parts, build)
    - guide/img/: wiring diagrams generated by tools/wiring_diagrams.py
    - docs/: design decisions and their reasons (meta-docs tree),
    with AGENTS.md / CLAUDE.md standing rules
2026-10-10 Two statues of 7 towers, one channel per tower, five supplies per statue
    Redesign from four statues to two V-shaped statues of 7 towers. One ESP32
    drives 14 channels (8 RMT + 6 I2S); statue 2's channels cross to box 2 as
    RS-485, three per CAT5e. Each tower base splits its channel to 4 faces
    with a 74AHCT125.
    Power: five S-100-5 per statue in their own boxes, mains from the apex,
    5 V per destination tower on 3x2.5 cable with XT60s, clean grouping by
    neighbours, firmware ceiling that scales the whole frame. Currents now
    from the WS2812B datasheet (36 mA/LED).
    - New diagrams: box 2, tower base, statue power; reworked the rest
    - Guide, docs and TODO.md updated to match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
    [wiring_diagrams.py]
2026-10-11 Record chosen parts, draw all 74AHCT125 pins, settle ESP32 board layout
    - Parts: 30-pin HW-394 ESP32 board, A-BL254-EG-Z15D headers, SN74AHCT125N
    (ordered) in A 14-LC-TT sockets; why BSS138 converter modules and the
    imported 2-core cables were rejected; why the 5 V runs use 3-core cable.
    - Diagrams: every 74AHCT125 pin drawn (VCC, GND, all four OE, unused gate),
    and the tower-base power input flagged so its GND visibly joins the data GND.
    - ESP32 board: ESP32 and chip #2 on female headers over the two mounting
    bolts in the centre channel; 100 ohm resistors upright in the output rows.
2026-10-18 Add the statue sightline and LED/power solver, publish it on GitHub Pages
    tools/statue_render.html: interactive Three.js page. Towers are placed so
    that neighbouring silhouettes touch from the centre of the circle; inputs
    in mm (side, seven heights, min/max/optimum spacing, circle diameter, free
    radius at the centre, eye height, field of view); a button computes the
    heights that put every tower top on one line from the eye; a second button
    computes metres of strip, 5 m reels (whole face strips only) and power
    supplies (no tower split) per side. Eye view and drone view, PNG export.
    renders/: headless Chrome frames of both views. index.html redirects the
    Pages root to the tool; .nojekyll skips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
2026-10-18 Record the 17–18 October design round: two statues final, five supplies per statue, output driver doubt
    Docs and guide: the two-statue layout is final (owner, 2026-10-18), heights
    950/1250/1600/2000; five S-100-5 supplies per statue feeding whole towers,
    JST-SM per strand, XT60 runs to the tip towers, no separate ground bond;
    tower data split in each supply box, passive bases at the tips; the WLED
    output-driver doubt after both RMT and I2S failed with 4 outputs on
    another project, with the bench test and candidate drivers in a new page
    docs/firmware/output_driver.md.
    Diagrams: tools/wiring_diagrams.py redrawn for the new power and data
    plan; box-power.svg and tower-base.svg become supply-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
    [wiring_diagrams.py]
2026-10-18 Sightline tool: individual spacings, JSON handoff, top-down view, labels beside towers
    Each of the six tower pairs gets its own spacing control; editing one marks
    the layout as set by hand, each arm is then solved with its own chords, and
    changing min/max/optimum asks before resetting (keep restores the values).
    Export / Load JSON (format led-over-rj245/statue-layout v1) carries every
    input, the solved positions in mm, LED counts and supply grouping;
    layout/statue-layout.json is the current export, regenerated with ?dump=1.
    Top-down orthographic view with the 1 m grid and a 1 m bar bottom right;
    labels moved beside the towers in the drone and top views.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
2026-10-18 Sightline tool: remember settings, restore defaults, sticky header, spacing 500/750/1000
    Settings are saved to localStorage after every change and restored on the
    next open; URL state parameters win and are never saved, so headless
    renders stay deterministic. Restore project defaults clears the store and
    reloads. The panel header with the Hide button is sticky. Spacing defaults
    are now 500 / 750 / 1000 mm (owner), at which the optimum fits; layout
    JSON and renders regenerated.
2026-10-18 Sightline tool: eye height down to 400 mm for seated viewers
2026-10-19 Sightline tool: statue 2 on its own, free tower dragging, undo, camera controls
    Statue 2 mirrors statue 1 until decoupled, then gets its own heights,
    spacings, positions, mural, level-top heights and LED/supply side.
    Towers can be dragged freely in the top-down view; solver settings then
    ask before re-solving, as hand-set spacings already did. Undo/redo stack
    of parameter snapshots (Ctrl/Cmd+Z). Eye view: right-drag, arrows/WASD or
    the on-screen pad walk; drone: right-drag or arrows pan, wheel or ± zoom;
    pressing the active view button resets its camera. JSON format version 2
    (statue2, free_positions_mm, side_2); version 1 files still load.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
2026-10-21 Final tower sizes and layout from the artist (2026-10-21), everywhere
    layout/statue-layout.json is the artist's export: heights 1100/1400/1700/
    2000, towers placed by hand in an 18 m circle (apexes 17.4 m apart, tips
    4.1 m from the centre), eye 1200 mm. The sightline tool now starts from it
    as the project default (?solved=1 starts from the solver instead).
    Docs, guide, diagrams and TODO follow: LED counts 57/75/93/111 per face,
    2244 LEDs and 37.4 m per statue, 16 reels, supplies A/E at 15.5 A worst
    case, trench segment lengths from the layout, generator worst case
    ~0.7 kW. The 10 m CAT5e cables cannot reach 17.4 m: the guide says 20 m,
    recorded as an agent change pending the owner's purchase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
    [wiring_diagrams.py]
2026-10-21 Sightline tool: bench at the centre, one eye point per statue
    The audience sits on a circular bench at the centre facing out (owner,
    2026-10-21; hence the 1200 mm eye). New bench-diameter control (default
    3000 mm, a placeholder until the artist gives the size). Each statue gets
    its own eye point on the bench edge: an eye-view button per statue, the
    figure placed at each point, and the mural, level-top heights, gaps and
    readout angles taken from that point. The solver places towers so they
    touch from the eye point. Bench clearance is checked and exported; files
    without a bench load with the eye at the centre.
2026-10-21 Add the projection maker: pictures per viewpoint become the cut faces, LED render, DXF export
    tools/projection_maker.html reads the layout handoff file and gives four
    viewpoints (bench seat per statue, back viewpoint per statue at a set
    distance behind the apex tower), each owning 14 faces. A raster (white =
    wood) or DXF (inside = cut) picture per viewpoint is stretched to the
    silhouette, shrinkable from each side, and projected onto the faces with a
    wood border; wood islands are reported per face. Towers render at night
    with a diffuser one plate thickness behind the cuts, lit by 60/m LEDs
    blended additively by height, driven by an animation registry (slow
    rainbow, all white). DXF export (R1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
2026-10-21 Bench defaults to 0 until known; projection maker mirrors statue 1, loads either JSON
    The bench placeholder (3000 mm) made the projection maker show gaps the
    artist never saw: her file has no bench, so her eye is at the centre and
    the towers touch. Both tools now default the bench to 0; the handoff file
    is regenerated. The projection maker gets a bench control, one Load button
    for the layout file or its own project file (which now embeds the layout),
    reads the layout tool's saved state on the same site, and statue 2's
    viewpoints mirror statue 1's picture and settings unless switched off.
2026-10-21 Keep the bench in the view: 3000 mm working default, files without a bench keep it
    Reverts the bench-to-0 default of the previous commit (a misreading of the
    owner: the bench must stay in the view). Both tools default to 3000 mm
    until the real size is known; loading a file that has no bench field keeps
    the current bench instead of removing it, so the artist's own saved file
    no longer puts the eye back at the centre. Handoff file and renders
    regenerated.
2026-10-21 Layout tool: "placed by hand" wording, no mode switch on a bare click, mirrored export
    The artist's layout is hand-placed, and labelling the default "moved
    freely" read as if the tool had moved her towers; it now says "placed by
    hand (as in the layout file, not solved)". A click on a tower in the
    top view no longer flips a solved layout into hand placement; only a real
    move does. While statue 2 mirrors statue 1 the export writes its positions
    as the mirror instead of a stale drag snapshot.
2026-10-21 One page: pictures cut into the faces over the LEDs, her distances on the rails, LED show basis
    The projection maker is folded into the layout tool (owner: one page, the
    LEDs in the layout decider, the actual cut when moving towers); the second
    page and its docs are removed. Four viewpoints (bench seat and back view
    per statue) each own 14 faces; a raster or DXF picture per viewpoint is
    stretched to the whole silhouette from that eye (owner's default, shrink
    controls per side; band fits remain as options) and projected onto the
    faces with a wood border; statue 2 mirrors statue 1's pictures unless
    decoupled; wood islands are reported per face; DXF export per viewpoint,
    tower, statue or everyt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
2026-10-22 Four pictures for the tower faces, generated as vector cut files; the tool opens with them
    A generator (tools/face_art.py) draws one picture per viewpoint, the owner's
    brief of 2026-10-22: a woman blessing with her arms stretched out (statue 1,
    bench), an open eye (statue 1, back), a bird with open wings and a third eye
    (statue 2, bench), a magical mushroom (statue 2, back). Everything is polygon
    geometry: figures in the picture plane, lattices in each plate's own millimetre
    frame, each plate mapped by the exact homography from its four corners (as the
    tool projects them, art/viewpoints.json) and written straight to DXF, one file
    per plate in art/dxf, with an SVG twin. No raster step touches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
    [S1-T1-A.dxf, S1-T1-B.dxf, S1-T1-C.dxf, S1-T1-D.dxf, S1-T2-A.dxf, S1-T2-B.dxf, S1-T2-C.dxf, S1-T2-D.dxf]
2026-10-22 Supply calculator: towers share a supply only as neighbours along the V
    Trenches run along the V and from the apex across the circle, and trenches never
    cross, so nothing is cabled across the inside of the V. The calculator counted the
    minimum over free pairings and so offered 4 supplies per statue with T2 + T6 on one
    supply. It now counts runs of neighbours in trench order only; the handoff file is
    regenerated (5 per side, version 4) and the docs and setup guide record the rule.
2026-10-23 Final layout of 2026-10-23 as the default; towers of 400 and 412 mm pieces
    The artist's final layout (2026-10-23) is the tool's default: her six
    spacings 1200/1700/1300/2200/1500/1000 on the solver's rails, bench
    3800 mm, spacing range to 2310, bench field of view 120°, back view
    3.2 m / 1460 mm / 90°. The badge reads "artist's spacings" rather than
    "set by hand", since the solver still places every tower.
    The tool opens with the demo smiley again: the generated pictures were
    made for the previous layout and the artist is drawing different art.
    They are left untouched; docs/art records them as superseded.
    Towers are built from two 400 mm pieces and two 412 mm pieces covering
    their edges,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
2026-10-23 Towers at 45° like the apex (the artist's choice); labels off, drone view on the circle
    The layout tool gains a third arm method: every tower keeps the apex
    tower's rotation and the next tower is placed where its real corners
    touch the previous one from the eye. It is the default now, with the
    owner's file of the artist's phone changes as layout/statue-layout.json
    (back viewpoint 3000 / 1200 mm, statue 2 with its own viewpoints so the
    artist can upload its pictures directly). Switching the method no longer
    asks to reset hand-set spacings. Circle and bench checks use each box's
    real nearest and farthest point.
    Tower labels are off by default; the drone view opens fitted to the
    circle (its h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
2026-10-24 14-output bench test passes with a parallel I2S bus in custom WLED
    Stock WLED's RMT and I2S drivers flicker with several outputs, so the
    controller now runs a custom WLED 16.0.1 build (../WLED, branch
    led-over-rj245) that sends all 14 outputs as one parallel I2S stream.
    On the bench every pin showed the right colour and first LED with no
    flashing while a phone loaded the AP.
    - docs/firmware/parallel_i2s_bus.md: the bus and why it is built so
    - output_driver.md: the bench test as run (one strip moved pin to pin,
    real lengths, 2D map) and its results; pass rule changed
    - bench/: step 0 MicroPython test; wled_bench.py writes the bench WLED
    config, presets and 14 x 111 ledmap, and a LittleF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
2026-10-24 WLED fork on GitHub; ESP32s ship pre-flashed, the crew never flashes
    - The custom WLED source is now MrMil/WLED, branch led-over-rj245
    (pushed from a shallow clone, so it starts at v16.0.1 with no history).
    - The controller ESP32 and its spare leave already flashed, so no
    firmware file is published; guide/build.md and parts.md tell the crew
    not to reflash, even from install.wled.me.
    - Two HW-394 boards checked: ESP32-D0WD-V3, 4 MB flash, no PSRAM.
2026-10-25 Palettes fixed, LEDs as light, sunless night, five tabs, playlists
    The simulated segment is now RGB-capable, so every palette renders. The
    diffusers bloom and each tower throws a coloured point light at night; by day
    the sun swamps both. The panel splits into Layout, Pictures, Animations, Power
    and File. A playlist of presets plays in the sim and exports as the
    controller's presets.json. The browser store is versioned so nobody has to
    restore defaults by hand.
2026-10-25 Strip cut list on 15 reels, one spare; top feed on every strip of 75+ LEDs
    All 56 faces fit on 15 reels (8 × 93/93/57/57, 4 × 111/111/75, 3 × 75×4),
    leaving the 16th whole as a field spare. Every strip of 75 LEDs or more
    (T2–T6) gets a top feed: one 3 × 2.5 cable per tower from its supply box,
    XT60 at the bottom, WAGOs and 4 XT60s at the top. 58 XT60 pairs in all;
    the voltage-drop test no longer decides anything.
    [wiring_diagrams.py]
2026-10-25 Power boxes named by their tower: "power box in T2" … "T6"
    The supply letters A–E were not memorable (owner). Every power box is now
    named by the tower it sits in, across the guide, the docs and the generated
    diagrams; "supply box" becomes "power box" and supply-box.svg power-box.svg.
2026-10-25 Palette swatch under the list; Restore effect defaults resets the palette too
    The swatch and the "Default (…)" label come from the firmware's own palette
    loader through two new module exports.
2026-10-25 Tower-only wiring checks, the controller's files, and the flash procedure
    Fourteen effects in the WLED fork (MrMil/WLED 59ea85b), "Statue 1 tower 1
    only" … "Statue 2 tower 7 only", replace the dropped test presets: pick a
    tower by name on the phone and it blinks red, green, blue, black alone. The
    browser sim gets a bus table so the effects find their tower there too;
    wled_fx.js rebuilt; the sweep's sampling stride fixed (7 missed 12 of 14
    columns).
    tools/wled_image.py writes wled/cfg.json (14 outputs, real pins and counts,
    AP "Layers-WLED" channel 6 always on, boot preset 18, limiter off) and
    wled/ledmap.json (14 × 111), and builds the LittleFS image with the password
    from the environmen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
    [wled_image.py]
2026-10-25 Cabling: why GND rides on the brown pair of every CAT5e, not just one
2026-10-28 Controller: dead-gate cascade in the 74AHCT125s, as-built jack map, striped wire to A
    Both controller chips ran hot and statue 1's towers went dark; the cause was gates failing
    short inside the chips, each dead gate heating the chip until the others died. Fresh chips
    restored all seven channels. Troubleshooting now has the symptom, the diode test for a chip,
    and the handling rules; the build steps get the same rules and a finger test after the bench
    run. The first gate's killer is unknown; the record in docs says what was ruled out.
    The guide now reads "call Ofer before opening any box"; the crew never opens one. Pull-downs
    on the controller chips' inputs are rejected.
    Statue 2's channels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
    [wiring_diagrams.py]
2026-10-28 Firmware: no current limiting; ten power boxes make an overload impossible
    Replaces the planned firmware current ceiling (never built) with the owner's decision of
    2026-10-26: whole towers on ten supplies keep every one under its sizing ceiling at full
    white, so WLED's limiter is off and nothing scales the frame.
2026-10-28 Artist's back drawings checked, supported and cut: the eye (statue 1) and the praying figure (statue 2)
    tools/check_art.py projects an artist's drawing onto every plate through the layout tool's own
    projection (extracted to art/<name>/<viewpoint>-projection.json) and checks it in millimetres:
    islands, wood held by necks under 15 mm, hairline specks. --support adds two 18 mm bars per loose
    piece in the drawing's own frame and bakes the tool inset in with marker squares; --cut writes the
    per-plate R12 cut files, the manifest and a picture of the plates.
    Eye: 0.13 bottom shrink, 58 bars, approved by the artist, who then filled the apex's bottom band;
    14 cut files in art/eye/cut. Praying: 0.02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
    [EyeFinal-supported-added.dxf, EyeFinal-supported.dxf, EyeFinal.dxf, Praying-supported.dxf, Praying.dxf, S1-T1-C.dxf, S1-T1-D.dxf, S1-T2-C.dxf]
2026-10-28 Wood is 4 mm: 408 mm boxes, the layout re-solved, the eye re-supported, both cut-file sets redone
    The owner went from 6 mm to 4 mm plywood, so the long pieces are 408 mm and the
    box 408 x 408 outside. The page's thickness default is 4 and the handoff file is
    its export of the defaults (dumped with ?dump=1&thick=4, which keeps the browser
    store out); towers move by millimetres only, nothing electrical changes.
    The back projections were re-extracted for the moved towers. The praying figure
    needed nothing; the eye gained one piece held by 14 mm on the apex, so the
    drawing of record is now EyeFinal-4mm-supported.dxf (two more bars, artist
    approved by phone). Both cut-file sets and zips are rege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
    [EyeFinal-4mm-supported.dxf, S1-T1-C.dxf, S1-T1-D.dxf, S1-T2-C.dxf, S1-T2-D.dxf, S1-T3-C.dxf, S1-T3-D.dxf, S1-T4-C.dxf]
2026-10-28 The sea drawing on the bench of statue 1, checked and cut; the 56 plates packed onto 14 sheets
    The artist's first bench drawing (SeaFinalll.dxf, her fix of the first file after the
    checker's supports wrecked the left ray's face) is checked on the bench projection with her
    shrinks (top 0.01, bottom 0.16) baked in, supported with 37 bars, approved, and cut:
    art/sea/cut/ and SeaFinalll-cut-files.zip. The tool, the handoff file and the published
    artifact open bench 1 with it; bench 2 keeps the smiley.
    The checker is unchanged: the rules written for this drawing (widened lanes, moved and shaved
    strokes, pockets left for the owner, crumb filling, bench plate order) were reverted by the
    owner and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
    [S1-T1-A.dxf, S1-T1-B.dxf, S1-T2-A.dxf, S1-T2-B.dxf, S1-T3-A.dxf, S1-T3-B.dxf, S1-T4-A.dxf, S1-T4-B.dxf]
2026-10-29 Soldered joints, the tip-tower cable, one-tower / two-tower boxes, mains on bought cords, and an inventory page for the crew
    - Every splice outside a screw terminal is soldered and heat-shrunk; the WAGO 221-415s leave the parts list.
    - T1 and T7 are fed by one made-up tip-tower cable: XT60 and the data pair at the box, the 4 strand JST-SMs soldered on at the tower. The neighbour-base diagram becomes tip-tower-cable.svg; XT60 pairs 58 → 54.
    - The field boxes are named one-tower box (T3, T5) and two-tower box (T2, T6).
    - Mains runs on bought extension cords chained tower to tower with a power strip at the end of each, ten identical kettle leads into the boxes, and cords packed for both ways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
2026-10-29 Box names everywhere, the mains chain in the overview, and a corner-to-corner site map in the README
    - The terms are master box, slave box, 1 tower power box and 2 tower power box, across the README, guide, docs, diagram generator and agent instructions; the apex diagrams are now master-box-wiring.svg and slave-box-wiring.svg.
    - wiring.md's mains bullet gives both ways of feeding the apexes; the overview draws mains as extension cords chained tower to tower, apart from the data lines.
    - README site map: the whole site on a 1 m grid and one statue enlarged, every step between towers drawn between the facing corners as its across and along legs, with the straight tape; the same numbers in a ta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
2026-10-29 One chip per power box, a drawing per kind of box, and top feeds on 3 × 1.5
    The combined power-box drawing is now two: power-box-1-tower.svg (T3, T5)
    and power-box-2-tower.svg (T2, T6), each ending with the count of what
    goes into one box, because the owner could not tell from the shared
    drawing what to build. Each box holds one 74AHCT125: gate 1's output is
    joined to the own tower's 4 strands, gate 2 drives the tip-tower cable in
    a 2 tower power box; no electronics in any tower (owner). Wiring tables,
    parts counts (10 chips, 14 × 100 Ω), build step, troubleshooting and
    docs follow, with the reversal of the per-face-gate decision recorded in
    docs/strips_and_power/tower_base.md.
    Top-feed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
    [wiring_diagrams.py]
2026-10-29 One board in every power box, and why a box may be off while the show runs
    Every power box now carries the same perfboard: one 74AHCT125 with 10 kΩ on
    pins 2 and 5 and 100 Ω on pins 3 and 6; the 1 tower and 2 tower power boxes
    differ only in the connectors fitted to gate 2. The 1 tower drawing shows
    gate 2's unfitted connectors as dashed outlines. Guide tables and counts
    follow. tower_base.md records the decision and, separately, why data into a
    switched-off box harms neither the chip nor the first LED.
2026-10-30 The dancing drawing on the bench of statue 2, checked and cut; all four viewpoints open with the artist's drawings
    art/dancing/: DancingFinal3.dxf (her third file of the night; bottom shrink 0.14, owner),
    bench2-projection.json (extracted, identical to bench 1), the supported copy with the shrink baked
    in (24 bars at 24 spots, 16 specks cut away), the check pictures, the 14 cut files S2-T<n>-<A|B>
    and DancingFinal3-cut-files.zip (approved 2026-10-30).
    tools/check_art.py: the loader follows a block inside a block (this export nests the drawing two
    deep and read as empty); no rule changed.
    tools/statue_render.html, layout/statue-layout.json: DancingFinal3-supported.dxf is the bench-2
    default;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
    [DancingFinal3-supported.dxf, DancingFinal3.dxf, S2-T1-A.dxf, S2-T1-B.dxf, S2-T2-A.dxf, S2-T2-B.dxf, S2-T3-A.dxf, S2-T3-B.dxf]
2026-10-30 560 Ω on every power-box data input: ends the cable; with 10 kΩ the strands flashed at random
    Both bench boxes, built alike with 10 kΩ, flashed every second or two over a 4 m data
    cable, on a solid colour too; the same strands straight on the cable were clean, a 15 cm
    cable was clean, 100 nF at the chip changed nothing, and 560 Ω across the 10 kΩ cured it.
    Design value 560 Ω; built boards keep the 10 kΩ with a 560 Ω across it. Drawings
    regenerated, wiring/build/parts/troubleshooting updated, bench record and rejected fixes
    in docs/strips_and_power/tower_base.md. Statue 2's MAX485-fed path is untested with it.
    [wiring_diagrams.py]
